eSpark-Consulting-Group/robertmeares-vcu-bcu/README.md

# robertMeares-VCU-BCU
PCB Rework on VCU/BCU
