eSpark-Consulting-Group/robertmeares-vcu-bcu/Client-Files/BCU-PCBA-main/BCU-PCBA-main/BCU-PCBA/CARRIER BOARD 2.0/GERBER/EMBL51745_PCB_CB_V2.0_DFM_202100719/SIENNA-8LAY-9JAN2021-20645.pdf

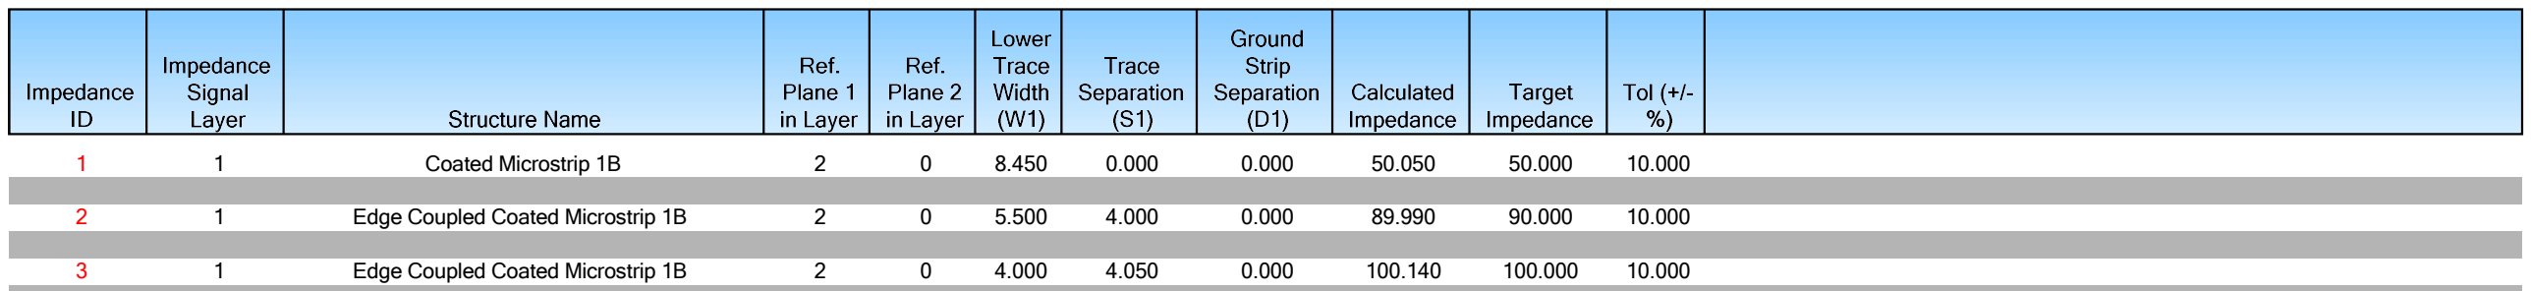
[picture p1: figure]
Coated Microstrip 1B; Edge Coupled Coated Microstrip 1B

StackName: Master
Version:
Date: 09-01-2021
Author:
Department: Engg. CAM
Site: www.hiqelectronics.com
Associated Documents: | Revision: | Modification: | Date of Revision: | Editor

Page
1/0
Copyright © | Print style & presentation copyright © Polar Instruments Ltd
Taiyo PSR 4000 HFX DI-GREEN | SolderMask | 1.000 | 3.500
1 | Copper Foil 12 microns | Copper | 1.850 | 100.000 | 1, 2, 3, 4, 5, 6, 7
Isola FR408 HR Prepreg 106-rc75 | Dielectric | 2.162 | 4.324 | 3.220
Isola FR408 HR Prepreg 106-rc75 | Dielectric | 2.162 | - | 3.220
2 | | | 0.689 | 60.000
Isola FR408 HR 8 mil core (2x3313)H/H | FR4 | 8.000 | 8.000 | 3.650
3 | | | 0.689 | 30.000 | 8, 9, 10, 11
Isola FR408 HR Prepreg 1080-rc65 | Dielectric | 2.921 | 7.942 | 3.420
Isola FR408 HR Prepreg 106-rc75 | Dielectric | 2.100 | - | 3.220
Isola FR408 HR Prepreg 1080-rc65 | Dielectric | 2.921 | - | 3.420
4 | | | 0.689 | 60.000
Isola FR408 HR 14 mil core H/H | FR4 | 14.000 | 14.000 | 3.780
5 | | | 0.689 | 60.000
Isola FR408 HR Prepreg 1080-rc65 | Dielectric | 2.921 | 7.942 | 3.420
Isola FR408 HR Prepreg 106-rc75 | Dielectric | 2.100 | - | 3.220
Isola FR408 HR Prepreg 1080-rc65 | Dielectric | 2.921 | - | 3.420
6 | | | 0.689 | 30.000 | 12, 13, 14, 15
Isola FR408 HR 8 mil core (2x3313)H/H | FR4 | 8.000 | 8.000 | 3.650
7 | | | 0.689 | 60.000
Isola FR408 HR Prepreg 106-rc75 | Dielectric | 2.162 | 4.324 | 3.220
Isola FR408 HR Prepreg 106-rc75 | Dielectric | 2.162 | - | 3.220
8 | Copper Foil 12 microns | Copper | 1.850 | 100.000 | 16, 17, 18, 19, 20, 21, 22
Taiyo PSR 4000 HFX DI-GREEN | SolderMask | 1.000 | 3.500 ⁶⁴.37 | 62.37
4 | 1 | Edge Coupled Coated Microstrip 2B | 3 | 0 | 4.100 | 4.800 | 0.000 | 120.060 | 120.000 | 10.000
5 | 1 | Coated Coplanar Strips With Lower Ground 1B | 2 | 0 | 7.500 | 0.000 | 8.000 | 50.210 | 50.000 | 10.000
6 | 1 | Coated Coplanar Strips With Lower Ground 2B | 3 | 0 | 20.000 | 0.000 | 8.000 | 49.940 | 50.000 | 10.000

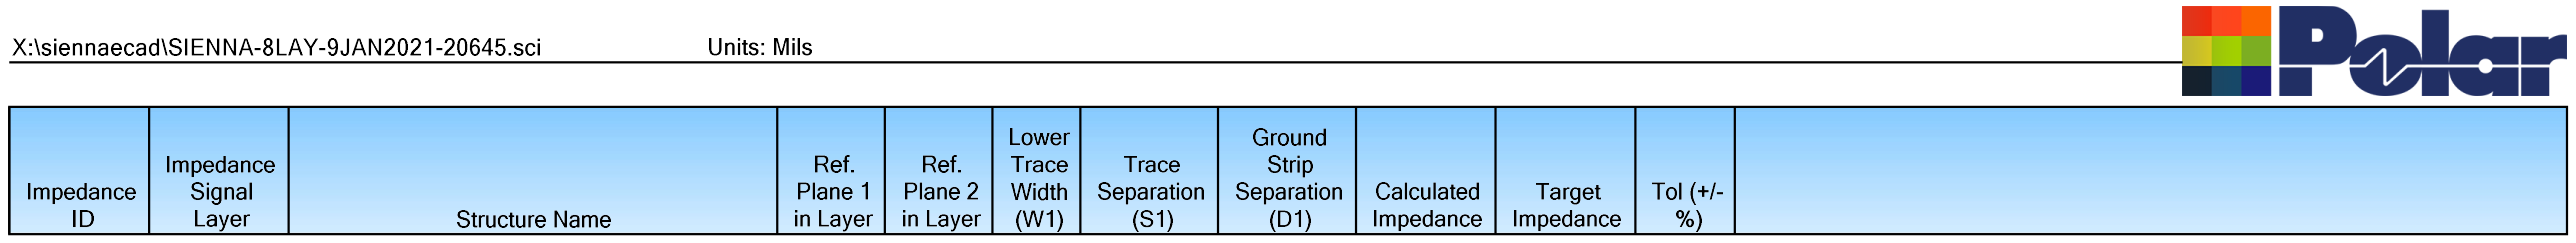
[picture p2: figure]

StackName:
Version:
Date: 09-01-2021
Author:
Department: Engg. CAM
Site: www.hiqelectronics.com
Associated Documents: | Revision: | Modification: | Date of Revision: | Editor

Page
2/0
Copyright © | Print style & presentation copyright © Polar Instruments Ltd
7 | 1 | Coated Coplanar Strips With Lower Ground 2B | 3 | 0 | 17.000 | 0.000 | 6.000 | 50.060 | 50.000 | 10.000
8 | 3 | Offset Stripline 1B1A | 2 | 4 | 8.150 | 0.000 | 0.000 | 49.990 | 50.000 | 10.000
9 | 3 | Edge Coupled Offset Stripline 1B1A | 2 | 4 | 6.100 | 4.000 | 0.000 | 90.140 | 90.000 | 10.000
10 | 3 | Edge Coupled Offset Stripline 1B1A | 2 | 4 | 4.550 | 4.000 | 0.000 | 100.020 | 100.000 | 10.000
11 | 3 | Offset Coplanar Strips 1B1A | 2 | 4 | 7.850 | 0.000 | 8.000 | 49.980 | 50.000 | 10.000
12 | 6 | Edge Coupled Offset Stripline 1B1A | 5 | 7 | 4.550 | 4.000 | 0.000 | 100.020 | 100.000 | 10.000
13 | 6 | Offset Stripline 1B1A | 5 | 7 | 8.150 | 0.000 | 0.000 | 49.990 | 50.000 | 10.000
14 | 6 | Edge Coupled Offset Stripline 1B1A | 5 | 7 | 6.100 | 4.000 | 0.000 | 90.140 | 90.000 | 10.000
15 | 6 | Offset Coplanar Strips 1B1A | 5 | 7 | 7.850 | 0.000 | 8.000 | 49.980 | 50.000 | 10.000
16 | 8 | Coated Microstrip 1B | 7 | 0 | 8.450 | 0.000 | 0.000 | 50.050 | 50.000 | 10.000
17 | 8 | Edge Coupled Coated Microstrip 1B | 7 | 0 | 4.000 | 4.050 | 0.000 | 100.140 | 100.000 | 10.000
18 | 8 | Edge Coupled Coated Microstrip 2B | 6 | 0 | 4.100 | 4.800 | 0.000 | 120.060 | 120.000 | 10.000
19 | 8 | Edge Coupled Coated Microstrip 1B | 7 | 0 | 5.500 | 4.000 | 0.000 | 89.990 | 90.000 | 10.000
20 | 8 | Coated Coplanar Strips With Lower Ground 2B | 6 | 0 | 20.000 | 0.000 | 8.000 | 49.940 | 50.000 | 10.000
21 | 8 | Coated Coplanar Strips With Lower Ground 2B | 6 | 0 | 17.000 | 0.000 | 6.000 | 50.060 | 50.000 | 10.000
22 | 8 | Coated Coplanar Strips With Lower Ground 1B | 7 | 0 | 7.500 | 0.000 | 8.000 | 50.210 | 50.000 | 10.000
