eSpark-Consulting-Group/robertmeares-vcu-bcu/Client-Files/BCU-PCBA-main/BCU-PCBA-main/BCU-PCBA/SECONDARY BOARD V2.1/GERBER/EMBL51745_PCB_SB_V2.1_DFM_20210914/Sienna- 4LYR-14Apr2K20-19615 -FR408HR---used.pdf

StackName: Master
Version:
Date: 14-04-2020
HANUMESH G: -
Department: Engg. CAM
Site: www.hiqelectronics.com
Associated Documents: | Revision: | Modification: | Date of Revision: | Editor

Page
1/1
Copyright © | Print style & presentation copyright © Polar Instruments Ltd
Taiyo PSR 4000 | SolderMask | 2.000 | | 4.400 | 0.0000
1 | 2.067 | 100.000 | 1, 2, 3, 4
Isola FR408 HR 5 mil core(1x2116) H/1 | FR4 | 5.000 | 5.000 | 3.670 | 0.0095
2 | 1.260 | 60.000
Isola FR408 HR Prepreg 3313 RC59 | Dielectric | 3.948 | 43.792 | 3.550 | 0.0000
Isola FR408 HR Prepreg 3313 RC59 | Dielectric | 3.948 | - | 3.550 | 0.0000
Isola FR408 HR 28 mil core H/H | FR4 | 28.000 | - | 3.730 | 0.0095
Isola FR408 HR Prepreg 3313 RC59 | Dielectric | 3.948 | - | 3.550 | 0.0000
Isola FR408 HR Prepreg 3313 RC59 | Dielectric | 3.948 | - | 3.550 | 0.0000
3 | 1.260 | 60.000
Isola FR408 HR 5 mil core(1x2116) 1/H | FR4 | 5.000 | 5.000 | 3.670 | 0.0095
4 | 2.067 | 100.000 | 5, 6, 7, 8
Taiyo PSR 4000 | SolderMask | 2.000 | | 4.400 | 0.0000

64.45

60.45

1 | 1 | Coated Microstrip 1B | 2 | 0 | 8.260 | 0.000 | 0.000 | 50.020 | 50.000 | 10.000
2 | 1 | Edge Coupled Coated Microstrip 1B | 2 | 0 | 5.400 | 5.000 | 0.000 | 90.300 | 90.000 | 10.000
3 | 1 | Edge Coupled Coated Microstrip 1B | 2 | 0 | 5.000 | 6.700 | 0.000 | 100.310 | 100.000 | 10.000
4 | 1 | Edge Coupled Coated Microstrip 1B | 2 | 0 | 4.000 | 11.200 | 0.000 | 120.110 | 120.000 | 10.000
5 | 4 | Coated Microstrip 1B | 3 | 0 | 8.260 | 0.000 | 0.000 | 50.020 | 50.000 | 10.000
6 | 4 | Edge Coupled Coated Microstrip 1B | 3 | 0 | 5.400 | 5.000 | 0.000 | 90.300 | 90.000 | 10.000
7 | 4 | Edge Coupled Coated Microstrip 1B | 3 | 0 | 5.000 | 6.700 | 0.000 | 100.310 | 100.000 | 10.000
8 | 4 | Edge Coupled Coated Microstrip 1B | 3 | 0 | 4.000 | 11.200 | 0.000 | 120.110 | 120.000 | 10.000
