eSpark-Consulting-Group/robertmeares-vcu-bcu/Client-Files/BCU-PCBA-main/BCU-PCBA-main/BCU-PCBA/SECONDARY BOARD V2.1/BOM/BOM_SB_BIU_S2 v2.2.xlsx

Index Revised: | 2022-11-18
Revision: | 2.2
Created by : | Suhas B
V2.2 | DNP Q3,Q4,R38,R39
V2.0 | Column I , J and K added for procrument of high lead time components
Note : Column J " In stock " status can be vary base on components availability on websites like digikey and mouser
Item | Quantity | Reference | Value | Description | Manufacturere's p/n | Manufacturer | Package | Component Type | In Stock | Lead time (weeks) | DNP | price per unit | Total Price | price per 1k units | Total price | Price per 100k units | Total price
1 | 17 | C1,C2,C4,C7,C8,C9,C11,C13,C18,C19,C20,C21,C22,C23,C24,C25,C33 | 0.1uF | CAP CER 0.1uF 16V 10% X7R 0402 | GRM155R71C104KA88J | MURATA | 402 | Capacitor | Yes | 19 | C22,C23,C24,C25 | $0.100 | $1.700 | $0.009 | $0.153 | $0.004 | $0.061
2 | 1 | C3 | 22uF | MLCC - SMD/SMT 22uF+/-20% 16V X5R | CL10A226MO7JZNC | SAMSUNG ELECTRO | 603 | Capacitor | Yes | 28 |  | $0.700 | $0.700 | $0.200 | $0.200 | $0.080 | $0.080
3 | 5 | C5,C10,C12,C14,C34 | 1uF | CAP CER 1uF 25V 10% X7R 0603 | CGA3E1X7R1E105K080AC | TDK | 603 | Capacitor | Yes | 14 |  | $0.170 | $0.850 | $0.037 | $0.185 | $0.015 | $0.074
4 | 6 | C6,C15,C16,C17,C26,C27 | 0.1uF | CAP CER 0.1UF 50V X7R 0603 | GRM188R72A104KA35D | MURATA | 603 | Capacitor | Yes | 31 |  | $0.280 | $1.680 | $0.060 | $0.360 | $0.024 | $0.144
5 | 3 | C30,C31,C32 | 1nF | CAP CER 1000PF 2KV X7R 1206 | CL31B102KJHNNNE | Samsung Electro-Mechanics | 1206 | Capacitor | Yes | 28 | C31,C32
6 | 4 | D18,D19,D20,D21 | RRE07VTM6SFHTR | RECTIFIER DIODES | RRE07VTM6SFHTR | Rohm Semiconductor | 2-SMD, Flat Lead | Diode | Yes | 15 | D20,D21 | $0.370 | $1.480 | $0.090 | $0.360 | $0.036 | $0.144
7 | 1 | J1 | FX23-20S-0.5SV | CONN RCPT 20POS SMD GOLD | FX23-20S-0.5SV | Hirose Electric Co Ltd | PTH/SMD | Connector | No | 12 |  | $2.700 | $2.700 | $1.450 | $1.450 | $0.580 | $0.580
8 | 1 | J2 | MX23A18NF1 | Automotive Connectors 18P Std Pin Header | MX23A18NF1 | JAE Electronics |  | Connector | Yes | 17 |  | $8.230 | $8.230 | $4.900 | $4.900 | $1.960 | $1.960
9 | 2 | L16,L22 | 220R@100MHz | FERRITEBEAD SMD Z100MHZ=600OHM 2 | BLM21SP601SH1D | Murata Electronics | 805 | Inductor | Yes | 19 |  | $0.290 | $0.580 | $0.090 | $0.180 | $0.036 | $0.072
10 | 4 | L18,L19,L20,L21 | MPZ2012S102AT000 | FERRITE BEAD 1 KOHM 0805 1LN | MPZ2012S102AT000 | TDK Corporation | 805 | Inductor | No | 10 | L20,L21 | $0.110 | $0.440 | $0.029 | $0.116 | $0.012 | $0.046
11 | 5 | L23,L24,L25,L26,L27 | BLM21AG121SZ1D | Ferrite Beads 0805 120ohms 1000mA Auto Infotainment | BLM21AG121SZ1D | Murata Electronics | 805 | Inductor | Yes | 8 |  | $0.140 | $0.700 | $0.040 | $0.200 | $0.016 | $0.080
12 | 2 | Q1,Q2 | TLX9000(TPL,F | Transistor Output Optocouplers Transistor Coupler Automotive; | TLX9000(TPL,F | Toshiba | SO-4 | Transistor | Yes | 7 |  | $2.900 | $5.800 | $1.100 | $2.200 | $0.440 | $0.880
13 | 13 | R1,R2,R3,R8,R9,R10,R15,R28,R29,R31,R33,R35,R37 | 10K | RES SMD 10K OHM 1% 1/10W 0603 | RCA060310K0FKEA | Vishay Dale | 603 | Resistor | Yes | 14 | R1,R35,R37 | $0.100 | $1.300 | $0.010 | $0.130 | $0.004 | $0.052
14 | 2 | R17,R19 | 1K | RES SMD 1K OHM 0.1% 1/10W 0603 | RT0603BRD071KL | Yageo | 603 | Resistor | Yes | 24 |  | $0.100 | $0.200 | $0.040 | $0.080 | $0.016 | $0.032
15 | 4 | R11,R12,R13,R14 | 0E | RES 0.0 OHM 1/16W 0402 SMD | CRCW04020000Z0ED | VISHAY | 402 | Resistor | Yes | 35 |  | $0.100 | $0.400 | $0.005 | $0.020 | $0.002 | $0.008
16 | 4 | R30,R32,R34,R36 | 47K | RES SMD 47K OHM 5% 1/10W 0603 | AC0603JR-0747KL | Yageo | 603 | Resistor | Yes | 29 | R34,R36 | $0.100 | $0.400 | $0.005 | $0.020 | $0.002 | $0.008
17 | 2 | R16,R18 | DNP | Thick Film Resistors - SMD 1/10Watt 0ohms | CRCW06030000Z0EAC | Vishay / Dale | 603 | Resistor | Yes | 24 | R16,R18 | $0.100 | $0.200 | $0.005 | $0.010 | $0.002 | $0.004
18 | 1 | U1 | TPS2024IDRQ1 | Power Switch ICs - Power Distribution Auto Cat Pwr-Dist Sw | TPS2024IDRQ1 | TI | SOIC-8 | IC | Yes | 16 |  | $2.460 | $2.460 | $1.130 | $1.130 | $0.452 | $0.452
19 | 1 | U2 | TCA6408AQPWRQ1 | Interface - I/O Expanders Automotive Low-Voltage 8-Bit I2C | TCA6408AQPWRQ1 | TI | TSSOP-16 | IC | Yes | 6 |  | $1.600 | $1.600 | $0.600 | $0.600 | $0.240 | $0.240
20 | 1 | U5 | TPL7407LADR | Gate Drivers 30-V, 7-Channel NMOS Array Low-Side Driver | TPL7407LADR | TI | SOP-16 | IC | Yes | 6 |  | $0.630 | $0.630 | $0.200 | $0.200 | $0.080 | $0.080
21 | 1 | U11 | ADS1015IDGSR | Analog to Digital Converters - ADC 12B ADC with Int MUX | ADS1015IDGSR | TI | MSOP-10 | IC | Yes | 35 |  | $2.660 | $2.660 | $1.330 | $1.330 | $0.532 | $0.532
22 | 1 | U12 | HDC2021DEBT | Board Mount Humidity Sensors Low-power humidity and temperature digital sensor | HDC2021DEBT | TI | 6-WSON | IC | Yes | 6 |  | $4.560 | $4.560 | $2.300 | $2.300 | $0.920 | $0.920
23 | 2 | U3,U4 | G6K-2F-Y-DC12 | Low Signal Relays - PCB Gullwing NoLatch 3.2 DPDT 12VDC 100mW | G6K-2F-Y-DC12 | Omron Electronics | 8-PIN RELAY | IC | Yes | 14 |  | $4.000 | $8.000 | $2.300 | $4.600 | $0.920 | $1.840
24 | 3 | U6,U13,U14 | G6L-1F-DC12 | Low Signal Relays - PCB LO PROF SPST 12VDC | G6L-1F-DC12 | Omron Electronics | 8-PIN RELAY | IC | Yes | 26 |  | $2.900 | $8.700 | $1.700 | $5.100 | $0.680 | $2.040
25 | 5 | D22,D23,D24,D25,D26 | LL4148-GS08 | DIODE GEN PURP 75V 300MA SOD80 | Vishay Semiconductor | LL4148-GS08 | Mini melf | Diode | Yes | 43 |  | $0.140 | $0.700 | $0.020 | $0.100 | $0.008 | $0.040
26 | 2 | Q3,Q4 | DNP | DNP | DNP | DNP | SOT-23 | DNP | Yes | 26
27 | 2 | R38,R39 | DNP | DNP | DNP | DNP | 603 | DNP | Yes | 20
Discussion of V2.2 |  |  |  |  |  |  |  |  |  |  |  | TOTAL | $56.670 |  | $25.924 |  | $10.370
Q3 and Q4 footprint in layout, schematic, and BOM all disagree.
V2.1 FOOTPRINT FOR Q3, Q4 |  |  |  | V2.1 SCHEMATIC | PINOUT FROM MMBT3904-TP DATASHEET
Solution:
DNP effected parts, could not find a sub.
26 | 2 | Q3,Q4 | MMBT3904-TP | TRANS NPN 40V 0.2A SOT23 | MMBT3904-TP | Micro Commercial Co | SOT-23 | Transistor | Yes | 26 |  | $0.140 | $0.280 | $0.029 | $0.057 | $0.011 | $0.023
27 | 2 | R38,R39 | 1K2 | RES SMD 1.2K OHM 1% 1/10W 0603 | RC0603FR-071K2L | Yageo | 603 | Resistor | Yes | 20 |  | $0.100 | $0.200 | $0.004 | $0.008 | $0.002 | $0.003
