eSpark-Consulting-Group/robertmeares-vcu-bcu/BOM_CB_BIU_S2v2.0_Changes.xlsx

Sheet: CARRIER_BOARD_S2_V2.0
1 | 2 | C1,C142 | 22uF | CAP CER 22UF 10V X5R 0805 | TDK Corporation | C2012X5R1A226M125AB | 805 | Capacitor | Yes | 13 |  | 0.310 | 0.620 | 0.135 | 0.270 | 0.054 | 0.108 | #VALUE!
2 | 5 | C2,C3,C4,C5,C6 | 4.7uF | CAP CER 4.7UF 10V X5R 0603 | TDK Corporation | C1608X5R1A475K080AE | 603 | Capacitor | Yes | NA |  | 0.290 | 1.450 | 0.074 | 0.370 | 0.030 | 0.148
3 | 43 | C7,C10,C11,C12,C13,C16,C19,C20,C23,C24,C25,C26,C30,C33,C35,C36,C38,C39,C40,C41,C43,C44,C46,C49,C53,C54,C55,C56,C57,C58,C59,C60,C71,C75,C77,C80,C100,C111,C125,C130,C131,C132,C148 | 100nF | CAP CER 0402 0.1UF 16V X7R 10% | KEMET | C0402C104K4REC7867 | 402 | Capacitor | Yes | 19 |  | 0.120 | 5.160 | 0.220 | 9.460 | 0.088 | 3.784
4 | 2 | C8,C9 | 10uF | CAP CER 10UF 10V X5R 0603 | Samsung Electro-Mechanics | CL10A106KP8NNNC | 603 | Capacitor | No | 28 |  | 0.210 | 0.420 | 0.040 | 0.080 | 0.016 | 0.032
5 | 2 | C14,C15 | 15pF | CAP CER 15PF 100V NP0 0805 | AVX Corporation | 08051A150FAT2A | 805 | Capacitor | Yes | 17 |  | 0.590 | 1.180 | 0.170 | 0.340 | 0.068 | 0.136
6 | 4 | C17,C18,C27,C28 | 10uF | CAP CER 10UF 16V X5R 0603 | Taiyo Yuden | EMK107BBJ106MA-T | 603 | Capacitor | Yes | 16 |  | 0.340 | 1.360 | 0.089 | 0.356 | 0.036 | 0.142
7 | 4 | C21,C22,C86,C87 | 10nF | CAP CER 10000PF 50V X7R 0402 | KEMET | C0402C103K5RAC7411 | 402 | Capacitor | Yes | 24 |  | 0.100 | 0.400 | 0.008 | 0.032 | 0.003 | 0.013
8 | 1 | C29 | 22uF | CAP CER 22UF 10V X5R 0805 | Samsung Electro-Mechanics | CL21A226KPCLRNC | 805 | Capacitor | Yes | 28 |  | 0.100 | 0.100 | 0.015 | 0.015 | 0.006 | 0.006
9 | 3 | C34,C42,C45 | 1nF,2KV | CAP CER 1000PF 2KV X7R 1206 | Samsung Electro-Mechanics | CL31B102KJHNNNE | 1206 | Capacitor | Yes | 28 |  | 0.300 | 0.900 | 0.080 | 0.240 | 0.032 | 0.096
10 | 7 | C37,C98,C99,C109,C110,C145,C146 | 47uF | CAP CER 47UF 16V X5R 1210 | Taiyo Yuden | EMK325BJ476MM-P | 1210 | Capacitor | Yes | 9 | C146 | 0.680 | 4.760 | 0.216 | 1.512 | 0.086 | 0.605
11 | 2 | C47,C50 | 100uF | CAP CER 100UF 16V X5R 1210 | Taiyo Yuden | EMK325ABJ107MM-P | 1210 | Capacitor | Yes | 22 |  | 1.600 | 3.200 | 0.613 | 1.226 | 0.245 | 0.490
12 | 1 | C72 | 100uF | CAP CER 100UF 10V X5R 1206 | TDK Corporation | C3216X5R1A107M160AC | 1206 | Capacitor | Yes | 18 |  | 1.030 | 1.030 | 0.370 | 0.370 | 0.148 | 0.148
13 | 2 | C48,C51 | 1nF | CAP CER 1000PF 50V X7R 0402 | KEMET | C0402S102K5RAC7867 | 402 | Capacitor | Yes | 21 |  | 0.470 | 0.940 | 0.123 | 0.246 | 0.049 | 0.098
14 | 4 | C52,C63,C67,C69 | 10uF | CAP CER 10UF 10V X5R 0603 | Murata Electronics | GRM188R61A106KE69D | 603 | Capacitor | Yes | 22 |  | 0.200 | 0.800 | 0.042 | 0.168 | 0.017 | 0.067
15 | 2 | C64,C68 | 0.33uF | CAP CER 0.33UF 16V X7R 0603 | TDK Corporation | C1608X7R1C334K080AC | 603 | Capacitor | Yes | 35 |  | 0.120 | 0.240 | 0.023 | 0.046 | 0.009 | 0.018
16 | 1 | C76 | 22uF | CAP CER 22UF 10V X7R 1206 | Samsung Electro-Mechanics | CL31B226MPHNNNE | 1206 | Capacitor | Yes | 28 |  | 0.350 | 0.350 | 0.100 | 0.100 | 0.040 | 0.040
17 | 8 | C78,C79,C81,C82,C83,C84,C85,C147 | 100PF | CAP CER 100PF 50V NP0 0603 | TDK Corporation | C1608NP01H101J080AA | 603 | Capacitor | No | 19 | C78,C79,C81,C82,C83,C84,C85,C147 | 0.180 | 1.440 | 0.039 | 0.312 | 0.016 | 0.125
18 | 4 | C88,C89,C90,C92 | 4.7uF | CAP CER 4.7UF 50V X5R 1210 | Taiyo Yuden | UMK325BJ475MM-T | 1210 | Capacitor | Yes | 8 |  | 0.710 | 2.840 | 0.190 | 0.760 | 0.076 | 0.304
19 | 7 | C91,C96,C97,C107,C108,C143,C144 | 100nF | CAP CER 0.1UF 100V X7R 0603 | Murata Electronics | GRJ188R72A104KE11D | 603 | Capacitor | Yes | 19 |  | 0.280 | 1.960 | 0.570 | 3.990 | 0.228 | 1.596
20 | 1 | C93 | 2.2uF | CAP CER 2.2UF 50V X5R 1206 | Taiyo Yuden | UMK316BJ225KD-T | 1206 | Capacitor | Yes | 11 |  | 0.290 | 0.290 | 0.060 | 0.060 | 0.024 | 0.024
21 | 1 | C94 | 100uF | CAP ALUM 100UF 20% 35V SMD | Nichicon | UCL1V101MCL6GS | SMD | Capacitor | Yes | 29 | C94 | 0.620 | 0.620 | 0.410 | 0.410 | 0.164 | 0.164
22 | 2 | C95,C106 | 10uF | CAP CER 10UF 35V X7R 1206 | TDK Corporation | C3216X7R1V106K160AC | 1206 | Capacitor | Yes | 24 |  | 0.700 | 1.400 | 0.250 | 0.500 | 0.100 | 0.200
23 | 2 | C101,C112 | 2.2uF | CAP CER 2.2UF 10V X7R 0603 | TDK Corporation | C1608X7R1A225K080AC | 603 | Capacitor | Yes | 21 |  | 0.200 | 0.400 | 0.040 | 0.080 | 0.016 | 0.032
24 | 3 | C102,C113,C139 | 0.1UF | CAP CER 0402 0.1UF 16V X7R 10% | KEMET | C0402C104K4REC7867 | 402 | Capacitor | Yes | 19 | C102,C113,C139 | 0.120 | 0.360 | 0.022 | 0.066 | 0.009 | 0.026
25 | 2 | C103,C114 | 3.9uF | CAP CER 3.9PF 100V NP0 0603 | AVX Corporation | 06031A3R9CAT2A | 603 | Capacitor | Yes | 16 |  | 0.240 | 0.480 | 0.050 | 0.100 | 0.020 | 0.040
26 | 2 | C104,C115 | 1000pF | CAP CER 1000PF 100V C0G 0603 | TDK Corporation | C1608C0G2A102J080AA | 603 | Capacitor | Yes | 27 |  | 0.190 | 0.380 | 0.400 | 0.800 | 0.160 | 0.320
27 | 3 | C116,C117,C118 | 1nF | CAP CER 1000PF 2KV X7R 1206 | Samsung Electro-Mechanics | CL31B102KJHNNNE | 1206 | Capacitor | Yes | 28 |  | 0.340 | 1.020 | 0.080 | 0.240 | 0.032 | 0.096
28 | 1 | C126 | 3pF | CAP CER 3PF 50V C0G/NP0 0402 | Murata Electronics | GJM1555C1H3R0WB01D | 402 | Capacitor | Yes | 15 |  | 0.240 | 0.240 | 0.056 | 0.056 | 0.022 | 0.022
29 | 1 | C127 | 0.8pF | CAP CER 0.8PF 50V C0G/NP0 0402 | Johanson Technology Inc. | 500R07S0R8AV4T | 402 | Capacitor | Yes | 14 |  | 0.260 | 0.260 | 0.055 | 0.055 | 0.022 | 0.022
30 | 2 | C128,C129 | 3PF | CAP CER 3PF 50V C0G/NP0 0402 | Murata Electronics | GJM1555C1H3R0WB01D | 402 | Capacitor | Yes | 15 | C128,C129 | 0.240 | 0.480 | 0.560 | 1.120 | 0.224 | 0.448
31 | 2 | C140,C141 | 2.2PF | CAP CER 2.2PF 50V C0G/NP0 0402 | Samsung Electro-Mechanics | CL05C2R2BB5NNNC | 402 | Capacitor | Yes | 15 | C140,C141 | 0.100 | 0.200 | 0.010 | 0.020 | 0.004 | 0.008
32 | 1 | C134 | 1uF | 1µF ±10% 25V Ceramic Capacitor X5R 0603 (1608 Metric) | Samsung Electro-Mechanics | CL10A105KA8NNNC | 603 | Capacitor | Yes | 28 |  | 0.100 | 0.100 | 0.008 | 0.008 | 0.003 | 0.003
33 | 7 | C62,C70,C74,C135,C136,C137,C138 | 33pF | 33pF ±5% 50V Ceramic Capacitor C0G, NP0 0603 (1608 Metric) | KEMET | C0603C330J5GACTU | 603 | Capacitor | Yes | 23 |  | 0.150 | 1.050 | 0.028 | 0.196 | 0.011 | 0.078
34 | 4 | D1,D2,D3,D34 | PESD2CAN | TVS DIODE 24V 41V SOT23 | Nexperia USA Inc. | PESD2CAN,215 | SOT23 | Diode | Yes | 26 |  | 0.420 | 1.680 | 0.100 | 0.400 | 0.040 | 0.160
35 | 1 | D4 | PZU3.9B2A,115 | DIODE ZENER 3.9V 320MW SOD323 | Nexperia USA Inc. | PZU3.9B2A,115 | SOD-323 | Diode | Yes | 26 |  | 0.210 | 0.210 | 0.016 | 0.016 | 0.006 | 0.006
36 | 16 | D5,D6,D8,D10,D11,D12,D13,D15,D17,D19,D20,D21,D23,D25,D31,D33 | BAS316,115 | DIODE GEN PURP 100V 250MA SOD323 | Nexperia USA Inc. | BAS316,115 | SOD-323 | Diode | No | 26 |  | 0.120 | 1.920 | 0.020 | 0.320 | 0.008 | 0.128
37 | 9 | D7,D9,D14,D16,D18,D22,D24,D27,D32 | DIODE TS BI-DIR | TVS DIODE 14V 23.2V DO214AC | Vishay Semiconductor Diodes Division | SMAJ14CA-E3/61 | DO-214AC, SMA | Diode | Yes | 40 |  | 0.410 | 3.690 | 0.100 | 0.900 | 0.040 | 0.360
38 | 1 | D30 | LL4148-GS08 | DIODE GEN PURP 75V 300MA SOD80 | Vishay Semiconductor | LL4148-GS08 | Mini melf | Diode | Yes | 43 |  | 0.140 | 0.140 | 0.020 | 0.020 | 0.008 | 0.008
39 | 2 | D28,D29 | SMBJ28A-13-F | TVS DIODE 28V 45.4V SMB | Diodes Incorporated | SMBJ28A-13-F | DO-214AA, SMB | Diode | Yes | 27 |  | 0.410 | 0.820 | 0.100 | 0.200 | 0.040 | 0.080
40 | 1 | E1 | ACAG0301-24505500-T | RF ANT 2.4GHZ/5.5GHZ CHIP SLD | Abracon LLC | ACAG0301-24505500-T | SMD | Antenna | Yes | 15 |  | 1.840 | 1.840 | 0.900 | 0.900 | 0.360 | 0.360
41 | 1 | E2 | ACAR3705-S698 | LTE anteena | Abracon LLC | ACAR3705-S698 | SMD | Antenna | Yes | NA |  | 4.620 | 4.620 | 3.300 | 3.300 | 1.320 | 1.320
42 | 1 | F1 | 5A | FUSE BRD MNT 5A 32VAC 75VDC 1206 | Littelfuse Inc. | 0458005.DR | 1206 | Fuse | Yes | 13 |  | 1.380 | 1.380 | 0.600 | 0.600 | 0.240 | 0.240
43 | 1 | F2 | 1A | FUSE BRD MNT 1A 48VAC 75VDC 1206 | Littelfuse Inc. | 0458001.DR | 1206 | Fuse | Yes | 13 |  | 1.380 | 1.380 | 0.600 | 0.600 | 0.240 | 0.240
44 | 1 | J1 | A829-1J1T-KM | MAGJACK 1PORT 1GBT LED, Auto-Ethernet | Bel Fuse Inc. | A829-1J1T-KM | Through Hole | Connector | Yes | 16 |  | 6.300 | 6.300 | 3.850 | 3.850 | 1.540 | 1.540
45 | 1 | J2 | MX50B19NQ1 | Automotive HDMI Type E Connector, 19 pos., Receptacle, Without Flange | JAE Electronics | MX50B19NQ1 | PTH | Connector | Yes | 18 |  | 5.400 | 5.400 | 3.160 | 3.160 | 1.264 | 1.264 |  | https://findcomponents.net/MX50B19NQ1
46 | 1 | J3 | 484060003 | USB Connectors USB 3.0 Type A Stacked R/A DIP | Molex | 484060003 | PTH | Connector | Yes | 20 |  | 2.100 | 2.100 | 1.180 | 1.180 | 0.472 | 0.472
47 | 1 | J4 | PJS008-2003-0 | Memory Card Connectors REVERSE MNT MICRO SD PUSH-PUSH TYPE | Yamaichi Electronics | PJS008-2003-0 | SMD | Connector | Yes | 9 |  | 3.080 | 3.080 | 1.590 | 1.590 | 0.636 | 0.636
48 | 1 | J5 | HTSW-105-07-G-D | CONN HEADER VERT 10POS 2.54MM | Samtec Inc. | HTSW-105-07-G-D | 10 PIN PTH | Connector | Yes | 10 |  | 1.280 | 1.280 | 0.700 | 0.700 | 0.280 | 0.280
49 | 1 | J6 | FMS006 - 2610 - 0 | PUSH-PUSH SIM CARD CONNECTOR, SM | Yamaichi Electronics | FMS006 - 2610 - 0 | SMD | Connector | Yes | 15 |  | 1.860 | 1.860 | 1.130 | 1.130 | 0.452 | 0.452
50 | 1 | J7 | MX23A26NF1 | Automotive Connectors 26P Std Pin Header | JAE Electronics | MX23A26NF1 | PTH | Connector | No | 14 |  | 8.230 | 8.230 | 4.900 | 4.900 | 1.960 | 1.960
51 | 1 | J10 | FX23-20P-0.5SV15 | CONN HDR 20POS SMD GOLD | Hirose Electric Co Ltd | FX23-20P-0.5SV15 | PTH/SMD | Connector | Yes | 12 |  | 3.560 | 3.560 | 1.920 | 1.920 | 0.768 | 0.768
52 | 1 | J12 | RECE-20279-001E-01 | CONN UMC RCPT STR 50 OHM SMD | Taoglas Limited | RECE.20279.001E.01 | SMD | Connector | Yes | 14 |  | 0.900 | 0.900 | 0.750 | 0.750 | 0.300 | 0.300
53 | 1 | J13 | U.FL-R-SMT-1 | RF Connectors / Coaxial Connectors SMT ML REC AU 50 OHM W/ANTI SLDR WCKNG RL | Hirose Connector | U.FL-R-SMT-1(10) | SMD | Connector | Yes | 12 | J13 | 1.220 | 1.220 | 0.670 | 0.670 | 0.268 | 0.268
54 | 1 | J14 | DNP | DNP | DNP | DNP | DNP | DNP | Yes
55 | 1 | J16 | SJ107054 | CONN HEADER BRD EDGE 2POS 3.5MM | JAE Electronics | MX44002NF1 | PTH | HEADER Connector | Yes | 14 |  | 4.850 | 4.850 | 2.812 | 2.812 | 1.125 | 1.125
56 | 3 | L1,L18,L19 | 33R@100MHz | FERRITE BEAD 33 OHM 0603 1LN | Murata Electronics | BLM18PG330SH1D | 603 | Inductor | Yes | 22 |  | 0.800 | 2.400 | 0.360 | 1.080 | 0.144 | 0.432
57 | 3 | L4,L5,L6 | PE-1812ACC510STS | CMC 230MA 2LN 3.5 KOHM AEC-Q200 | Pulse Electronics Network | PE-1812ACC510STS | Horizontal, 4 PC Pad | Inductor | Yes | 18 |  | 0.920 | 2.760 | 0.540 | 1.620 | 0.216 | 0.648
58 | 6 | L7,L9,L11,L12,L13,L14 | 220R@100MHz | FERRITE BEAD 220 OHM 0603 1LN | Murata Electronics | BLM18EG221TN1D | 603 | Inductor | Yes | 11 |  | 0.200 | 1.200 | 0.060 | 0.360 | 0.024 | 0.144
59 | 2 | L8,L10 | MCZ1210DH900L2TA0G | CMC 100MA 2LN 90 OHM SMD | MCZ1210DH900L2TA0G | MCZ1210DH900L2TA0G | Surface Mount | Inductor | Yes | 15 |  | 0.580 | 1.160 | 0.230 | 0.460 | 0.092 | 0.184
60 | 1 | L15 | DLM0NSN900HY2D | CMC 100MA 2LN 90 OHM SMD | Murata Electronics | DLM0NSN900HY2D | SMD | Inductor | Yes | 8 |  | 0.150 | 0.150 | 0.060 | 0.060 | 0.024 | 0.024
61 | 2 | L16,L17 | 1uH | Fixed Inductors 1uH Shld 20% 18A 6.18mOhms AECQ2 | coilcraft | XAL6030-102MEB | SMD | Inductor | Yes | 7 |  | 1.850 | 3.700 | 0.877 | 1.754 | 0.351 | 0.702
62 | 3 | L22 ,L23,L24 | 6.8nH | FIXED IND 6.8NH 1.45A 68 MOHM | Murata Electronics | LQW15AN6N8G80D | 402 | Inductor | Yes | 11 | L23,L24 | 0.240 | 0.720 | 0.990 | 2.970 | 0.396 | 1.188
63 | 2 | L25,L26 | 100 Ohms @ 100MHz | FERRITE BEAD 100 OHM 0603 1LN | Murata Electronics | BLM18EG101TN1D | 603 | Inductor | Yes | 11 |  | 0.240 | 0.480 | 0.990 | 1.980 | 0.396 | 0.792
64 | 1 | L27 | 60 Ohms@100MHz | FERRITE BEAD 60 OHM 1806 1LN | Murata Electronics | BLM41PG600SH1L | 1806 | Inductor | Yes | 12 |  | 0.350 | 0.350 | 0.120 | 0.120 | 0.048 | 0.048
65 | 2 | Q1,Q2 | DTC043ZEBTL | TRANS PREBIAS NPN 50V EMT3F | Rohm Semiconductor | DTC043ZEBTL | EMT3F | Transistor | Yes | 45 |  | 0.160 | 0.320 | 0.330 | 0.660 | 0.132 | 0.264
66 | 1 | Q3 | BSS64,215 | TRANS NPN 80V 100MA TO236AB | Nexperia USA Inc. | BSS64,215 | SOT-23-3 | Transistor | Yes | 26 |  | 0.340 | 0.340 | 0.066 | 0.066 | 0.026 | 0.026
67 | 18 | R1,R18,R19,R20,R21,R64,R65,R147,R149,R150,R151,R152,R153,R158,R159,R161,R164,R165 | 0R | RES SMD 0 OHM JUMPER 1/10W 0402 | Panasonic Electronic Components | ERJ-2GE0R00X | 402 | Resistor | No | 18 | R153,R158,R159 | 0.100 | 1.800 | 0.003 | 0.054 | 0.001 | 0.022
68 | 8 | R2,R3,R4,R5,R10,R11,R169,R170 | 60R | RES SMD 60.4 OHM 1% 1/10W 0603 | Yageo | RC0603FR-0760R4L | 603 | Resistor | Yes | 29 |  | 0.100 | 0.800 | 0.003 | 0.024 | 0.001 | 0.010
69 | 13 | R6,R8,R9,R12,R23,R24,R41,R42,R43,R44,R135,R162,R163 | 4.7K | RES SMD 4.7K OHM 0.1% 1/10W 0603 | Panasonic Electronic Components | ERA-3AEB472V | 603 | Resistor | Yes | 24 | R8,R12 | 0.310 | 4.030 | 0.042 | 0.546 | 0.017 | 0.218
70 | 22 | R84,R85,R88,R89,R90,R91,R93,R94,R95,R96,R97,R98,R99,R100,R101,R102,R103,R104,R105,R124,R125,R171 | 22R | RES ARRAY 4 RES 22 OHM 1206 | Yageo | YC164-JR-0722RL | 1206 | Resistor | Yes | 23 |  | 0.100 | 2.200 | 0.014 | 0.308 | 0.006 | 0.123
71 | 3 | R14,R16,R15 | 150R | CRGCQ 0402 150R 1% | TE Connectivity Passive Product | CRGCQ0402F150R | 402 | Resistor | Yes | 16 | R15 | 0.100 | 0.300 | 0.003 | 0.009 | 0.001 | 0.004
72 | 3 | R17,R22,R25 | 1M | CRGCQ 0402 1M0 5% | TE Connectivity Passive Product | CRGCQ0402J1M0 | 402 | Resistor | Yes | 16 |  | 0.100 | 0.300 | 0.002 | 0.006 | 0.001 | 0.002
73 | 1 | R26 | 33K | CRGCQ 0402 33K 5% | TE Connectivity Passive Product | CRGCQ0402J33K | 402 | Resistor | Yes | 16 |  | 0.100 | 0.100 | 0.002 | 0.002 | 0.001 | 0.001
74 | 4 | R27,R28,R29,R30 | 68K | RES SMD 68K OHM 5% 1/16W 0402 | Yageo | RC0402JR-0768KL | 402 | Resistor | Yes | 29 |  | 0.100 | 0.400 | 0.002 | 0.008 | 0.001 | 0.003
75 | 6 | R31,R33,R60,R61,R62,R63 | 100K | RES SMD 100K OHM 5% 1/16W 0402 | Yageo | RC0402JR-07100KL | 402 | Resistor | Yes | 20 |  | 0.100 | 0.600 | 0.002 | 0.012 | 0.001 | 0.005
76 | 1 | R34 | 2.7K | RES SMD 2.7K OHM 1% 1/10W 0603 | Panasonic Electronic Components | ERA-3AEB272V | 603 | Resistor | Yes | 24 |  | 0.100 | 0.100 | 0.005 | 0.005 | 0.002 | 0.002
77 | 1 | R35 | 1.3K | RES SMD 1.3K OHM 0.1% 1/10W 0603 | Yageo | RT0603BRD071K3L | 603 | Resistor | Yes | 23 |  | 0.650 | 0.650 | 0.129 | 0.129 | 0.052 | 0.052
78 | 2 | R166,R126 | 10K | RES SMD 10K OHM 1% 1/10W 0603 | Vishay Dale | RCA060310K0FKEA | 603 | Resistor | Yes | 14 | R127 | 0.100 | 0.200 | 0.011 | 0.022 | 0.004 | 0.009
79 | 7 | R45,R46,R49,R50,R51,R55,R167 | 11K | RES SMD 11K OHM 0.5% 1/10W 0603 | Yageo | RT0603DRD0711KL | 603 | Resistor | Yes | 23 |  | 0.170 | 1.190 | 0.020 | 0.140 | 0.008 | 0.056
80 | 7 | R47,R48,R52,R53,R54,R57,R168 | 3.3K | RES 3.3K OHM 0.5% 1/10W 0603 SMD | Panasonic Electronic Components | ERJ-U3RD3301V | 603 | Resistor | Yes | 28 |  | 0.230 | 1.610 | 0.030 | 0.210 | 0.012 | 0.084
81 | 2 | R56,R58 | 22K | RES SMD 22K OHM 0.5% 1/10W 0603 | Yageo | RT0603DRD0722KL | 603 | Resistor | Yes | 23 |  | 0.170 | 0.340 | 0.020 | 0.040 | 0.008 | 0.016
82 | 1 | R59 | 2.2K | RES 3.3K OHM 0.5% 1/10W 0603 SMD | Panasonic Electronic Components | ERA-3AED222V | 603 | Resistor | Yes | 24 |  | 0.100 | 0.100 | 0.015 | 0.015 | 0.006 | 0.006
83 | 6 | R68,R70,R76,R78,R155,R156 | 0R | RES SMD 0 OHM JUMPER 1/10W 0603 | Panasonic Electronic Components | ERJ-3GEY0R00V | 603 | Resistor | Yes | 31 | R156 | 0.100 | 0.600 | 0.005 | 0.030 | 0.002 | 0.012
84 | 6 | R72,R80,R69,R71,R77,R79 | 100K | RES SMD 100K OHM 1% 1/10W 0603 | Yageo | RC0603FR-07100KL | 603 | Resistor | Yes | 29 | R69,R71,R77,R79 | 0.100 | 0.600 | 0.005 | 0.030 | 0.002 | 0.012
85 | 6 | R37,R38,R39,R40,R73,R81 | 0R | RES SMD 0 OHM JUMPER 1/10W 0603 | Panasonic Electronic Components | ERJ-3GEY0R00V | 603 | Resistor | Yes | 31 | R38,R40,R73,R81 | 0.100 | 0.600 | 0.050 | 0.300 | 0.020 | 0.120
86 | 2 | R74,R83 | 39K | RES SMD 39K OHM 1% 1/10W 0603 | Panasonic Electronic Components | ERJ-3EKF3902V | 603 | Resistor | Yes | 31 |  | 0.100 | 0.200 | 0.050 | 0.100 | 0.020 | 0.040
87 | 2 | R75,R82 | 12K | RES SMD 12K OHM 1% 1/10W 0603 | Panasonic Electronic Components | ERJ-3EKF1202V | 603 | Resistor | Yes | 31 |  | 0.100 | 0.200 | 0.050 | 0.100 | 0.020 | 0.040
88 | 14 | R106,R107,R116,R117,R118,R119,R120,R121,R122,R123,R131,R132,R133,R134 | 22R | CRGCQ 0402 22R 5% | TE Connectivity Passive Product | CRGCQ0402J22R | 402 | Resistor | Yes | 16 |  | 0.100 | 1.400 | 0.050 | 0.700 | 0.020 | 0.280
89 | 8 | R110,R111,R112,R113,R114,R115,R128,R129 | 0R | RES SMD 0 OHM JUMPER 1/16W 0402 | Yageo | RC0402FR-070RL | 402 | Resistor | Yes | 29 | R111,R112,R114,R115,R128,R129 | 0.100 | 0.800 | 0.050 | 0.400 | 0.020 | 0.160
90 | 2 | R130,R160 | 8.2K | RES SMD 8.2K OHM 5% 1/10W 0603 | Yageo | RC0603JR-078K2L | 603 | Resistor | Yes | 29 |  | 0.100 | 0.200 | 0.050 | 0.100 | 0.020 | 0.040
91 | 11 | R137,R138,R139,R140,R141,R142,R144,R145,R146,R148,R157 | 0R | RES SMD 0 OHM JUMPER 1/4W 1206 | Yageo | RC1206JR-070RL | 1206 | Resistor | Yes | 29 |  | 0.100 | 1.100 | 0.050 | 0.550 | 0.020 | 0.220
92 | 1 | U1 | Conn_Aplis_iMX6 | CONN MXM FMALE 314POS 0.020 GOLD | JAE Electronics | MM70-314-310B1-1-R300 | SMD SURFACE MOUNT | Connector | No | 17 |  | 6.530 | 6.530 | 3.720 | 3.720 | 1.488 | 1.488
93 | 1 | U2 | NCP511SN33T1G | IC REG LINEAR 3.3V 150MA 5TSOP | ON Semiconductor | NCP511SN33T1G | TSOT-23-5 | IC | Yes | 22 |  | 0.560 | 0.560 | 0.190 | 0.190 | 0.076 | 0.076
94 | 1 | U3 | MCP25625T-E/SS | IC TRANSCEIVER 1/1 28SSOP | Microchip Technology | MCP25625T-E/SS | 28-SSOP | IC | No | 52 |  | 2.520 | 2.520 | 1.910 | 1.910 | 0.764 | 0.764
95 | 1 | U4 | ADM3053BRWZ | DGT ISOL 2500VRMS 2CH CAN 20SOIC | Analog Devices Inc. | ADM3053BRWZ-REEL7 | 20-SOIC | IC | No | 38 |  | 11.820 | 11.820 | 7.600 | 7.600 | 3.040 | 3.040
96 | 1 | U5 | SN65HVD234QDRQ1 | 3.3-V Automotive CAN Bus Transceivers | Texas Instruments | SN65HVD234QDRQ1 | 8-SOIC | IC | No | 26 |  | 2.930 | 2.930 | 1.460 | 1.460 | 0.584 | 0.584
97 | 1 | U6 | DNP | DNP | DNP | DNP | DNP | DNP |  |  |  |  |  |  |  | 5.450 | 5.450
98 | 4 | U7,U8,U9,U10 | TPD4E02B04QDQARQ1 | TVS DIODE 3.6V 8.8V 10USON | Texas Instruments | TPD4E02B04QDQARQ1 | 10-UFDFN | IC | No | 27 |  | 0.620 | 2.480 | 0.260 | 1.040 | 0.104 | 0.416
99 | 1 | U11 | TPS2066TDGNRQ1 | IC PWR SWITCH N-CHAN 1:2 8MSOP | Texas Instruments | TPS2066TDGNRQ1 | 8-MSOP-PowerPad | IC | Yes | 8 |  | 1.820 | 1.820 | 0.832 | 0.832 | 0.333 | 0.333
100 | 1 | U12 | TPD8F003DQDR | FILTER RC(PI) 100 OHM/8.5PF SMD | Texas Instruments | TPD8F003DQDR | 16-WFDFN Exposed Pad | IC | No | 43 |  | 0.420 | 0.420 | 0.210 | 0.210 | 0.084 | 0.084
101 | 1 | U13 | LD29300P2MTR | IC REG LINEAR POS ADJ 3A P2PAK-4 | STMicroelectronics | LD29300P2MTR | P2PAK-4 | IC | Yes | 10 |  | 1.120 | 1.120 | 0.470 | 0.470 | 0.188 | 0.188
102 | 1 | U14 | Telit_LE910Cx_LTE | LTE module telit | Telit | LE910C1-NF | SMD | IC | No | Vendor response pending |  | 26.750 | 26.750 | 26.750 | 26.750 | 26.750 | 26.750
103 | 1 | U16 | TPS2041BQDBVRQ1 | IC PWR SWITCH N-CHAN 1:1 SOT23-5 | Texas Instruments | TPS2041BQDBVRQ1 | SOT23-5 | IC | Yes | 10 |  | 1.030 | 1.030 | 0.438 | 0.438 | 0.175 | 0.175
104 | 1 | U17 | SN74LVC2G32QDCURQ1 | IC GATE OR 2CH 2-INP US8 | Texas Instruments | SN74LVC2G32QDCURQ1 | 8-VFSOP | IC | Yes | 11 |  | 0.600 | 0.600 | 0.256 | 0.256 | 0.102 | 0.102
105 | 2 | U18,U19 | DMP2022LSS-13 | MOSFET P-CH 20V 10A 8SOIC | Diodes Incorporated | DMP2022LSS-13 | 8-SOIC | IC | Yes | 47 |  | 0.680 | 1.360 | 0.280 | 0.560 | 0.112 | 0.224
106 | 1 | U20 | SI-1024-X | MOSFET 2N-CH 20V 0.485A SC89-6 | Vishay Siliconix | SI1024X-T1-GE3 | SC-89-6 | IC | Yes | 24 |  | 0.440 | 0.440 | 0.165 | 0.165 | 0.066 | 0.066
107 | 1 | U21 | SQJ422EP-T1_GE3 | MOSFET N-CH 40V 75A PPAK SO-8 | Vishay Siliconix | SQJ422EP-T1_GE3 | PowerPAK® SO-8 | IC | No | 28 |  | 1.490 | 1.490 | 0.650 | 0.650 | 0.260 | 0.260
108 | 1 | U22 | LM74610QDGKRQ1 | IC SMART DIODE CTLR 8VSSOP | Texas Instruments | LM74610QDGKRQ1 | 8-TSSOP, | IC | Yes | 47 |  | 2.340 | 2.340 | 1.069 | 1.069 | 0.428 | 0.428
109 | 1 | U23 | TPD12S016PWR | Texas Instruments,TPD12S016PWR,IC,HDMI TPD12S016PWR, HDMI Interface 12-channel HDMI 4.5 | Texas Instruments | TPD12S016PWR | 24-TSSOP | IC | Yes | 6 |  | 1.160 | 1.160 | 0.490 | 0.490 | 0.196 | 0.196
110 | 1 | U24 | MAX20006AFOB/VY+ | Switching Voltage Regulators 36V, 220kHz to 2.2MHz, 4A/6A/8A Fully integrated step down converter | Maxim Integrated | MAX20006AFOB/VY+ | 17-PowerWFQFN | IC | No | 28 |  | 3.870 | 3.870 | 1.820 | 1.820 | 0.728 | 0.728
111 | 1 | U25 | MAX20008AFOA/VY+ | Switching Voltage Regulators 36V, 220kHz to 2.2MHz, 4A/6A/8A Fully integrated step down converter | Maxim Integrated | MAX20008AFOA/VY+ | 17-PowerWFQFN | IC | No | 28 |  | 3.870 | 3.870 | 1.820 | 1.820 | 0.728 | 0.728
112 | 1 | U26 | SN65C3243DBR | Texas Instruments SN65C3243DBR, Line Transceiver, RS-232 3-TX 5-RX, 3 3.6 V, 4.5 5.5 V, 28-Pin SSOP | Texas Instruments | SN65C3243DBR | 28-SSOP | IC | Yes | 16 |  | 2.700 | 2.700 | 1.350 | 1.350 | 0.540 | 0.540
113 | 1 | U27 | RCLAMP3304P.TCT | TVS DIODE 3.3V 16V SLP1616P6 | Semtech Corporation | RCLAMP3304P.TCT | 6-UFDFN Exposed Pad | IC | Yes | 3 |  | 0.940 | 0.940 | 0.410 | 0.410 | 0.164 | 0.164
114 | 1 | Y1 | 20Mhz | CRYSTAL 20.000MHZ 15 PF SMD | Suntsu Electronics, Inc. | SXT32415AA48-20.000M | 4-SMD | IC | Yes | NA |  | 0.570 | 0.570 | 0.380 | 0.380 | 0.152 | 0.152
115 | 3 | M1,M2,M3 | KFE-M3-3ET | Standoffs & Spacers STANDOFF, BROACHING, STEEL | PEM | KFE-M3-3ET | Mech | Mechanical | No | 8 |  | 0.230 | 0.690 | 0.158 | 0.474 | 0.063 | 0.190
116 | 2 | M4,M5 | KFE-M3-8ET | Standoffs & Spacers STANDOFF, BROACHING, STEEL | PEM | KFE-M3-8ET | Mech | Mechanical | Yes | 8 |  | 0.290 | 0.580 | 0.199 | 0.398 | 0.080 | 0.159
117 | 1 | L28 | 600OHM | Ferrite Bead, 600 ohm @ 100 MHz, 0.5 A, 0402 | MURATA | BLM15AX601SN1D | 402 | Inductor | Yes | 15 |  | 0.100 | 0.100 | 0.017 | 0.017 | 0.007 | 0.007
 |  |  |  |  |  |  |  |  |  |  |  | Total Unit Price | $205.5 | Total 1K Qty Price | $123.0 | Total 100K Qty Price | $70.68
CHANGES:
2022-11-09 | DNP U6 and DNP J14

Sheet: Modified BOM
Designator | Value | Description | Manufacturer | Manufacturer Part Number | Suggested Part Number | Package | Item Type
U2 | NCP511SN33T1G | IC REG LINEAR 3.3V 150MA 5TSOP | ON Semiconductor | NCP511SN33T1G | TPS79933QDDCRQ1 | TSOT-23-5 | IC
U3 | MCP25625T-E/SS | IC TRANSCEIVER 1/1 28SSOP | Microchip Technology | MCP25625T-E/SS | MCP251863T-H/SSVAO | 28-SSOP | IC
Y1 | 20Mhz | CRYSTAL 20.000MHZ 15 PF SMD | Suntsu Electronics, Inc. | SXT32415AA48-20.000M | ECS-400-8-36Q-CWY-TR | 4-SMD | Crystal
U4 | ADM3053BRWZ | DGT ISOL 2500VRMS 2CH CAN 20SOIC | Analog Devices Inc. | ADM3053BRWZ-REEL7 | ISO1042QDWRQ1 | 20-SOIC | IC
