eSpark-Consulting-Group/robertmeares-vcu-bcu/Client-Files/BCU-PCBA-main/BCU-PCBA-main/BCU-PCBA/SECONDARY BOARD V2.1/GERBER/EMBL51745_PCB_SB_V2.1_PLC_20210914/EMBL51537_SC_BOARD_XY-REPORT.xls

REFDES | COMP_DEVICE_TYPE | COMP_VALUE | COMP_TOL | COMP_PACKAGE | SYM_X | SYM_Y | SYM_ROTATE | SYM_MIRROR
C1 | CAP_NP_78_CAPC1005X55N_A_DISCRE | 0.1uF | 10% | CAPC1005X55N_A | 3106.096 | 3681.746 | 90.000 | YES
C2 | CAP_NP_78_CAPC1005X55N_A_DISCRE | 0.1uF | 10% | CAPC1005X55N_A | 3463.100 | 3789.750 | 270.000 | YES
C3 | CAP_NP_78_CAPC1608X80N_A_DISCRE | 22uF |  | CAPC1608X80N_A | 3522.098 | 3790.748 | 270.000 | YES
C4 | CAP_NP_78_CAPC1005X55N_A_DISCRE | 0.1uF | 10% | CAPC1005X55N_A | 1198.100 | 4848.750 | 270.000 | YES
C5 | CAP NP_CAPC1608X90N_A_1UF | 1uF |  | CAPC1608X90N_A | 1257.098 | 4850.748 | 270.000 | YES
C6 | CAP_NP_78_CAPC1608X90N_DISCRETE | 0.1uF |  | CAPC1608X90N | 1264.252 | 4057.098 | 90.000 | YES
C7 | CAP_NP_78_CAPC1005X55N_A_DISCRE | 0.1uF | 10% | CAPC1005X55N_A | 2819.998 | 4285.002 | 0.000 | YES
C8 | CAP_NP_78_CAPC1005X55N_A_DISCRE | 0.1uF | 10% | CAPC1005X55N_A | 3071.902 | 4701.252 | 270.000 | YES
C9 | CAP_NP_78_CAPC1005X55N_A_DISCRE | 0.1uF | 10% | CAPC1005X55N_A | 1864.746 | 256.876 | 0.000 | YES
C10 | CAP NP_CAPC1608X90N_A_1UF | 1uF |  | CAPC1608X90N_A | 1866.748 | 200.884 | 0.000 | YES
C11 | CAP_NP_78_CAPC1005X55N_A_DISCRE | 0.1uF | 10% | CAPC1005X55N_A | 2495.096 | 483.746 | 90.000 | YES
C12 | CAP NP_CAPC1608X90N_A_1UF | 1uF |  | CAPC1608X90N_A | 2443.098 | 484.748 | 90.000 | YES
C13 | CAP_NP_78_CAPC1005X55N_A_DISCRE | 0.1uF | 10% | CAPC1005X55N_A | 3349.254 | 545.096 | 180.000 | YES
C14 | CAP NP_CAPC1608X90N_A_1UF | 1uF |  | CAPC1608X90N_A | 3347.252 | 601.088 | 180.000 | YES
C15 | CAP_NP_78_CAPC1608X90N_DISCRETE | 0.1uF |  | CAPC1608X90N | 1682.141 | 2796.996 | 90.000 | YES
C16 | CAP_NP_78_CAPC1608X90N_DISCRETE | 0.1uF |  | CAPC1608X90N | 1406.551 | 2796.996 | 90.000 | YES
C17 | CAP_NP_78_CAPC1608X90N_DISCRETE | 0.1uF |  | CAPC1608X90N | 2413.378 | 3009.350 | 180.000 | YES
C18 | CAP_NP_78_CAPC1005X55N_A_DISCRE | 0.1uF | 10% | CAPC1005X55N_A | 3355.070 | 3171.850 | 90.000 | YES
C19 | CAP_NP_78_CAPC1005X55N_A_DISCRE | 0.1uF | 10% | CAPC1005X55N_A | 3086.129 | 3171.850 | 90.000 | YES
C20 | CAP_NP_78_CAPC1005X55N_A_DISCRE | 0.1uF | 10% | CAPC1005X55N_A | 3360.070 | 2771.457 | 90.000 | YES
C21 | CAP_NP_78_CAPC1005X55N_A_DISCRE | 0.1uF | 10% | CAPC1005X55N_A | 3086.129 | 2771.457 | 90.000 | YES
C22 | CAP_NP_78_CAPC1005X55N_A_DISC_1 | DNP | 10% | CAPC1005X55N_A | 3345.070 | 2346.063 | 90.000 | YES
C23 | CAP_NP_78_CAPC1005X55N_A_DISC_1 | DNP | 10% | CAPC1005X55N_A | 3086.129 | 2346.063 | 90.000 | YES
C24 | CAP_NP_78_CAPC1005X55N_A_DISC_1 | DNP | 10% | CAPC1005X55N_A | 3335.070 | 1955.670 | 90.000 | YES
C25 | CAP_NP_78_CAPC1005X55N_A_DISC_1 | DNP | 10% | CAPC1005X55N_A | 3086.129 | 1955.670 | 90.000 | YES
C26 | CAP_NP_78_CAPC1608X90N_DISCRETE | 0.1uF |  | CAPC1608X90N | 1037.811 | 2796.996 | 90.000 | YES
C27 | CAP_NP_78_CAPC1608X90N_DISCRETE | 0.1uF |  | CAPC1608X90N | 763.009 | 2796.996 | 90.000 | YES
C30 | CAPACITOR NON-POL_CAPC3216X180N | 1nF |  | CAPC3216X180N_D | 222.000 | 4948.000 | 180.000 | YES
C31 | CAPACITOR NON-POL_CAPC3216X18_1 | DNP |  | CAPC3216X180N_D | 223.000 | 508.000 | 180.000 | YES
C32 | CAPACITOR NON-POL_CAPC3216X18_1 | DNP |  | CAPC3216X180N_D | 4198.000 | 638.000 | 0.000 | YES
C33 | CAP_NP_78_CAPC1005X55N_A_DISCRE | 0.1uF | 10% | CAPC1005X55N_A | 1310.002 | 4849.002 | 270.000 | YES
C34 | CAP NP_CAPC1608X90N_A_1UF | 1uF |  | CAPC1608X90N_A | 1367.000 | 4851.000 | 270.000 | YES
D18 | DIODE SCHOTTKY_SODFL2514X80N_2K | RRE07VTM6SFHTR |  | SODFL2514X80N_2K | 2990.147 | 3145.865 | 90.000 | YES
D19 | DIODE SCHOTTKY_SODFL2514X80N_2K | RRE07VTM6SFHTR |  | SODFL2514X80N_2K | 2990.146 | 2745.472 | 90.000 | YES
D20 | DIODE SCHOTTKY_SODFL2514X80N__1 | DNP |  | SODFL2514X80N_2K | 2990.145 | 2320.078 | 90.000 | YES
D21 | DIODE SCHOTTKY_SODFL2514X80N__1 | DNP |  | SODFL2514X80N_2K | 2990.147 | 1929.685 | 90.000 | YES
D22 | DIODE PIN_1_DIOMELF3515N_LL4148 | LL4148-GS08 |  | DIOMELF3515N | 2354.000 | 3701.000 | 270.000 | YES
D23 | DIODE PIN_1_DIOMELF3515N_LL4148 | LL4148-GS08 |  | DIOMELF3515N | 2613.000 | 4238.000 | 270.000 | YES
D24 | DIODE PIN_1_DIOMELF3515N_LL4148 | LL4148-GS08 |  | DIOMELF3515N | 965.000 | 3351.000 | 0.000 | YES
D25 | DIODE PIN_1_DIOMELF3515N_LL4148 | LL4148-GS08 |  | DIOMELF3515N | 1471.000 | 3348.000 | 0.000 | YES
D26 | DIODE PIN_1_DIOMELF3515N_LL4148 | LL4148-GS08 |  | DIOMELF3515N | 1891.000 | 3199.000 | 270.000 | YES
J1 | CONN PCB 12X2-P_1_HIROSE_FX23-2 | FX23-20S-0.5SV |  | HIROSE_FX23-20S-0P5SV | 3133.910 | 417.310 | 0.000 | YES
J2 | MX23A18NF1_0_JAE_MX23A18NF1_MX2 | MX23A18NF1 |  | JAE_MX23A18NF1 | 4165.394 | 4183.109 | 90.000 | YES
L16 | L-33R100MHZ-3A-25%-0603_INDC201 | BLM21SP601SH1D |  | INDC2012X105N | 3926.182 | 4576.810 | 180.000 | YES
L18 | L-33R100MHZ-3A-25%-0603_FB_MPZ2 | MPZ2012S102AT000 |  | FB_MPZ2012S300ATD25 | 3441.208 | 3191.142 | 0.000 | YES
L19 | L-33R100MHZ-3A-25%-0603_FB_MPZ2 | MPZ2012S102AT000 |  | FB_MPZ2012S300ATD25 | 3441.208 | 2790.748 | 0.000 | YES
L20 | L-33R100MHZ-3A-25%-0603_FB_MPZ2 | MPZ2012S102AT000 |  | FB_MPZ2012S300ATD25 | 3441.208 | 2365.354 | 0.000 | YES
L21 | L-33R100MHZ-3A-25%-0603_FB_MPZ2 | MPZ2012S102AT000 |  | FB_MPZ2012S300ATD25 | 3441.208 | 1974.961 | 0.000 | YES
L22 | L-33R100MHZ-3A-25%-0603_INDC201 | BLM21SP601SH1D |  | INDC2012X105N | 3589.098 | 3794.748 | 270.000 | YES
L23 | L-33R100MHZ-3A-25%-0603_INDC2_1 | BLM21AG121SZ1D |  | INDC2012X105N | 1613.047 | 2796.996 | 90.000 | YES
L24 | L-33R100MHZ-3A-25%-0603_INDC2_1 | BLM21AG121SZ1D |  | INDC2012X105N | 1337.457 | 2796.996 | 90.000 | YES
L25 | L-33R100MHZ-3A-25%-0603_INDC2_1 | BLM21AG121SZ1D |  | INDC2012X105N | 832.103 | 2796.996 | 90.000 | YES
L26 | L-33R100MHZ-3A-25%-0603_INDC2_1 | BLM21AG121SZ1D |  | INDC2012X105N | 1106.905 | 2796.996 | 90.000 | YES
L27 | L-33R100MHZ-3A-25%-0603_INDC2_1 | BLM21AG121SZ1D |  | INDC2012X105N | 2417.000 | 2936.000 | 180.000 | YES
MH1 | MOUNTING HOLE_MTG320_620_MOUNTI | Mounting hole |  | MTG320_620 | 118.098 | 5511.858 | 270.000 | NO
MH2 | MOUNTING HOLE_MTG320_620_MOUNTI | Mounting hole |  | MTG320_620 | 4409.498 | 5511.858 | 270.000 | NO
MH3 | MOUNTING HOLE_MTG320_620_MOUNTI | Mounting hole |  | MTG320_620 | 118.098 | 118.098 | 270.000 | NO
MH4 | MOUNTING HOLE_MTG320_620_MOUNTI | Mounting hole |  | MTG320_620 | 4409.498 | 118.098 | 270.000 | NO
MH5 | MOUNTING HOLE_MTG320_620_MOUNTI | Mounting hole |  | MTG320_620 | 393.688 | 5836.660 | 270.000 | NO
MH6 | MOUNTING HOLE_MTG320_620_MOUNTI | Mounting hole |  | MTG320_620 | 4133.908 | 5836.660 | 270.000 | NO
MH7 | MOUNTING HOLE_MTG320_620_MOUNTI | Mounting hole |  | MTG320_620 | 393.688 | -206.704 | 270.000 | NO
MH8 | MOUNTING HOLE_MTG320_620_MOUNTI | Mounting hole |  | MTG320_620 | 4133.908 | -206.704 | 270.000 | NO
Q1 | TLX9000TPLF_1_OPTO_TLP293_BL-TP | TLX9000(TPL,F |  | OPTO_TLP293_BL-TPL_E | 1965.098 | 3912.748 | 90.000 | YES
Q2 | TLX9000TPLF_1_OPTO_TLP293_BL-TP | TLX9000(TPL,F |  | OPTO_TLP293_BL-TPL_E | 1975.098 | 4397.748 | 90.000 | YES
Q3 | NPN BCE_SOT95P237X122-3N_OSI_MM | MMBT3904-TP |  | SOT95P237X122-3N_OSI | 1619.000 | 3900.346 | 90.000 | YES
Q4 | NPN BCE_SOT95P237X122-3N_OSI_MM | MMBT3904-TP |  | SOT95P237X122-3N_OSI | 1634.000 | 4385.346 | 90.000 | YES
R1 | R_0_RESC1608X55N_B_DNP | DNP |  | RESC1608X55N_B | 3042.098 | 3680.748 | 90.000 | YES
R2 | R_0_RESC1608X55N_B_10K | 10K |  | RESC1608X55N_B | 756.252 | 4718.042 | 180.000 | YES
R3 | R_0_RESC1608X55N_B_10K | 10K |  | RESC1608X55N_B | 782.986 | 4827.748 | 90.000 | YES
R8 | R_0_RESC1608X55N_B_10K | 10K |  | RESC1608X55N_B | 2826.902 | 4640.252 | 180.000 | YES
R9 | R_0_RESC1608X55N_B_10K | 10K |  | RESC1608X55N_B | 2990.902 | 4552.252 | 180.000 | YES
R10 | R_0_RESC1608X55N_B_10K | 10K |  | RESC1608X55N_B | 3241.748 | 4364.902 | 0.000 | YES
R11 | RES_57_RESC1005X40N_A_DISCRETE_ | 0E |  | RESC1005X40N_A | 3231.748 | 4309.902 | 180.000 | YES
R12 | RES_57_RESC1005X40N_A_DISCRETE_ | 0E |  | RESC1005X40N_A | 3231.748 | 4264.902 | 180.000 | YES
R13 | RES_57_RESC1005X40N_A_DISCRETE_ | 0E |  | RESC1005X40N_A | 2843.748 | 4193.902 | 0.000 | YES
R14 | RES_57_RESC1005X40N_A_DISCRETE_ | 0E |  | RESC1005X40N_A | 2843.748 | 4238.902 | 0.000 | YES
R15 | R_0_RESC1608X55N_B_10K | 10K |  | RESC1608X55N_B | 2990.902 | 4787.252 | 0.000 | YES
R16 | RES_57_RESC1608X55N_A_DISCRETE_ | DNP |  | RESC1608X55N_A | 2067.098 | 4670.748 | 0.000 | YES
R17 | RES_57_RESC1608X55N_A_DISCRET_1 | 1k |  | RESC1608X55N_A | 1840.098 | 4037.748 | 270.000 | YES
R18 | RES_57_RESC1608X55N_A_DISCRETE_ | DNP |  | RESC1608X55N_A | 2074.098 | 4189.748 | 180.000 | YES
R19 | RES_57_RESC1608X55N_A_DISCRET_1 | 1k |  | RESC1608X55N_A | 1850.098 | 4527.748 | 270.000 | YES
R28 | R_0_RESC1608X55N_B_10K | 10K |  | RESC1608X55N_B | 757.252 | 4645.098 | 180.000 | YES
R29 | R_0_RESC1608X55N_B_10K | 10K |  | RESC1608X55N_B | 1528.712 | 4790.662 | 90.000 | YES
R30 | R_0_RESC1608X55N_A_47K | 47K |  | RESC1608X55N_A | 3253.098 | 3191.142 | 0.000 | YES
R31 | R_0_RESC1608X55N_B_10K | 10K |  | RESC1608X55N_B | 3151.208 | 3161.614 | 90.000 | YES
R32 | R_0_RESC1608X55N_A_47K | 47K |  | RESC1608X55N_A | 3253.098 | 2790.748 | 0.000 | YES
R33 | R_0_RESC1608X55N_B_10K | 10K |  | RESC1608X55N_B | 3151.208 | 2761.220 | 90.000 | YES
R34 | R_0_RESC1608X55N_A_DNP | DNP |  | RESC1608X55N_A | 3253.098 | 2365.354 | 0.000 | YES
R35 | R_0_RESC1608X55N_B_DNP | DNP |  | RESC1608X55N_B | 3151.208 | 2335.826 | 90.000 | YES
R36 | R_0_RESC1608X55N_A_DNP | DNP |  | RESC1608X55N_A | 3253.098 | 1974.961 | 0.000 | YES
R37 | R_0_RESC1608X55N_B_DNP | DNP |  | RESC1608X55N_B | 3151.208 | 1945.433 | 90.000 | YES
R38 | RES_57_RESC1608X55N_A_DISCRET_2 | 1k2 |  | RESC1608X55N_A | 1743.000 | 3887.748 | 180.000 | YES
R39 | RES_57_RESC1608X55N_A_DISCRET_2 | 1k2 |  | RESC1608X55N_A | 1759.000 | 4372.748 | 180.000 | YES
TP1 | T POINT R_TPC160H100_T POINT R | T POINT R |  | TPC160H100 | 3709.098 | 3850.748 | 0.000 | YES
TP2 | T POINT R_TPC160H100_T POINT R | T POINT R |  | TPC160H100 | 2280.098 | 593.748 | 0.000 | YES
TP3 | T POINT R_TPC160H100_T POINT R | T POINT R |  | TPC160H100 | 1950.748 | 403.902 | 270.000 | YES
TP4 | T POINT R_TPC160H100_T POINT R | T POINT R |  | TPC160H100 | 1222.098 | 4525.748 | 0.000 | YES
TP5 | T POINT R_TPC160H100_T POINT R | T POINT R |  | TPC160H100 | 1106.905 | 2607.500 | 0.000 | YES
TP6 | T POINT R_TPC160H100_T POINT R | T POINT R |  | TPC160H100 | 1613.047 | 2606.961 | 0.000 | YES
TP7 | T POINT R_TPC160H100_T POINT R | T POINT R |  | TPC160H100 | 2503.874 | 2747.098 | 90.000 | YES
TP8 | T POINT R_TPC160H100_T POINT R | T POINT R |  | TPC160H100 | 830.103 | 2607.500 | 180.000 | YES
TP9 | T POINT R_TPC160H100_T POINT R | T POINT R |  | TPC160H100 | 1337.457 | 2607.500 | 180.000 | YES
TP10 | T POINT R_TPC160H100_T POINT R | T POINT R |  | TPC160H100 | 3676.641 | 3191.142 | 0.000 | YES
TP11 | T POINT R_TPC160H100_T POINT R | T POINT R |  | TPC160H100 | 3676.641 | 2790.748 | 0.000 | YES
TP12 | T POINT R_TPC160H100_T POINT R | T POINT R |  | TPC160H100 | 3676.641 | 2365.354 | 0.000 | YES
TP13 | T POINT R_TPC160H100_T POINT R | T POINT R |  | TPC160H100 | 3676.641 | 1974.961 | 0.000 | YES
TP14 | T POINT R_TPC160H100_T POINT R | T POINT R |  | TPC160H100 | 2990.147 | 3341.141 | 0.000 | YES
TP15 | T POINT R_TPC160H100_T POINT R | T POINT R |  | TPC160H100 | 2990.146 | 2940.748 | 0.000 | YES
TP16 | T POINT R_TPC160H100_T POINT R | T POINT R |  | TPC160H100 | 2990.145 | 2515.354 | 0.000 | YES
TP17 | T POINT R_TPC160H100_T POINT R | T POINT R |  | TPC160H100 | 2990.147 | 2124.961 | 0.000 | YES
TP18 | T POINT R_TPC160H100_T POINT R | T POINT R |  | TPC160H100 | 1914.098 | 4188.748 | 0.000 | YES
TP19 | T POINT R_TPC160H100_T POINT R | T POINT R |  | TPC160H100 | 1650.098 | 4067.748 | 0.000 | YES
TP20 | T POINT R_TPC160H100_T POINT R | T POINT R |  | TPC160H100 | 1645.098 | 4557.748 | 0.000 | YES
U1 | TPS2024IDRQ1_0_SOIC127P600X175- | TPS2024IDRQ1 |  | SOIC127P600X175-8N_TI | 3287.098 | 3740.748 | 270.000 | YES
U2 | TCA6408AQPWRQ1_1_TSSOP65P640X12 | TCA6408AQPWRQ1 |  | TSSOP65P640X120-16N_B | 1010.098 | 4722.748 | 0.000 | YES
U3 | RELAY_DPDT_NB_0_RELAY_G6K-2F-Y- | G6K-2F-Y-DC12 |  | RELAY_G6K-2F-Y-DC12 | 969.110 | 3083.098 | 90.000 | YES
U4 | RELAY_DPDT_NB_0_RELAY_G6K-2F-Y- | G6K-2F-Y-DC12 |  | RELAY_G6K-2F-Y-DC12 | 1475.252 | 3083.098 | 90.000 | YES
U5 | TPL7407LADR_0_SOIC127P600X175-1 | TPL7407LADR |  | SOIC127P600X175-16N_TI | 1000.252 | 4143.098 | 180.000 | YES
U6 | RELAY_SPDT_B_0_RELAY_G6L-1F-DC1 | G6L-1F-DC12 |  | RELAY_G6L-1F-DC12 | 2141.205 | 3085.098 | 90.000 | YES
U11 | ADS1015IDGSR_1_VSSOP50P490X110- | ADS1015IDGSR |  | VSSOP50P490X110-10N | 3036.748 | 4309.902 | 0.000 | YES
U12 | HDC2021DEBT_2_WSON100P300X300X9 | HDC2021DEBT |  | WSON100P300X300X92-7N | 2964.902 | 4680.252 | 180.000 | YES
U13 | RELAY_SPDT_B_0_RELAY_G6L-1F-DC1 | G6L-1F-DC12 |  | RELAY_G6L-1F-DC12 | 2335.098 | 4037.748 | 270.000 | YES
U14 | RELAY_SPDT_B_0_RELAY_G6L-1F-DC1 | G6L-1F-DC12 |  | RELAY_G6L-1F-DC12 | 2340.098 | 4522.748 | 270.000 | YES
