eSpark-Consulting-Group/robertmeares-vcu-bcu/Client-Files/BCU-PCBA-main/BCU-PCBA-main/BCU-PCBA/SECONDARY BOARD V2.1/GERBER/EMBL51745_PCB_SB_V2.1_PLC_20210914/assembly.dxf

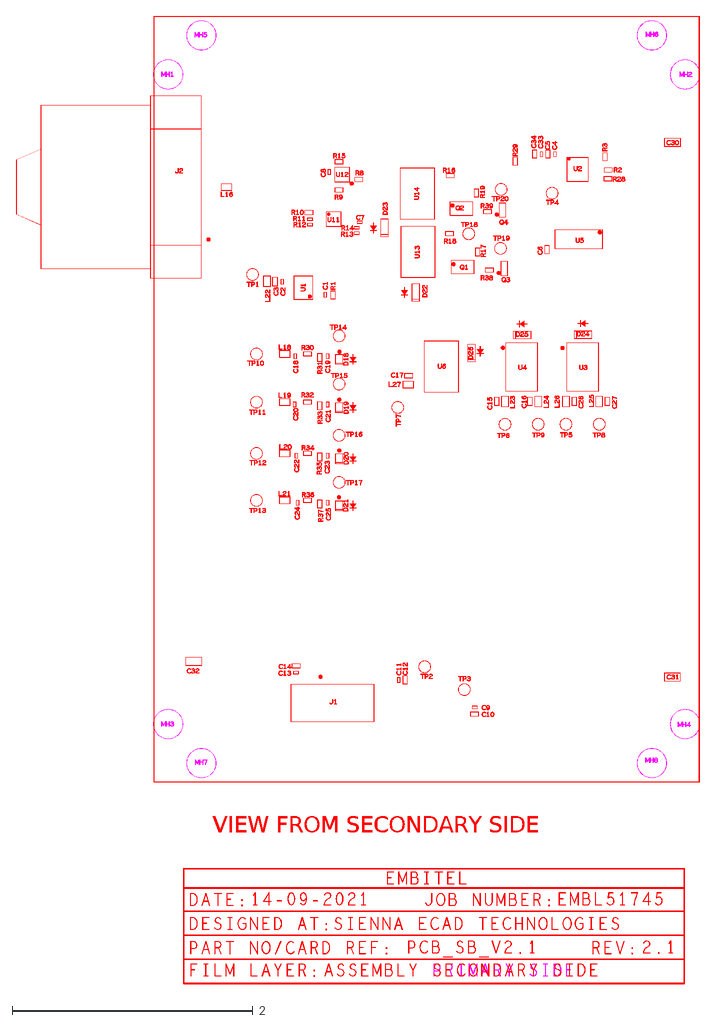
[picture p3: CAD file, 2023-08-29]
Client-Files/BCU-PCBA-main/BCU-PCBA-main/BCU-PCBA/SECONDARY BOARD V2.1/GERBER/EMBL51745_PCB_SB_V2.1_PLC_20210914/assembly.dxf
VIEW FROM SECONDARY SIDE
