eSpark-Consulting-Group/robertmeares-vcu-bcu/Client-Files/BCU-PCBA-main/BCU-PCBA-main/BCU-PCBA/CARRIER BOARD 2.0/DXF from Tarform/EmbitelAssC_BIUAssA_20210519/EmbitelAssC_BIUAssA_20210519_dxf.DXF

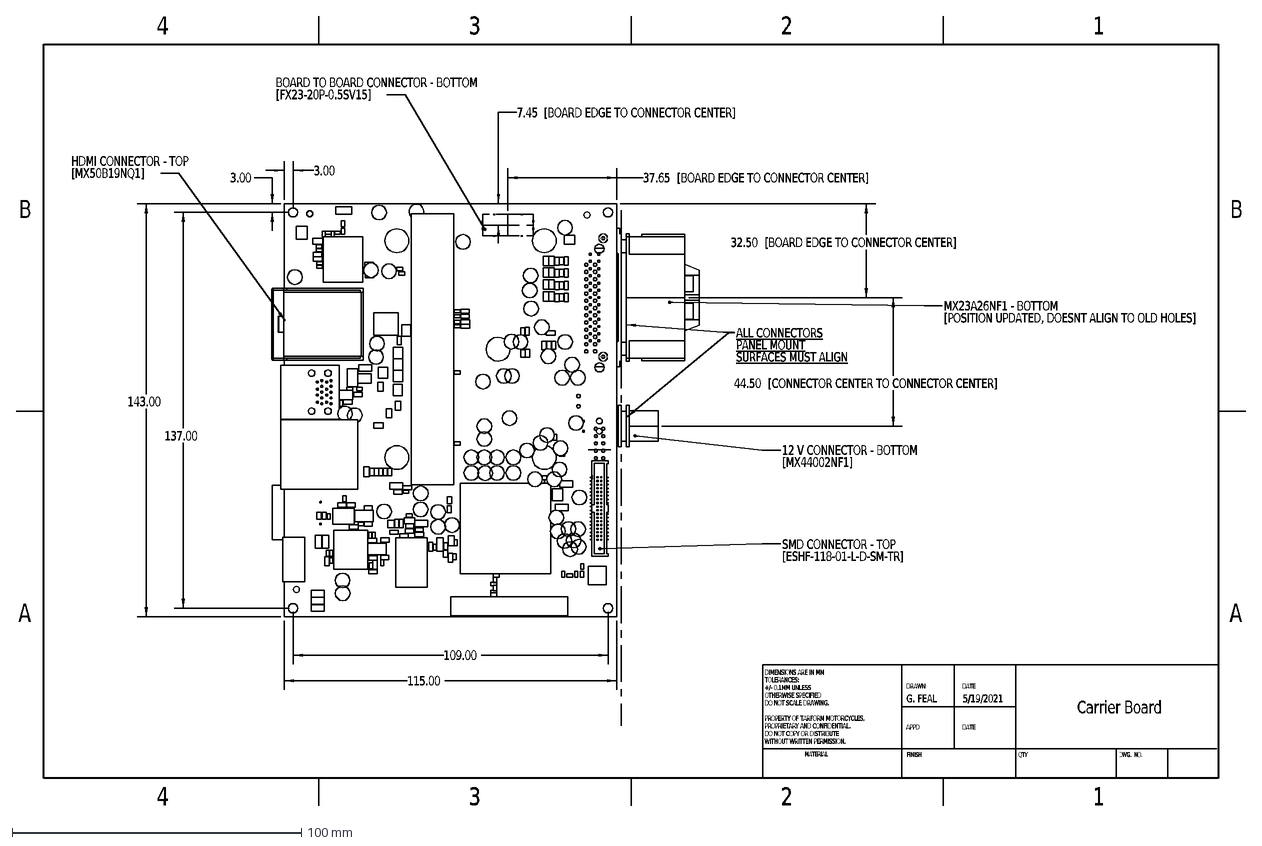
[picture p4: CAD file, 2023-08-29]
Client-Files/BCU-PCBA-main/BCU-PCBA-main/BCU-PCBA/CARRIER BOARD 2.0/DXF from Tarform/EmbitelAssC_BIUAssA_20210519/EmbitelAssC_BIUAssA_20210519_dxf.DXF
DWG. NO.
DATE
DRAWN
FINISH
MATERIAL
Carrier Board
G. FEAL
5/19/2021
QTY
A
B
4
3
2
1
DIMENSIONS ARE IN MM
TOLERANCES:
+/- 0.1MM UNLESS
OTHERWISE SPECIFIED
DO NOT SCALE DRAWING.
PROPERTY OF TARFORM MOTORCYCLES,
PROPRIETARY AND CONFIDENTIAL.
DO NOT COPY OR DISTRIBUTE
WITHOUT WRITTEN PERMISSION.
APPD
7.45
[BOARD EDGE TO CONNECTOR CENTER]
32.50
44.50
[CONNECTOR CENTER TO CONNECTOR CENTER]
37.65
143.00
115.00
109.00
137.00
3.00
MX23A26NF1 - BOTTOM
[POSITION UPDATED, DOESNT ALIGN TO OLD HOLES]
12 V CONNECTOR - BOTTOM
[MX44002NF1]
SMD CONNECTOR - TOP
[ESHF-118-01-L-D-SM-TR]
BOARD TO BOARD CONNECTOR - BOTTOM
[FX23-20P-0.5SV15]
HDMI CONNECTOR - TOP
[MX50B19NQ1]
ALL CONNECTORS
PANEL MOUNT
SURFACES MUST ALIGN
