eSpark-Consulting-Group/robertmeares-vcu-bcu/Client-Files/BCU-PCBA-main/BCU-PCBA-main/BCU-PCBA/CARRIER BOARD 2.0/GERBER/EMBL51745_PCB_CB_V2.0_DFM_202100719/rout.dxf

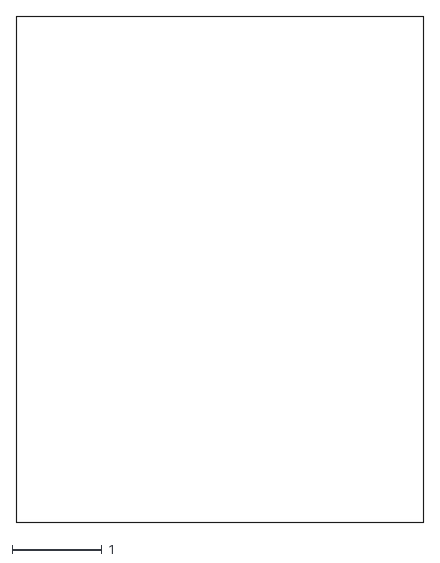
[picture p5: CAD file, 2023-08-29]
Client-Files/BCU-PCBA-main/BCU-PCBA-main/BCU-PCBA/CARRIER BOARD 2.0/GERBER/EMBL51745_PCB_CB_V2.0_DFM_202100719/rout.dxf
4.53 x 5.64
