eSpark-Consulting-Group/robertmeares-vcu-bcu/Client-Files/BCU-PCBA-main/BCU-PCBA-main/BCU-PCBA/CARRIER BOARD 2.0/STEP/embl51745_carrier card_sp2_v2-16072021.stp

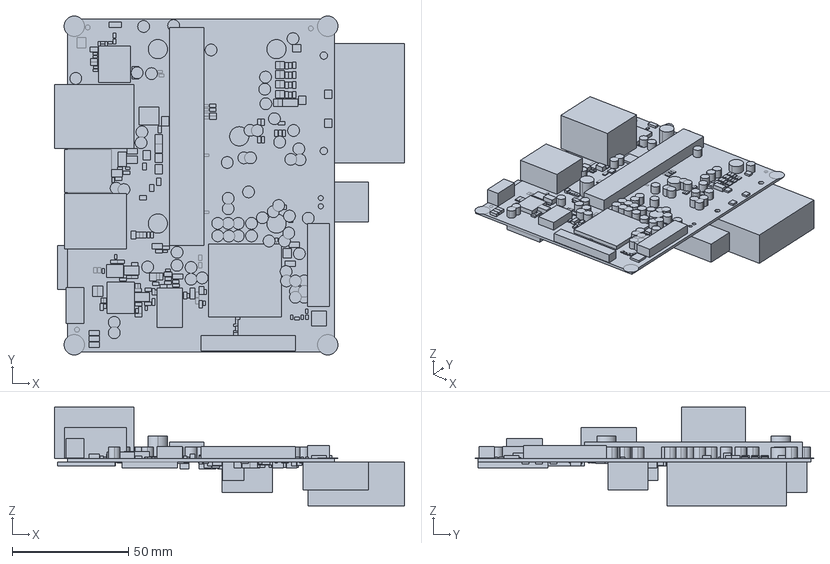
[picture p6: CAD file, 2023-08-29]
Client-Files/BCU-PCBA-main/BCU-PCBA-main/BCU-PCBA/CARRIER BOARD 2.0/STEP/embl51745_carrier card_sp2_v2-16072021.stp
150.7 x 145.8 x 42.5 mm
BOARD_OUTLINE
DFN50P160X160_6_PWP
JAE_SJ107054
HIROSE_FX23-20P-0P5SV15
SAMTEC-ESHF-118-01-L-D-SM-TR
INDC1005X55N
CAPAE660X800N_NICHICON
MSOP65P490X110-9N_TI_A
TPC160H100 x 61
MTG320_620 x 4
PEM_KFE-M3-3ET x 3
PEM_KFE-M3-8ET x 2
JAE_MX50019NQ1
JAE_MX23A26NF1
BEL_A829-1J1T-KM
MOLEX_484060003
MODULE_LE910C1
MODULE_WE866C6-P
RESCAX80P160X320X70-8N x 22
CAPC3216X95N_B
SOTFL50P160X60-6N_VISHAY
CAPC3216X180N
WSON40P135X330X80-17N
INDC4516X180N_A
RESC3116X65N x 11
SOIC127P600X175-8N_TI
OSCCC250X320X80-4N_SUNTSU
CAPC3225X280N x 2
MOSFET_SQJ457EP-T1_GE3
VSSOP65P490X110-8N
TSOP95P275X110-5N
CAPC1608X95N_TDK x 5
DIOM5336X250N x 2
CAPC2012X94N_B x 2
IND_XAL6030-122MEB x 2
RESC1608X55N_B x 3
INDC1608X65N x 2
CAPC2012X145N_TDK x 2
CAPC3216X180N_TDK x 2
SOIC127P600X170-8N x 2
DIOMELF3515N
SSOP65P780X200-28N x 2
SOT95P280X145-5N_A
SOTFL50P160X85-3N_A x 2
FUSE_0458010DR x 2
CAPC1608X95N x 4
CAPC1608X90N_B x 10
SOD2513X110N_1K
HIROSE_UFL-R-SMT
CAPC1608X90N_A x 14
SON50P100X250X55-10N x 4
FIL_MCZ1210AH900L2T x 2
CAPC1608X87N x 7
CAPC3216X180N_D x 7
RESC1608X55N x 12
VSSOP50P310X90-8N
CAPC3225X270N_A x 11
SOD2512X110N_NXP x 16
INDC1608X65N_A x 6
RESC1608X55N_PEC x 17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
