eSpark-Consulting-Group/robertmeares-vcu-bcu/Client-Files/BCU-PCBA-main/BCU-PCBA-main/BCU-PCBA/SECONDARY BOARD V2.1/Mechanical/EMBL51537_SC_BOARD.stp

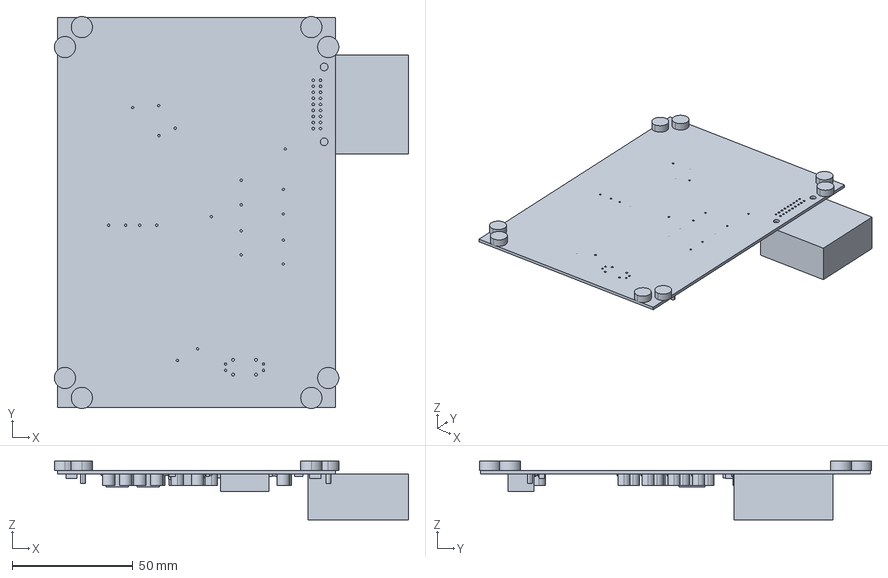
[picture p8: CAD file, 2023-08-29]
Client-Files/BCU-PCBA-main/BCU-PCBA-main/BCU-PCBA/SECONDARY BOARD V2.1/Mechanical/EMBL51537_SC_BOARD.stp
146.7 x 162.3 x 24.2 mm
BOARD_OUTLINE
HIROSE_FX23-20S-0P5SV
SOT95P237X122-3N_OSI x 2
DIOMELF3515N x 5
JAE_MX23A18NF1
WSON100P300X300X92-7N
SODFL2514X80N_2K x 4
INDC2012X105N x 7
RELAY_G6K-2F-Y-DC12 x 2
RELAY_G6L-1F-DC12 x 3
TPC160H100 x 20
RESC1608X55N_A x 10
RESC1005X40N_A x 4
RESC1608X55N_B x 13
FB_MPZ2012S300ATD25 x 4
CAPC3216X180N_D x 3
CAPC1608X80N_A
CAPC1608X90N x 6
CAPC1608X90N_A x 5
CAPC1005X55N_A x 17
OPTO_TLP293_BL-TPL_E x 2
SOIC127P600X175-8N_TI
VSSOP50P490X110-10N
SOIC127P600X175-16N_TI
TSSOP65P640X120-16N_B
MTG320_620 x 8
40T_GLOBAL_FID x 3
