eSpark-Consulting-Group/robertmeares-vcu-bcu/Client-Files/BCU-PCBA-main/BCU-PCBA-main/BCU-PCBA/SECONDARY BOARD V2.1/SCHEMATIC/Schematic in PDF/embl51537_sc_sp2_v2.1_20210906.pdf

# Project: TARFORM ; SECONDARY BOARD

# PAGE 02

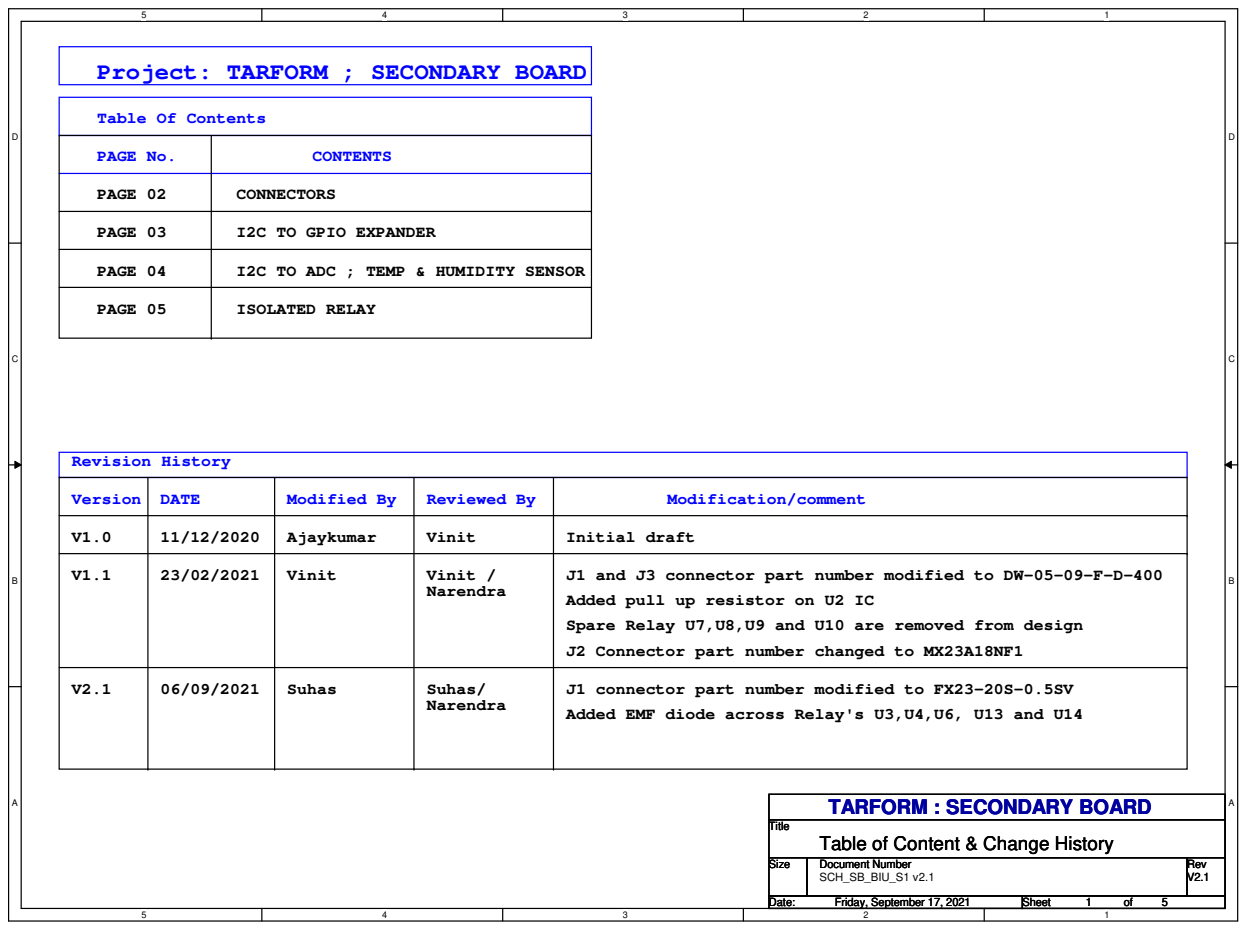
[picture p10: page 1]
PAGE 05; PAGE 03; CONTENTS; PAGE 04; ISOLATED RELAY; PAGE No.; CONNECTORS; Ajaykumar; Version; Modified By; Vinit; DATE; Reviewed By; Revision History; Modification/comment; Initial draft; Vinit /; Narendra; SCH_SB_BIU_S1 v2.1; Suhas/; Suhas; J1 connector part number modified to FX23-20S-0.5SV; Size; Document Number; Rev; Date:; Sheet; 5Friday, September 17, 2021

Table Of Contents

I2C TO GPIO EXPANDER

I2C TO ADC ; TEMP & HUMIDITY SENSOR

J1 and J3 connector part number modified to DW-05-09-F-D-400
Added pull up resistor on U2 IC
Spare Relay U7,U8,U9 and U10 are removed from design
J2 Connector part number changed to MX23A18NF1

Added EMF diode across Relay's U3,U4,U6, U13 and U14

TARFORM : SECONDARY BOARD

Title
Table of Content & Change History

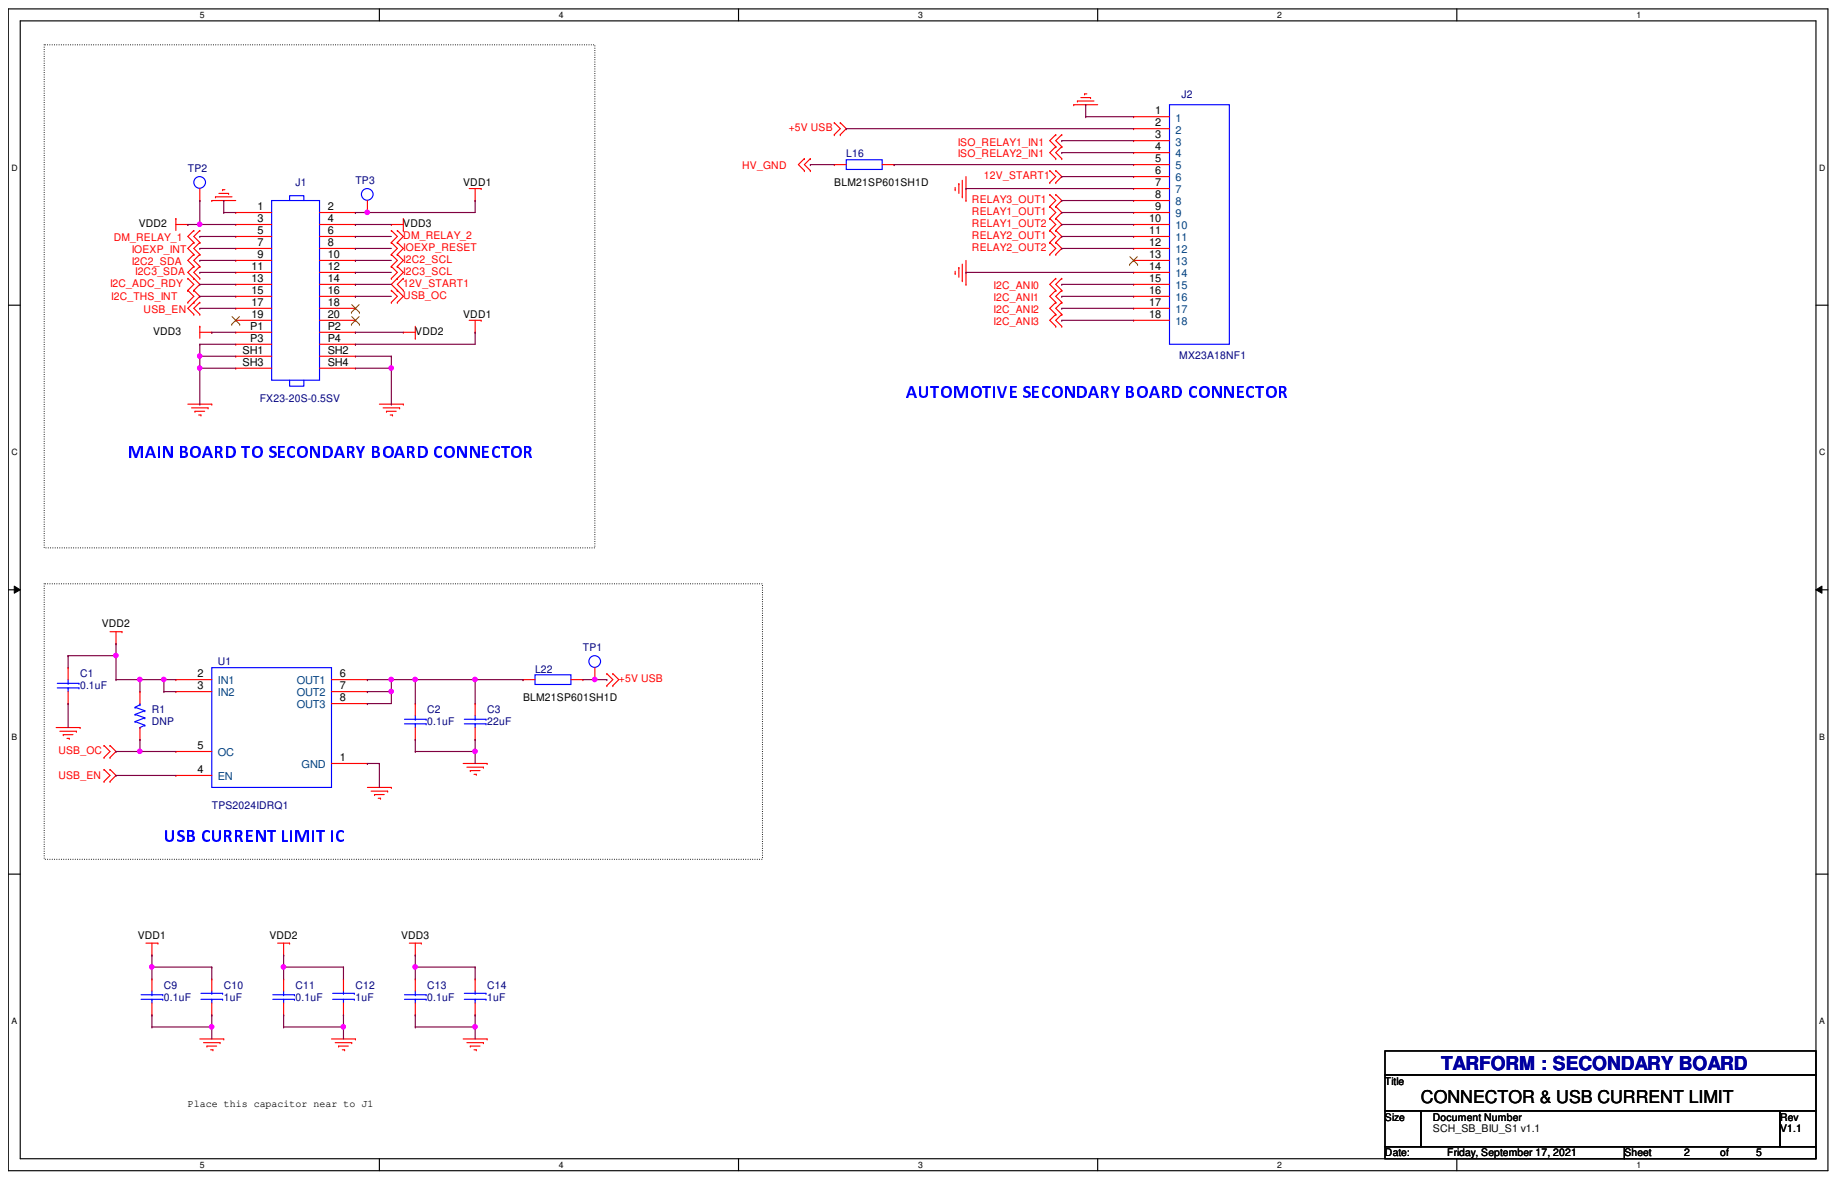
[picture p11: page 2]

Title
CONNECTOR & USB CURRENT LIMIT

Place this capacitor near to J1

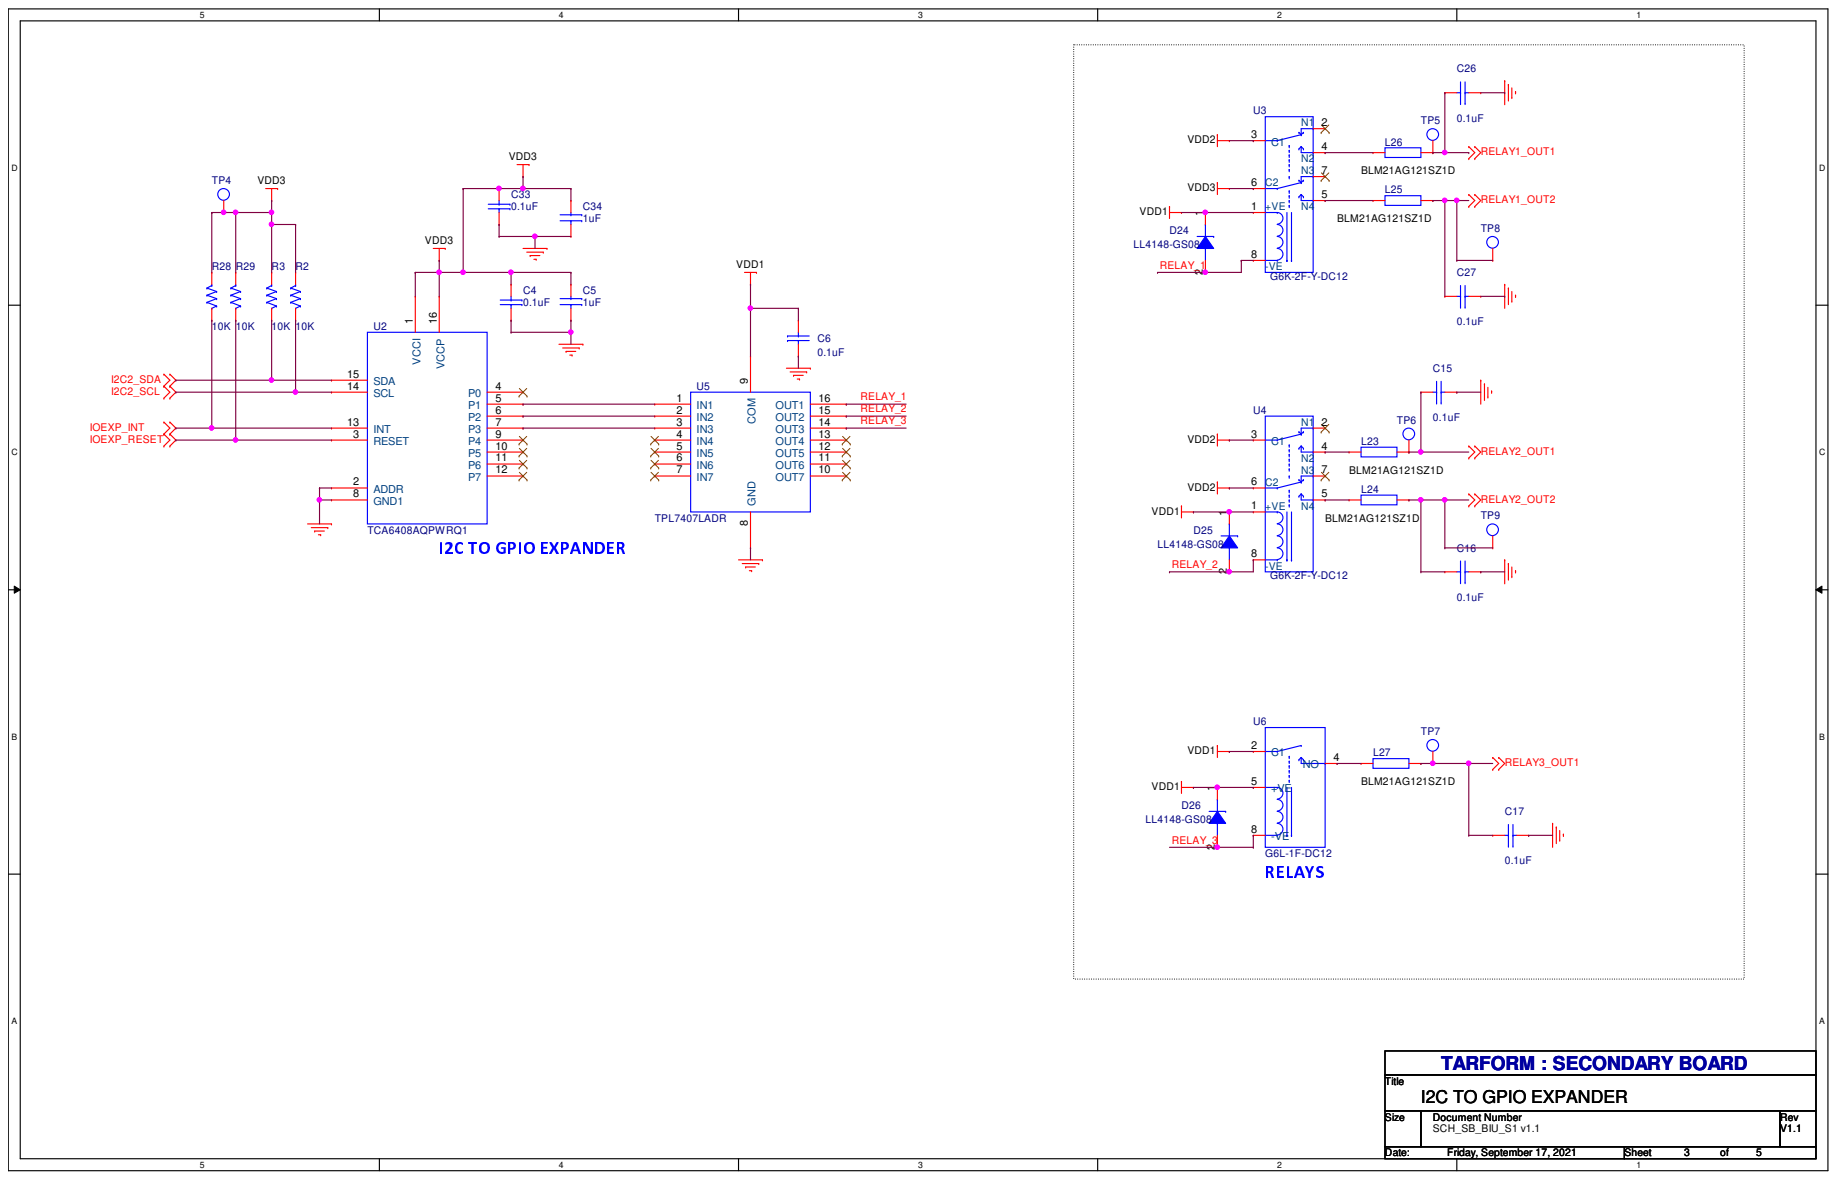
[picture p12: page 3]

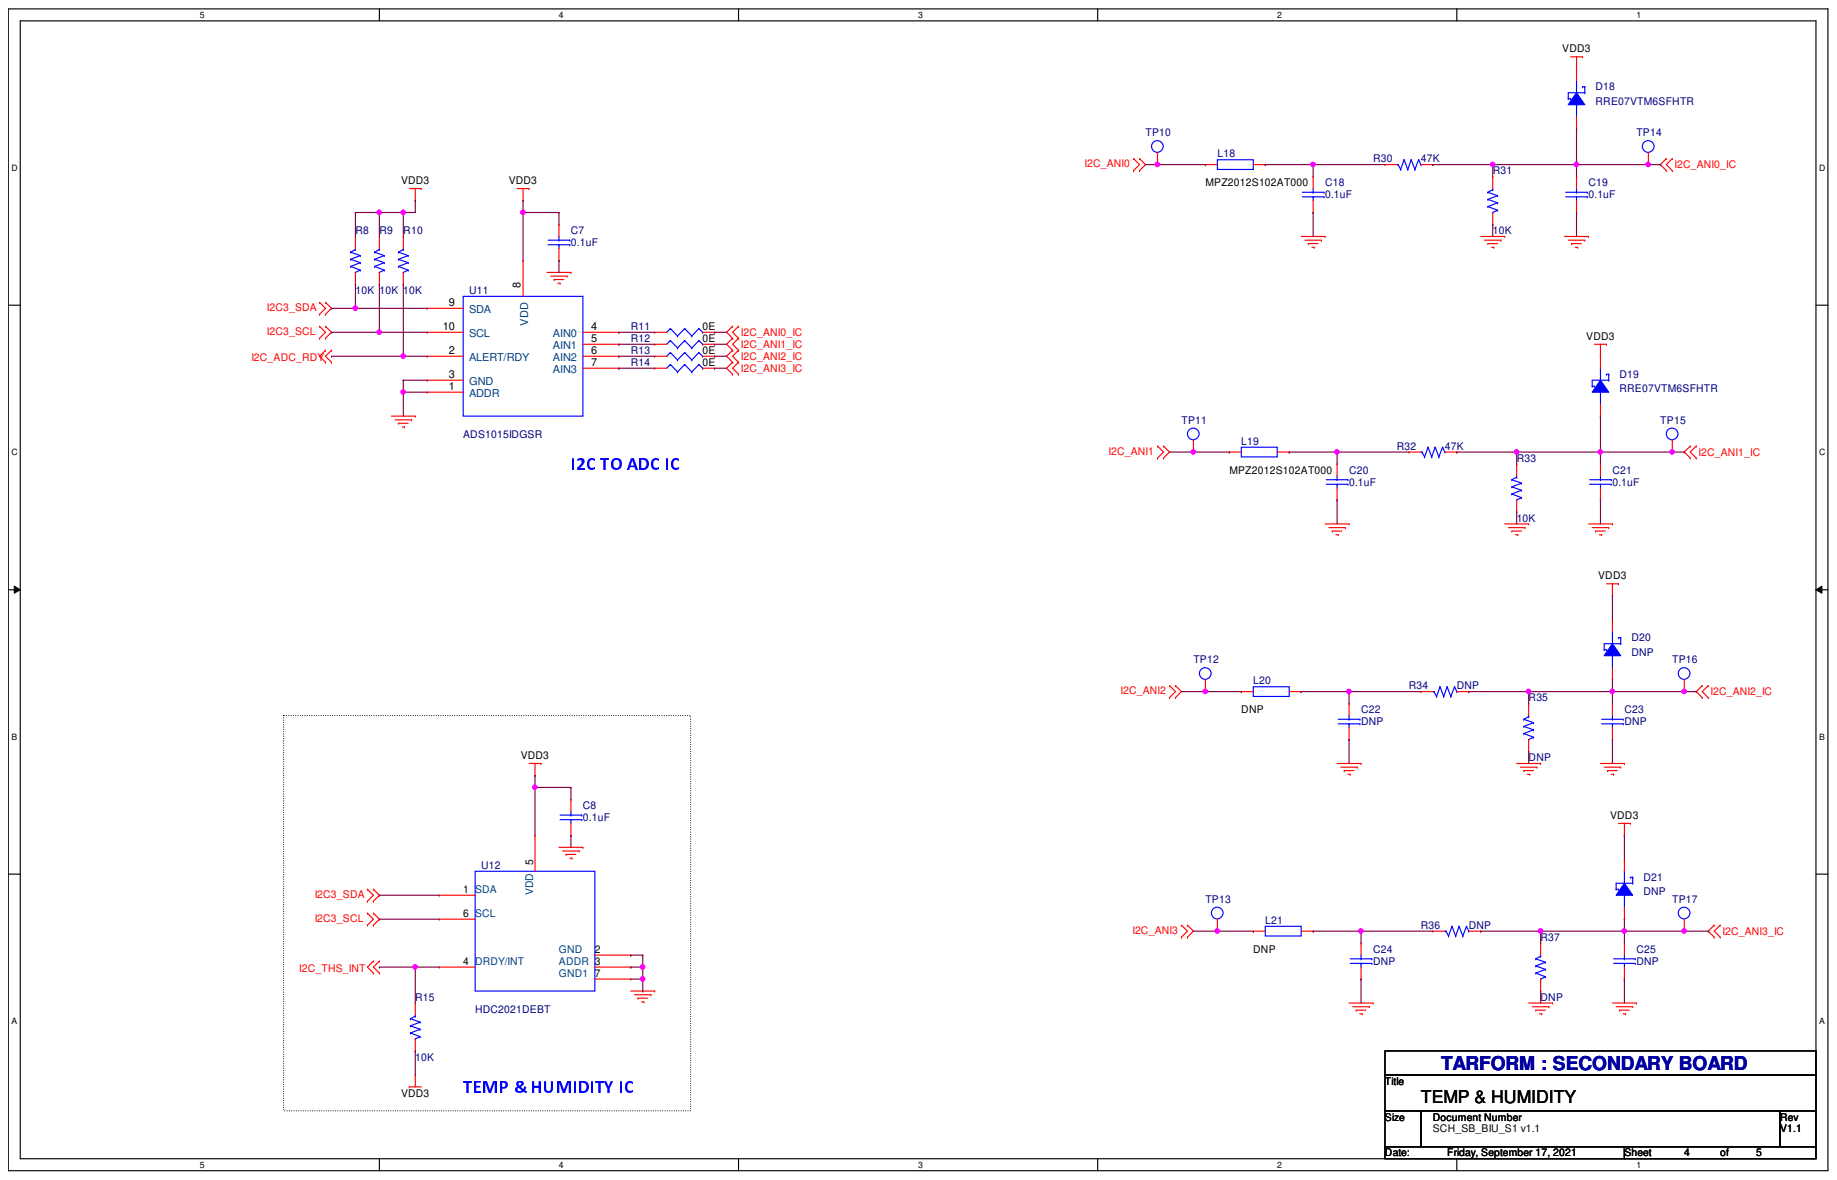
[picture p13: page 4]

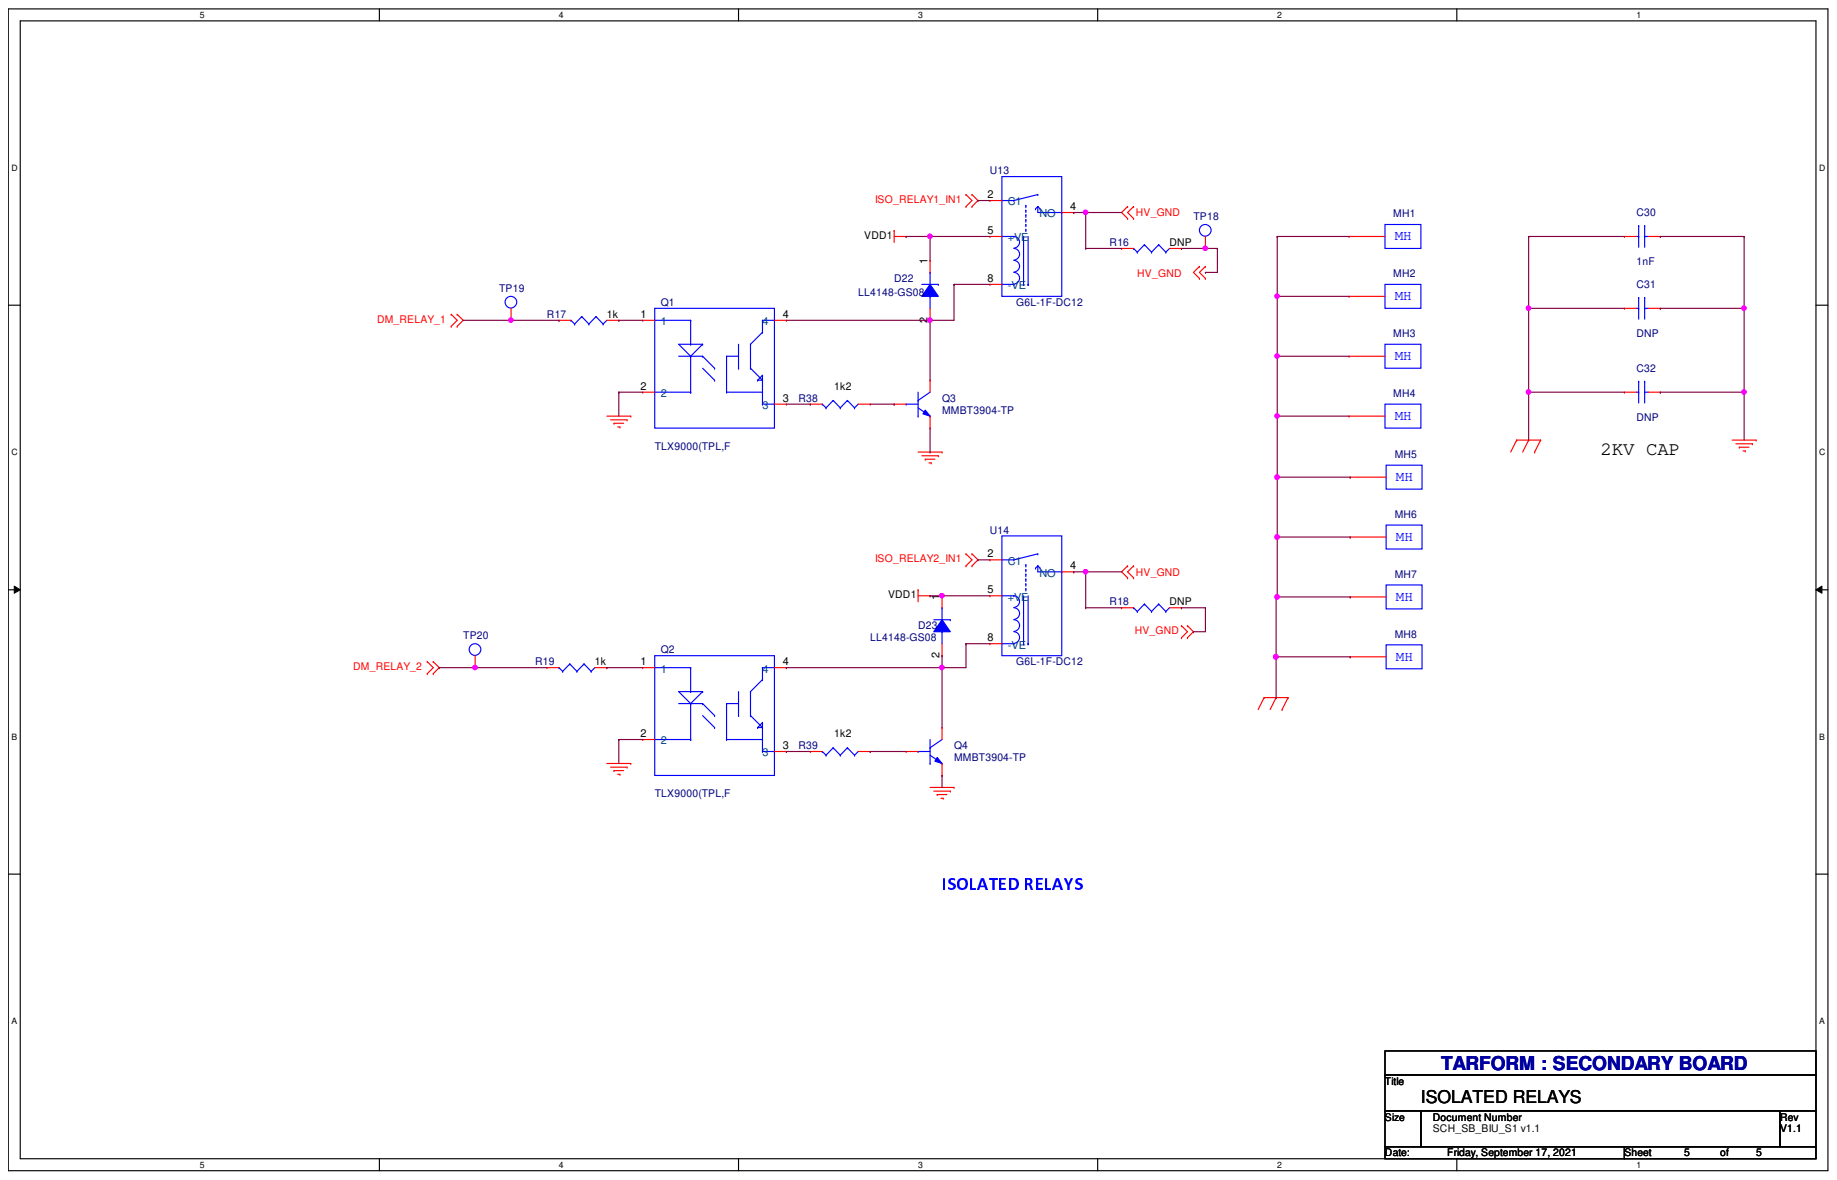
[picture p14: page 5]
