eSpark-Consulting-Group/robertmeares-vcu-bcu/Client-Files/BCU-PCBA-main/BCU-PCBA-main/BCU-PCBA/CARRIER BOARD 2.0/SCHEMATIC/Schematic in PDF/Schematic in PDF/embl51745_carrier card_sp2_v2-16072021.pdf

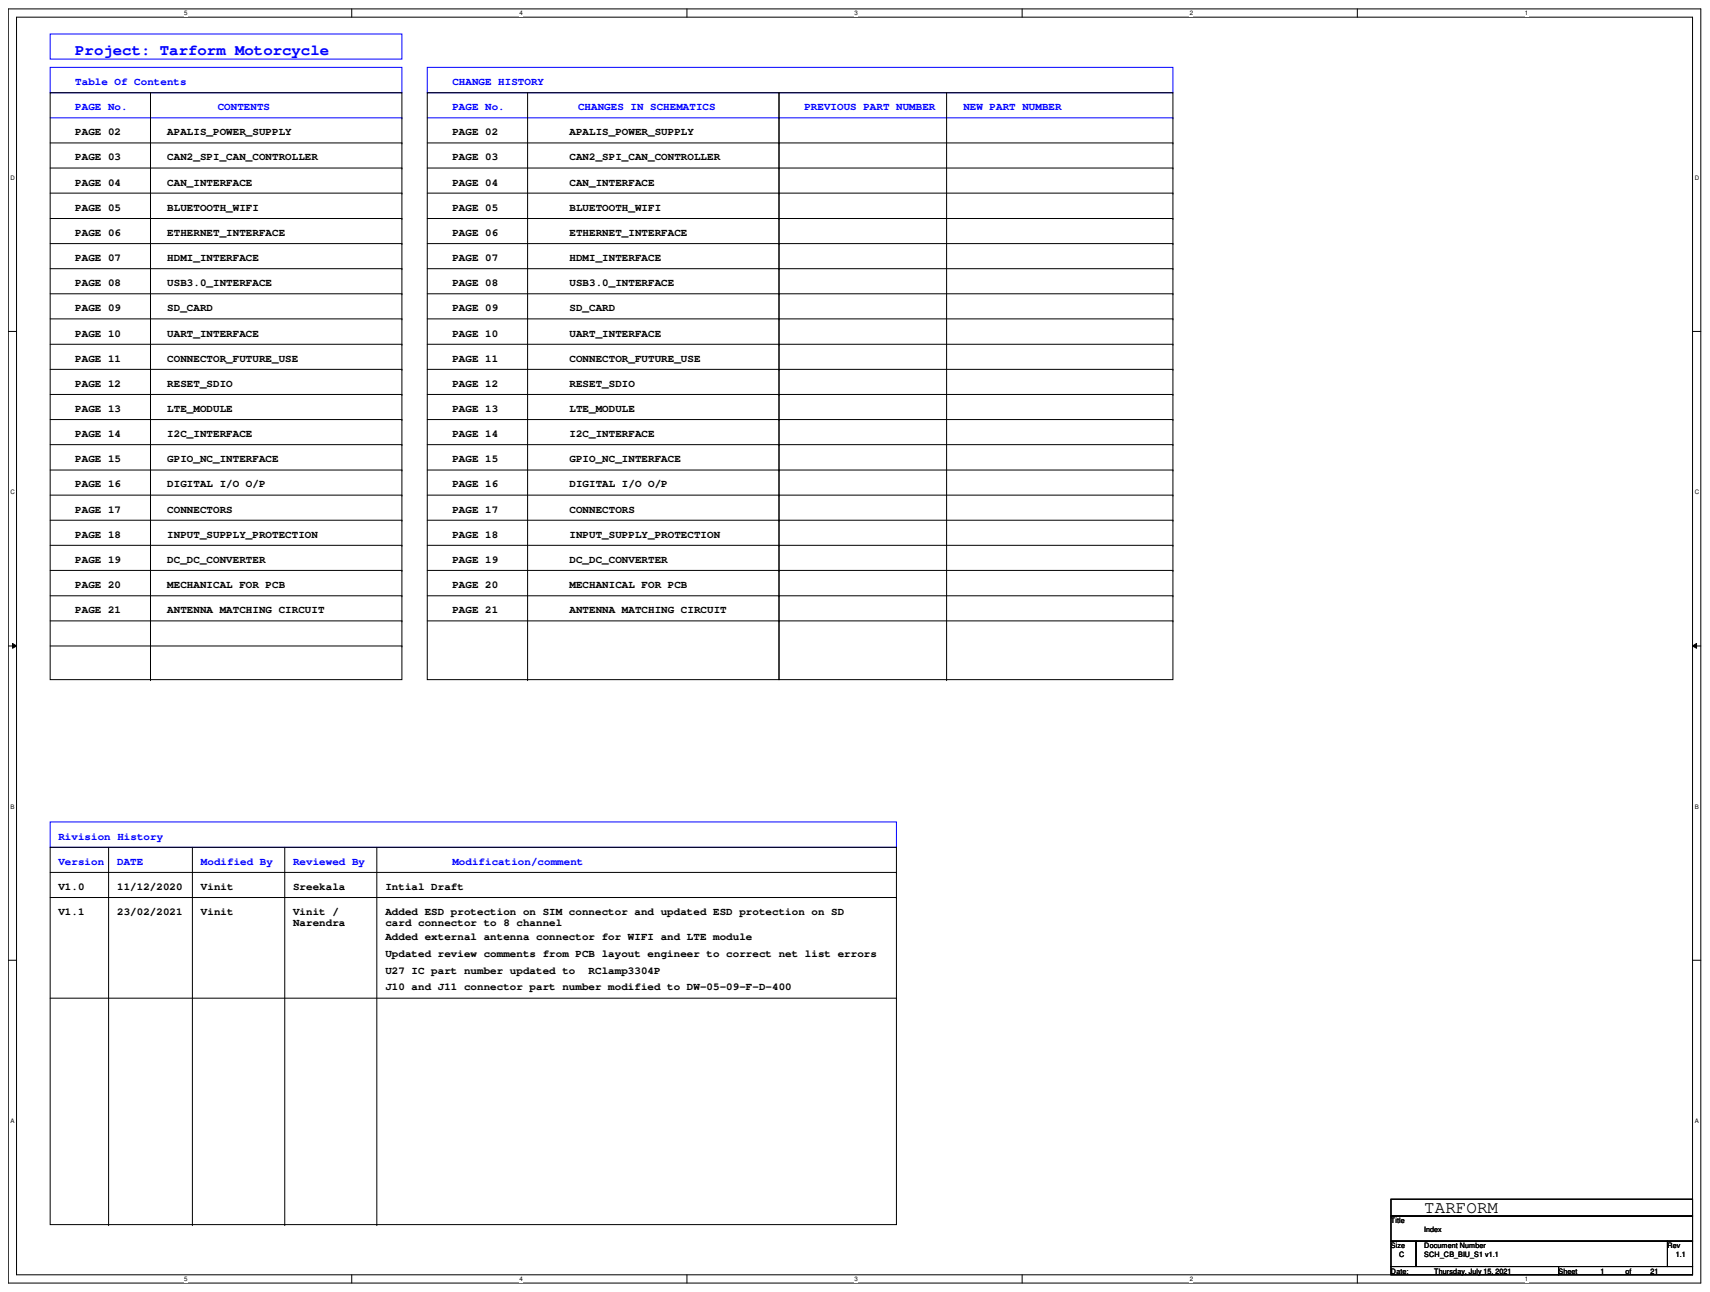
[picture p15: page 1]
PAGE 11; PAGE 09; PAGE 07; BLUETOOTH_WIFI; PAGE 08; CAN2_SPI_CAN_CONTROLLER; UART_INTERFACE; PAGE 06; PAGE 05; CONNECTOR_FUTURE_USE; PAGE 04; PAGE 03; USB3.0_INTERFACE; HDMI_INTERFACE; PAGE 02; CAN_INTERFACE; CONTENTS; PAGE 10; CHANGE HISTORY; SD_CARD; ETHERNET_INTERFACE; PAGE No.; APALIS_POWER_SUPPLY; CHANGES IN SCHEMATICS; NEW PART NUMBER; Vinit; Version; Modified By; Sreekala; DATE; Reviewed By; Rivision History; Modification/comment; PAGE 15; PAGE 13; PAGE 14; PAGE 12; PAGE 16; PAGE 20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

Project: Tarform Motorcycle

Table Of Contents

PREVIOUS PART NUMBER

MECHANICAL FOR PCB

ANTENNA MATCHING CIRCUIT

Added ESD protection on SIM connector and updated ESD protection on SD
card connector to 8 channel
Added external antenna connector for WIFI and LTE module
Updated review comments from PCB layout engineer to correct net list errors
J10 and J11 connector part number modified to DW-05-09-F-D-400

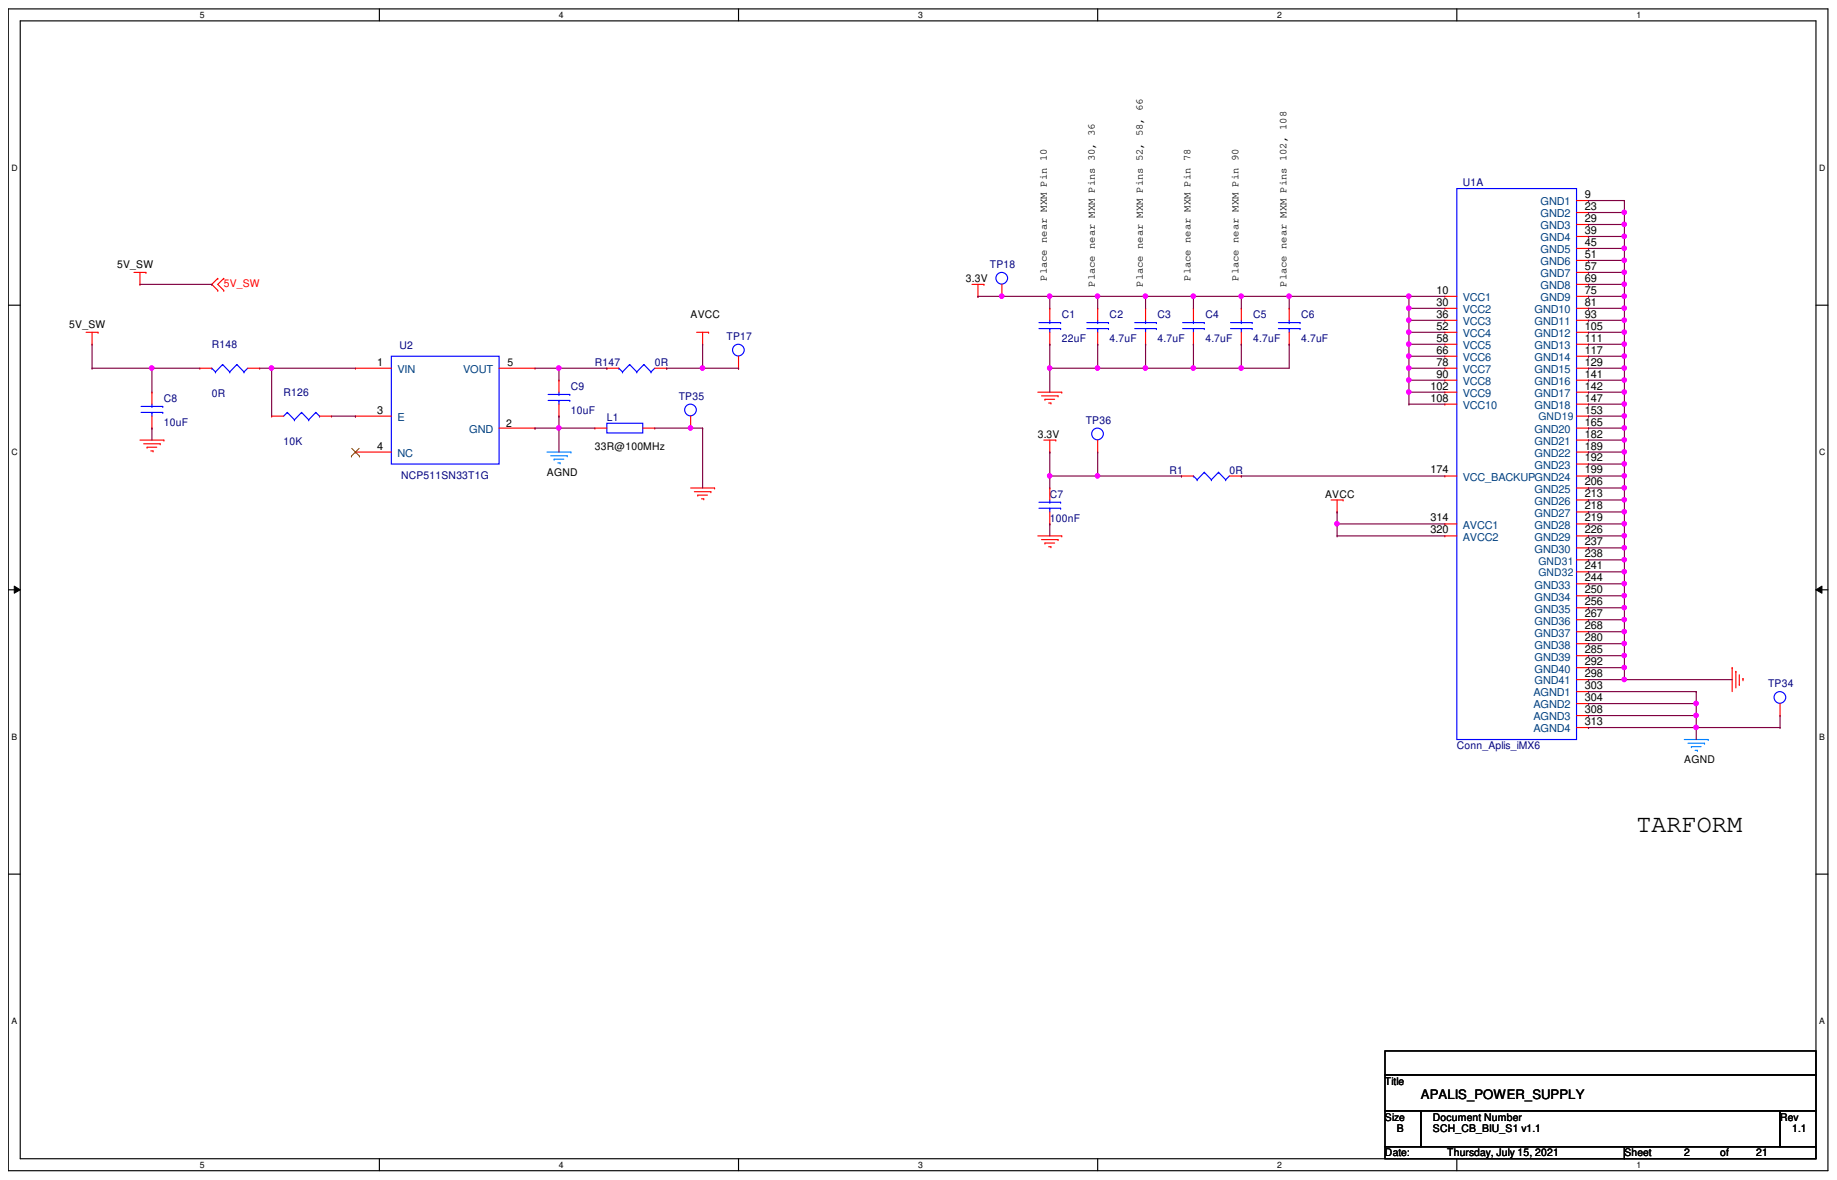
[picture p16: page 2]

Place near MXM Pins 52, 58, 66

Place near MXM Pins 102, 108

Place near MXM Pins 30, 36

Place near MXM Pin 10

Place near MXM Pin 78

Place near MXM Pin 90

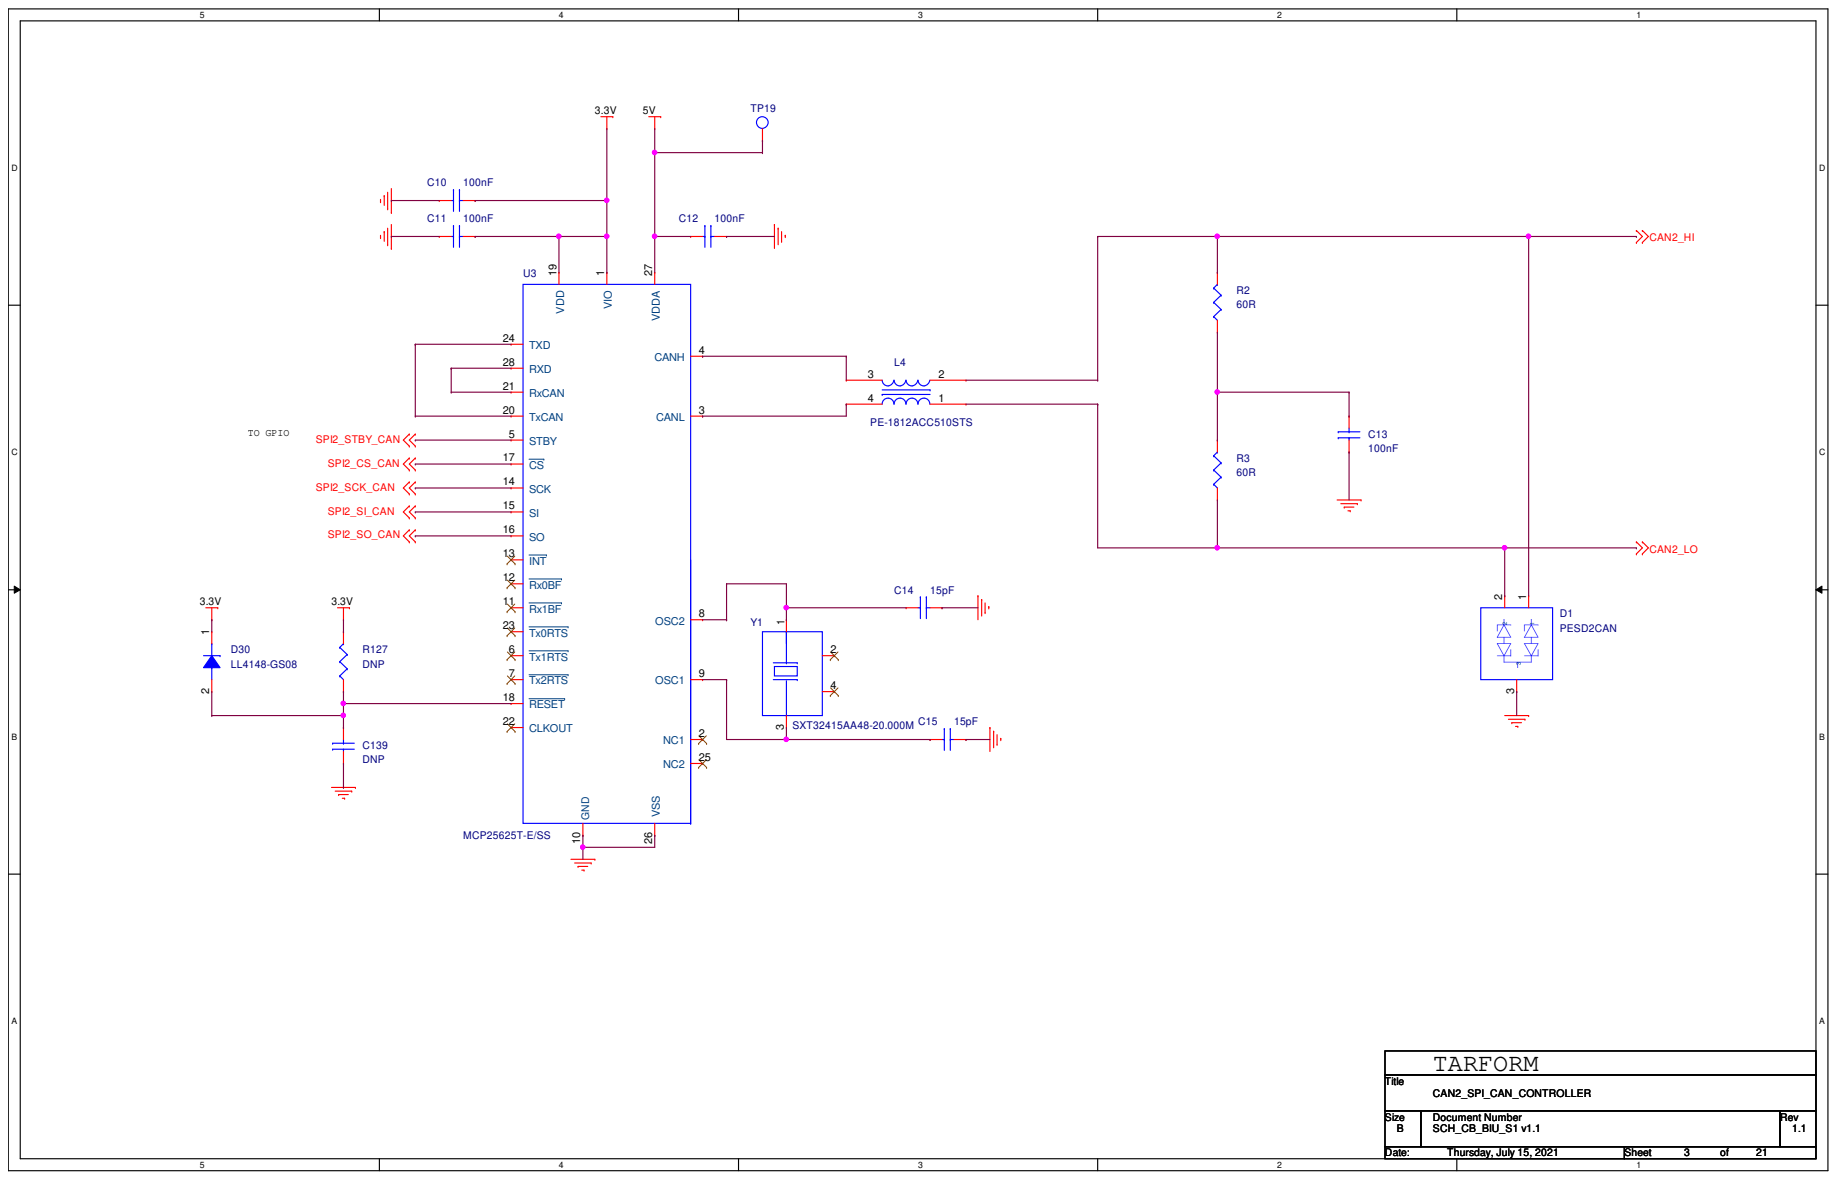
[picture p17: page 3]

# MAX14882AWE+T

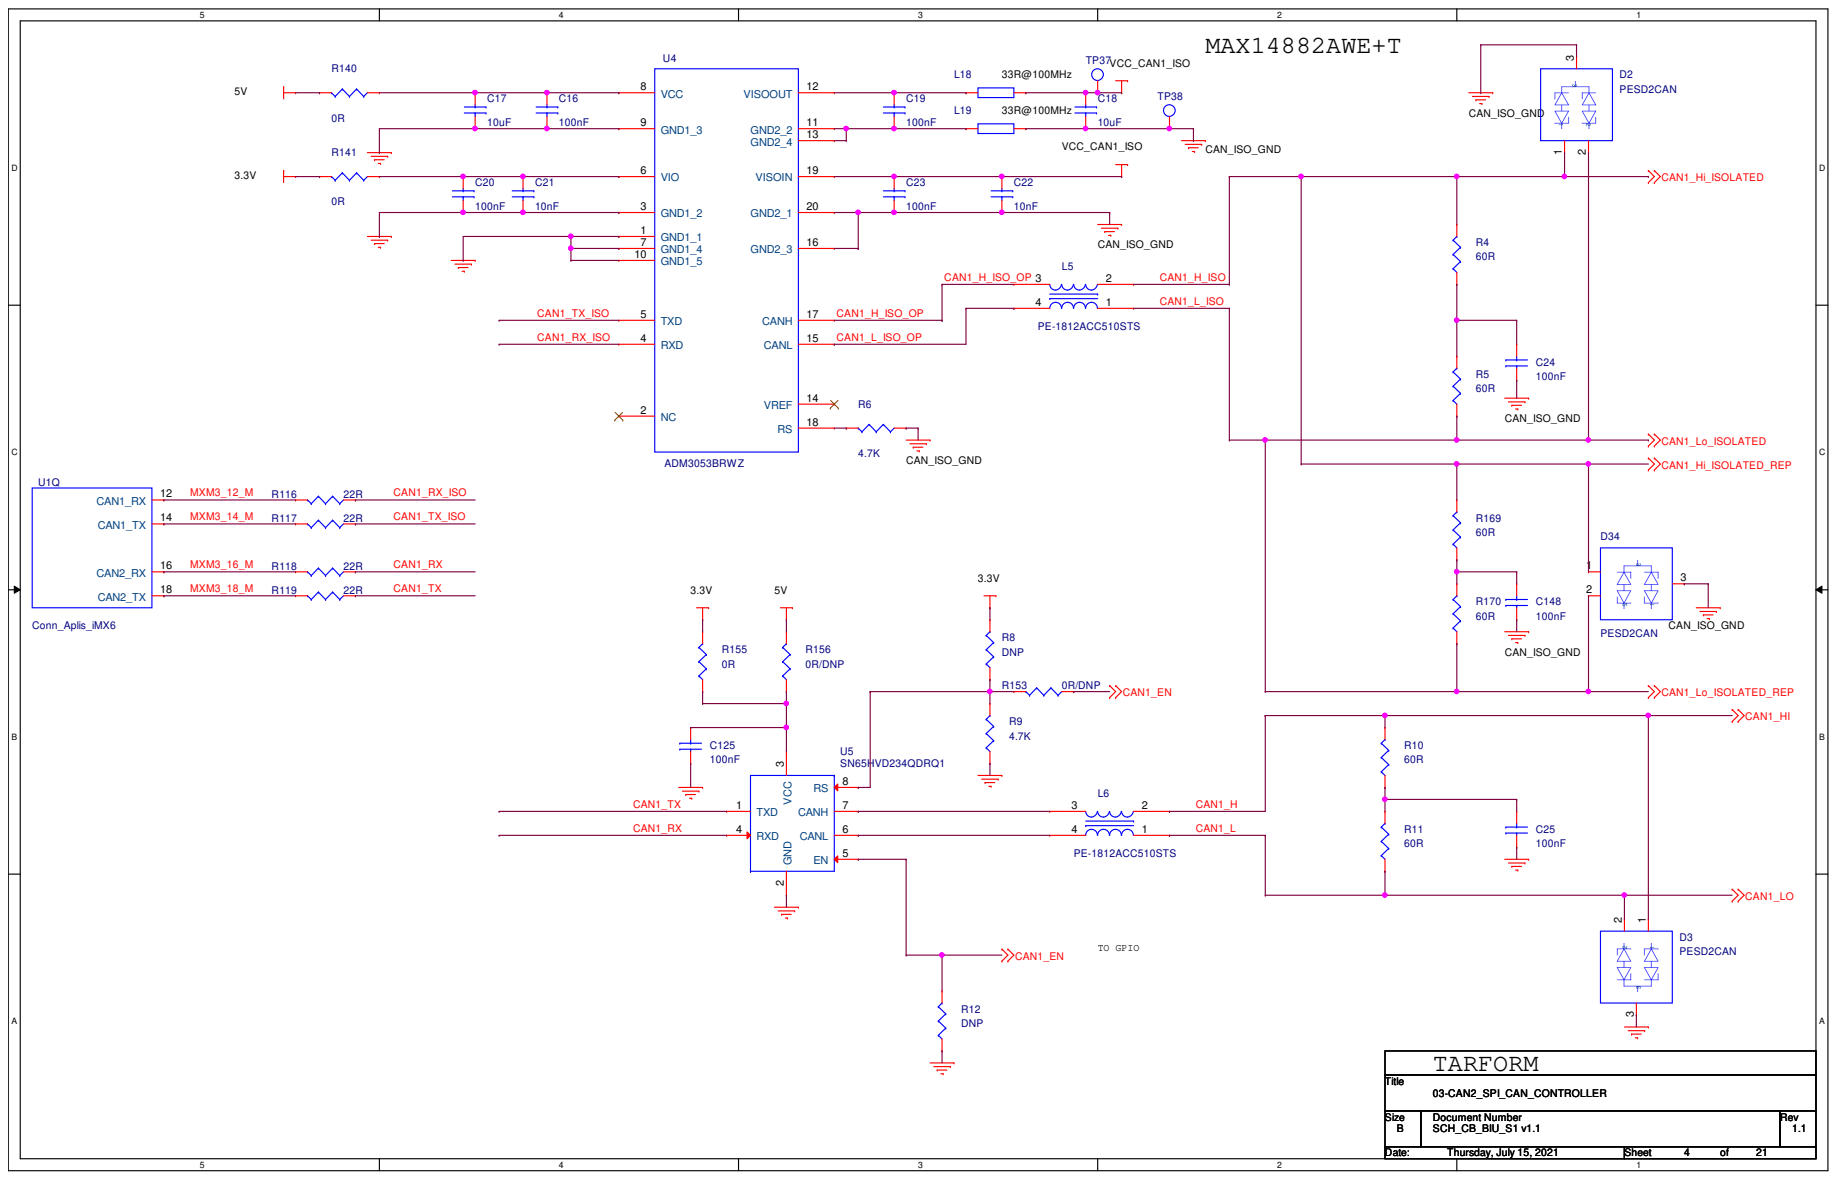
[picture p18: page 4]

# Bluetooth And Wi-Fi module

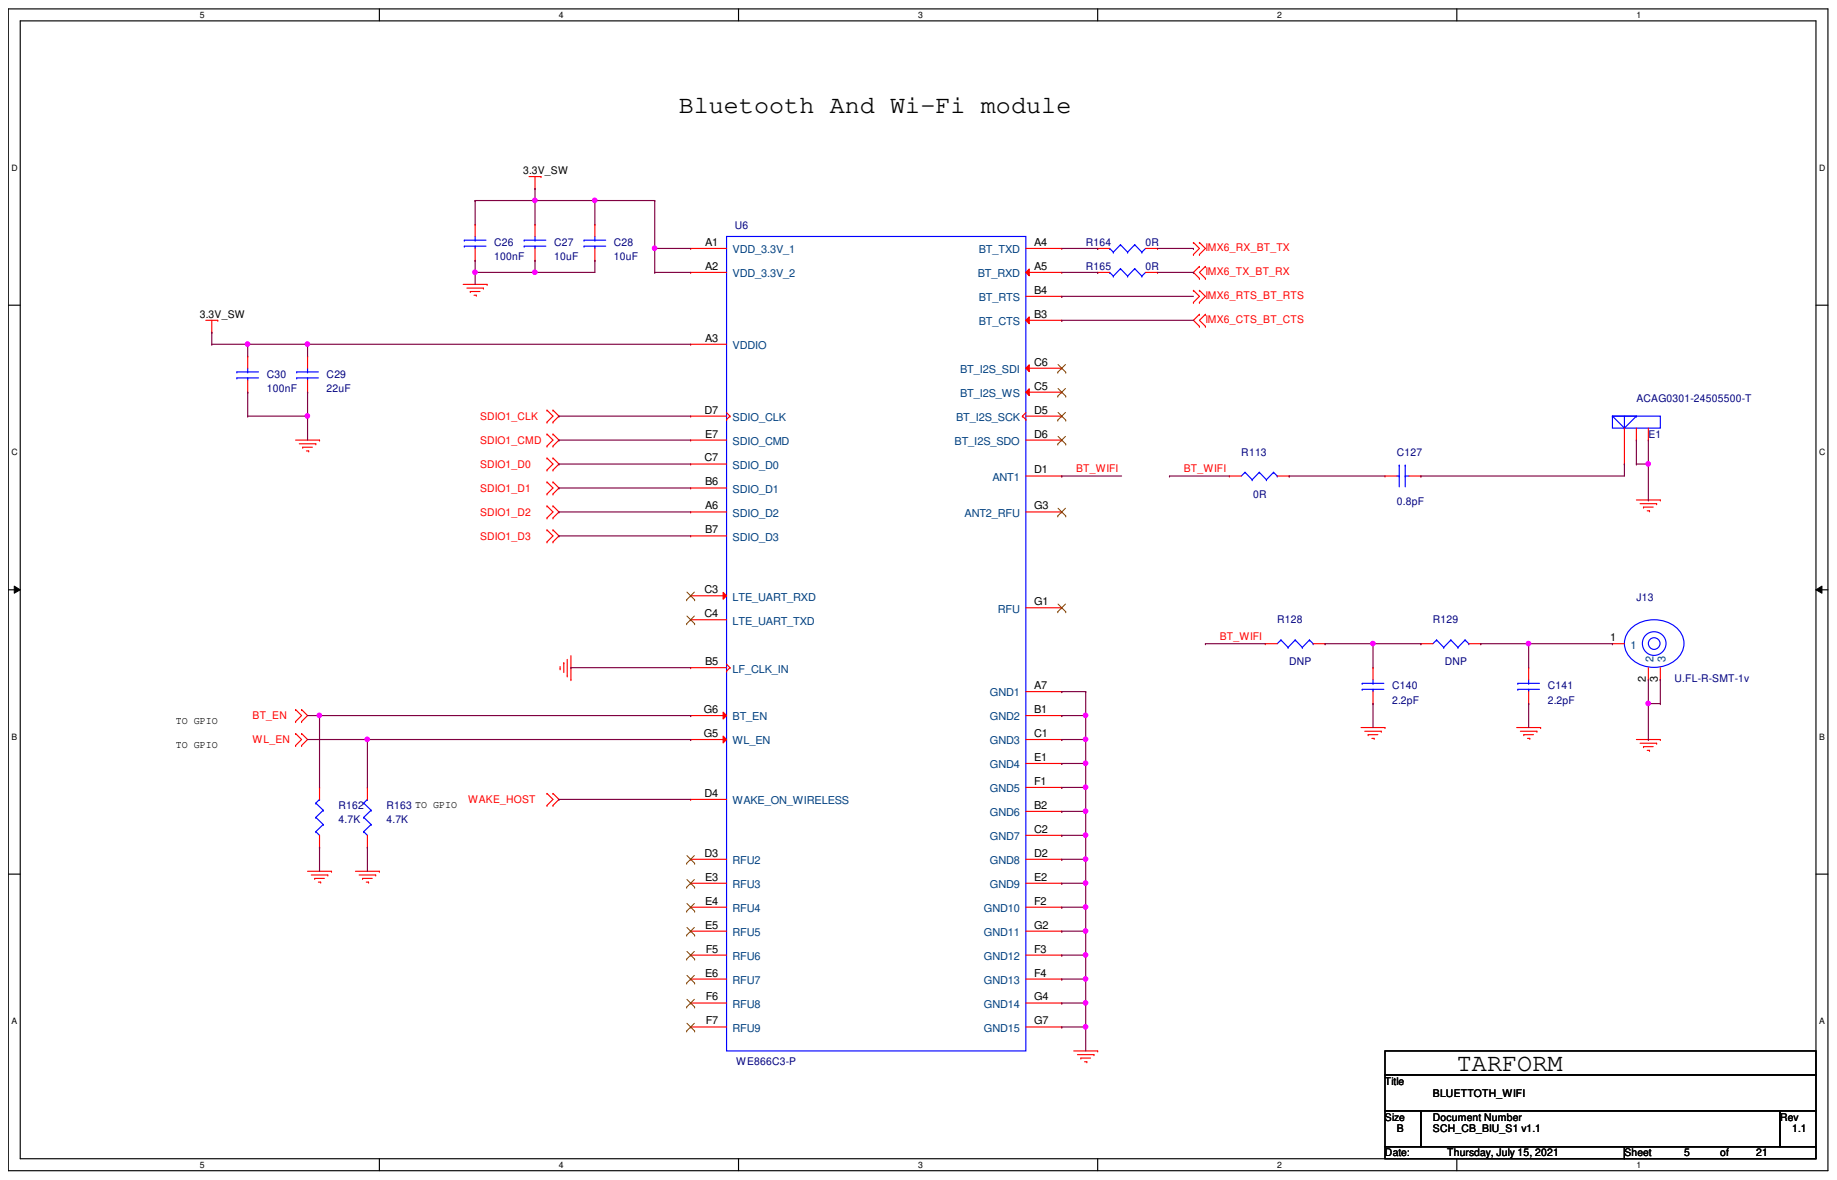
[picture p19: page 5]

# ETHERNET INTERFACE

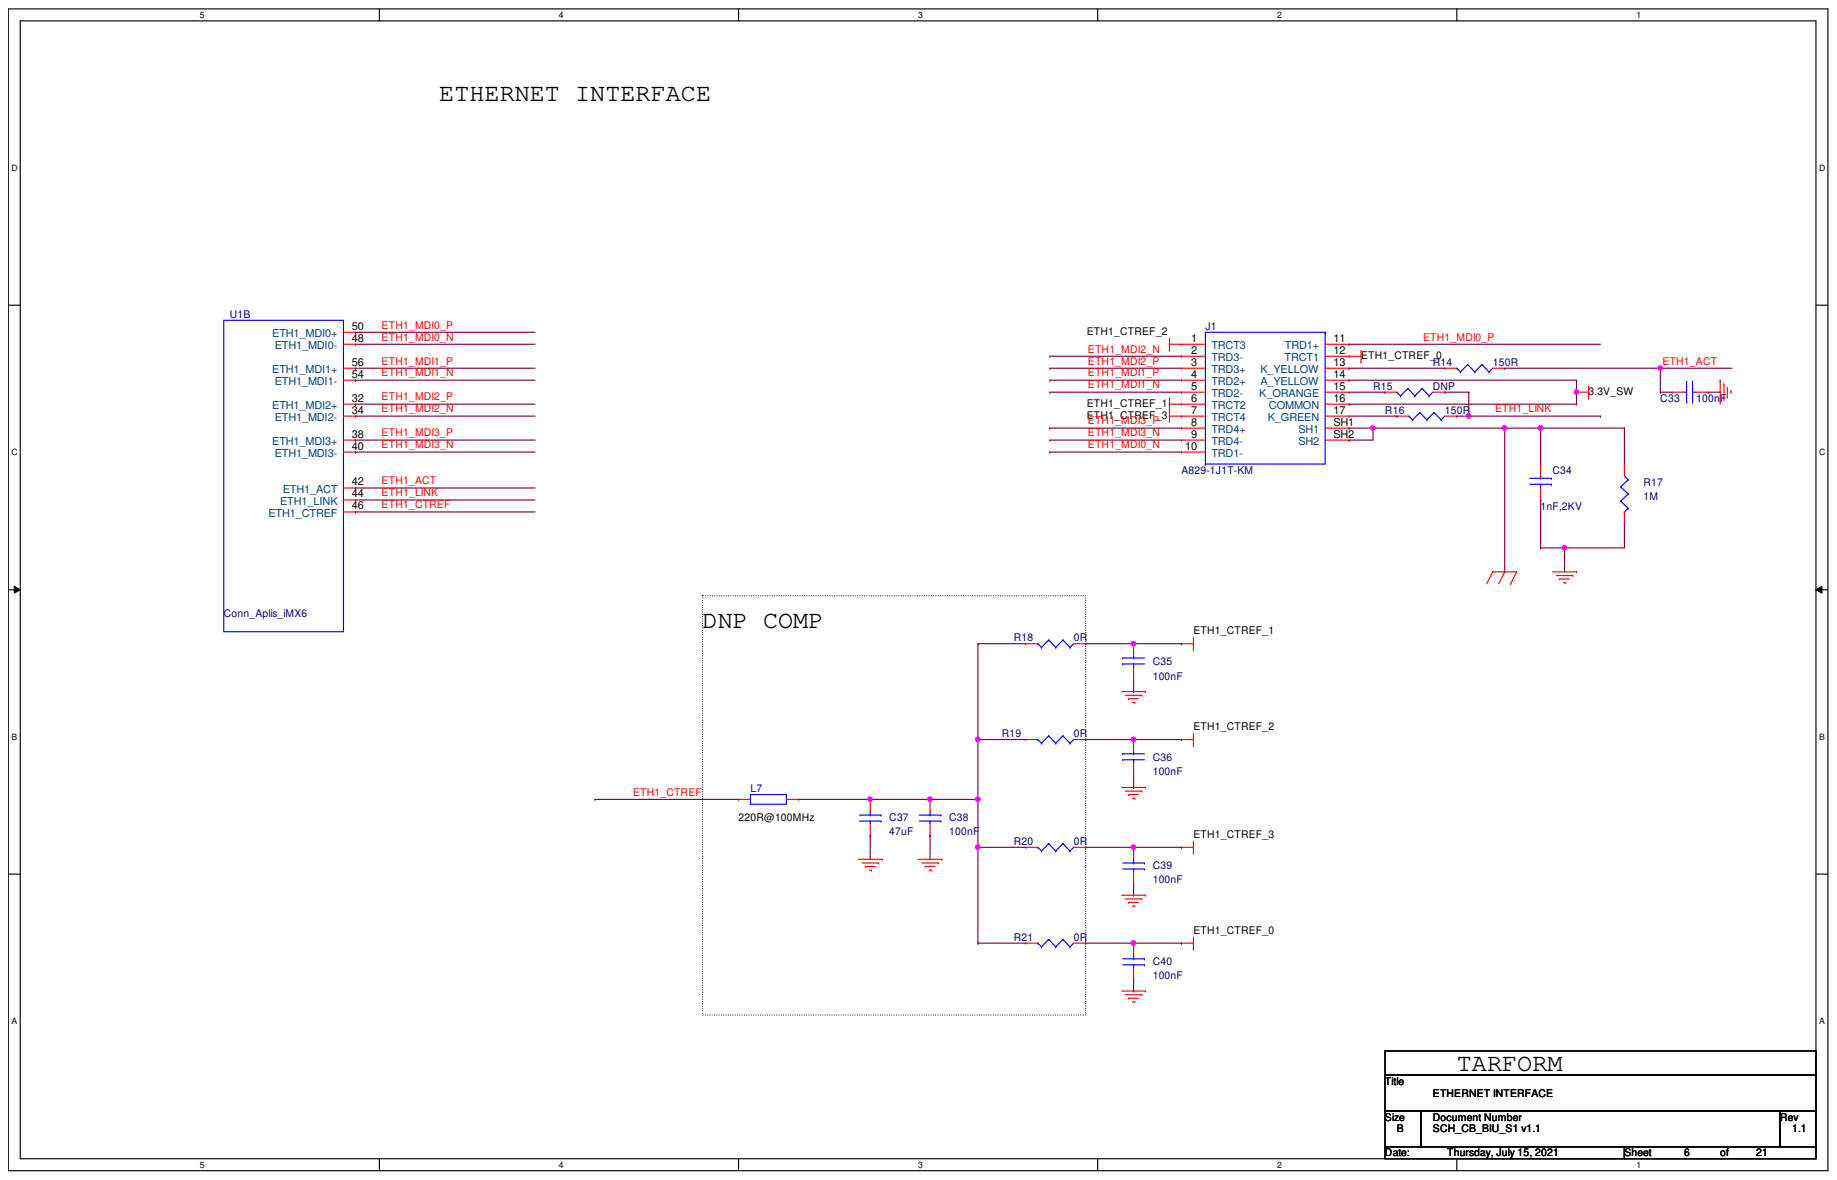
[picture p20: page 6]

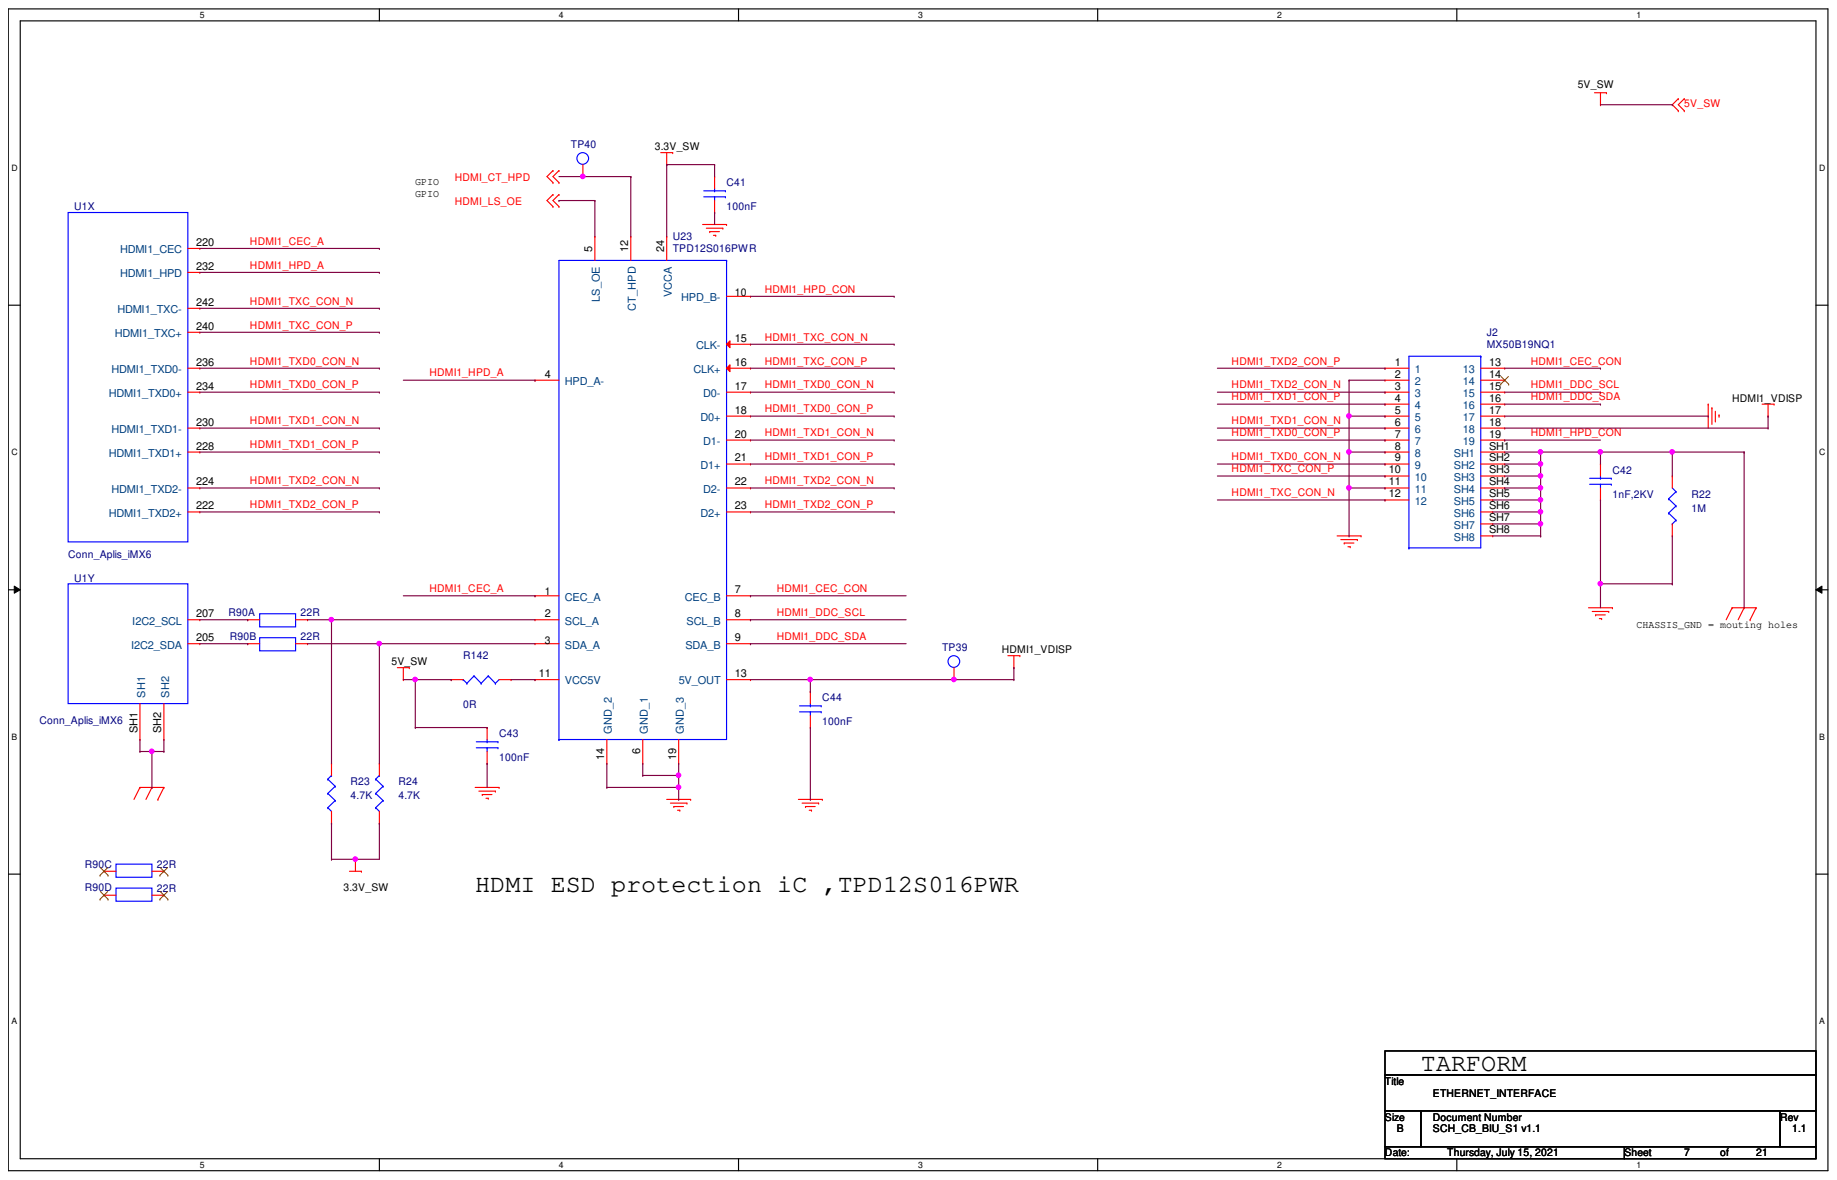
[picture p21: page 7]

HDMI ESD protection iC ,TPD12S016PWR

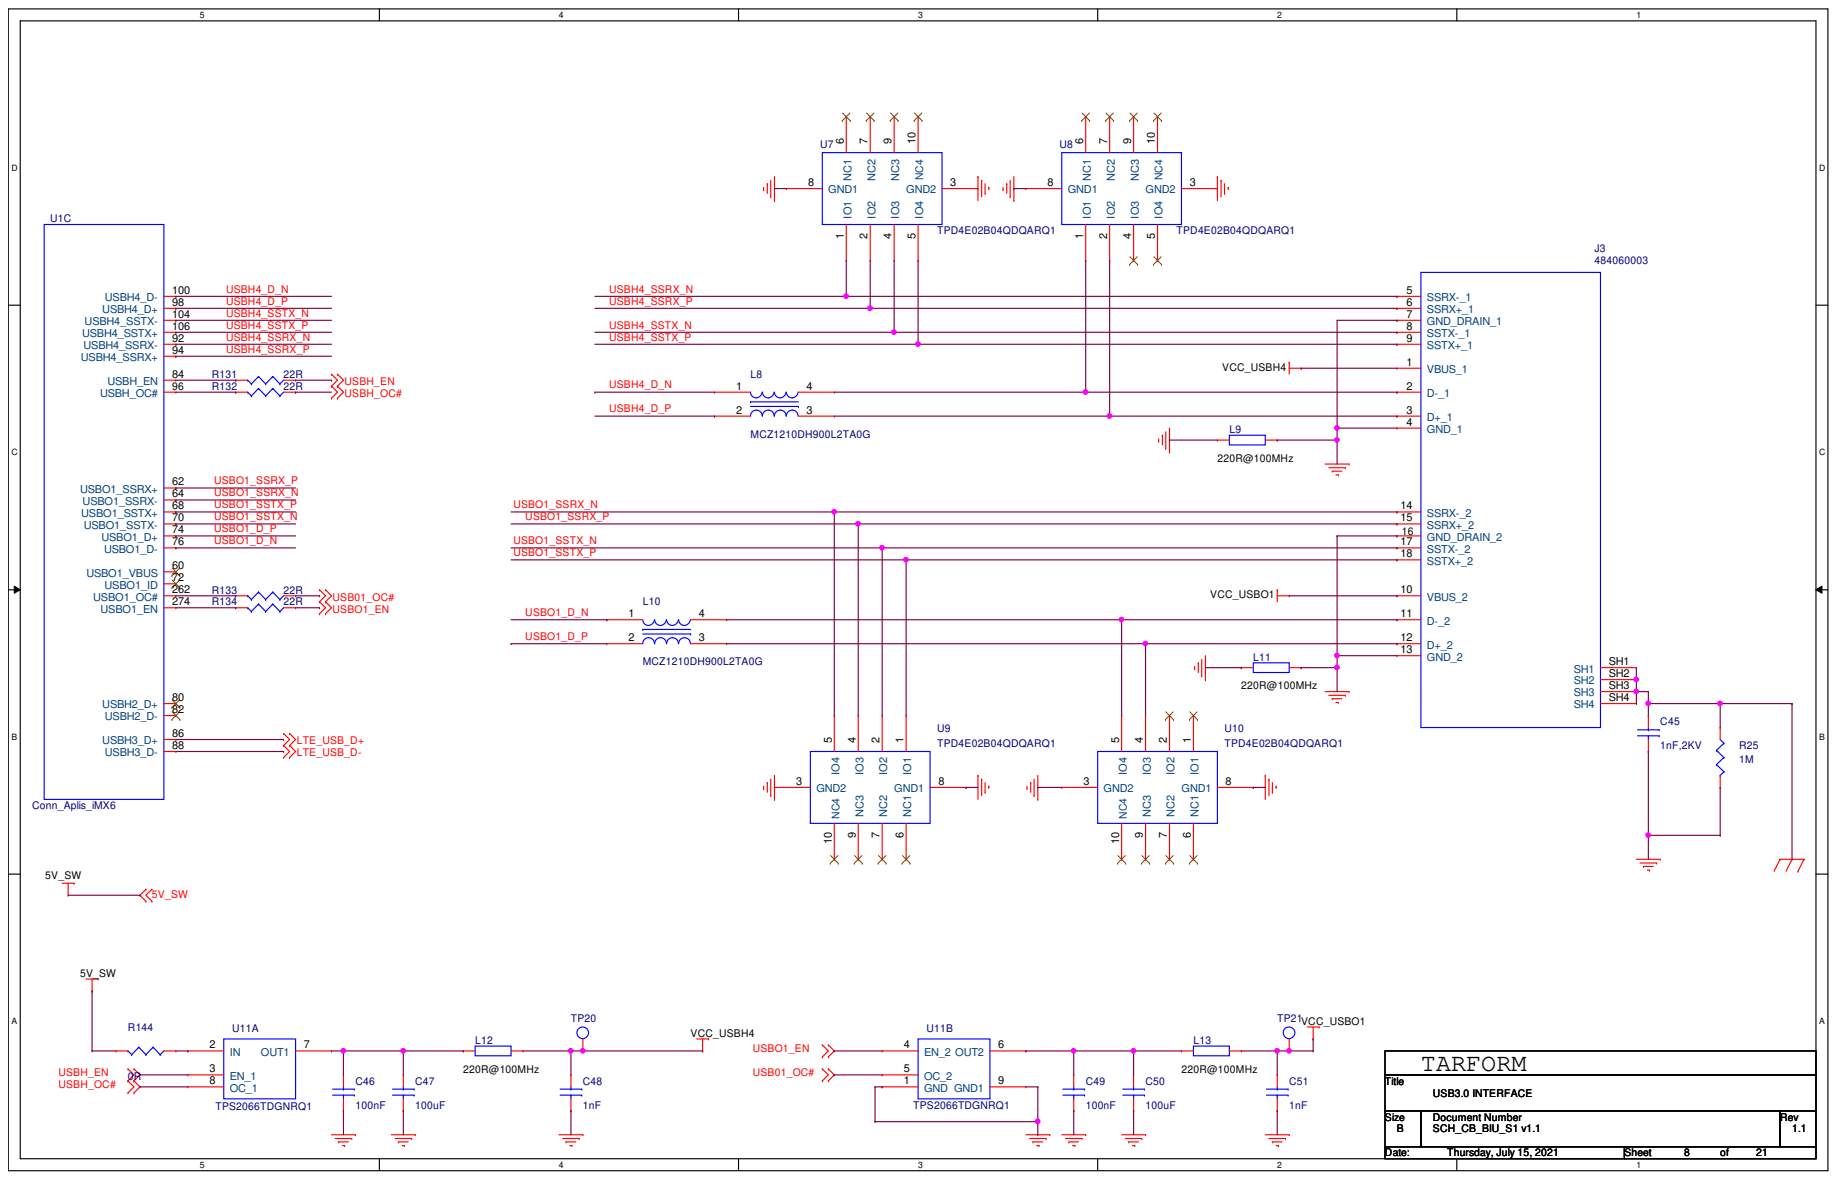
[picture p22: page 8]

# MICRO SD CARD INTERFACE

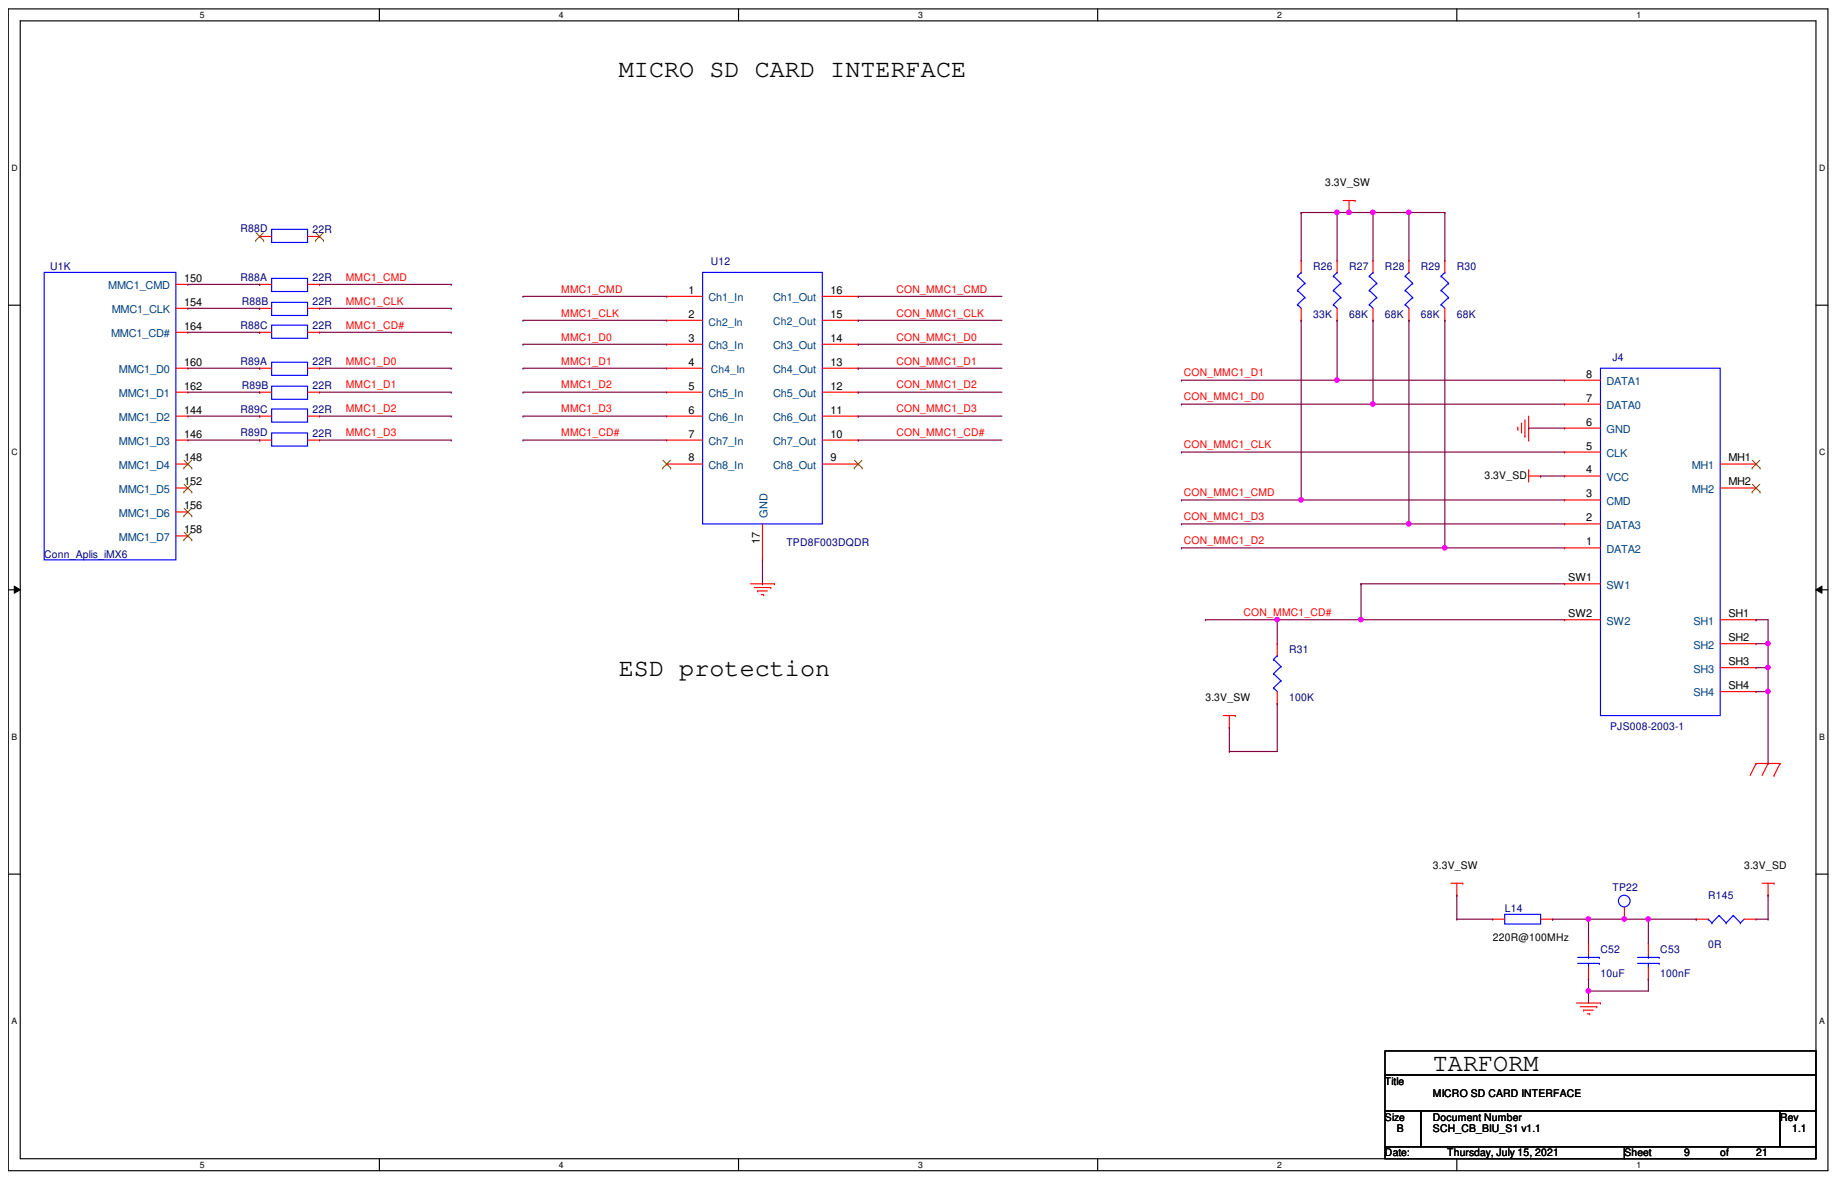
[picture p23: page 9]

MICRO SD CARD INTERFACE

# UART INTERFACE

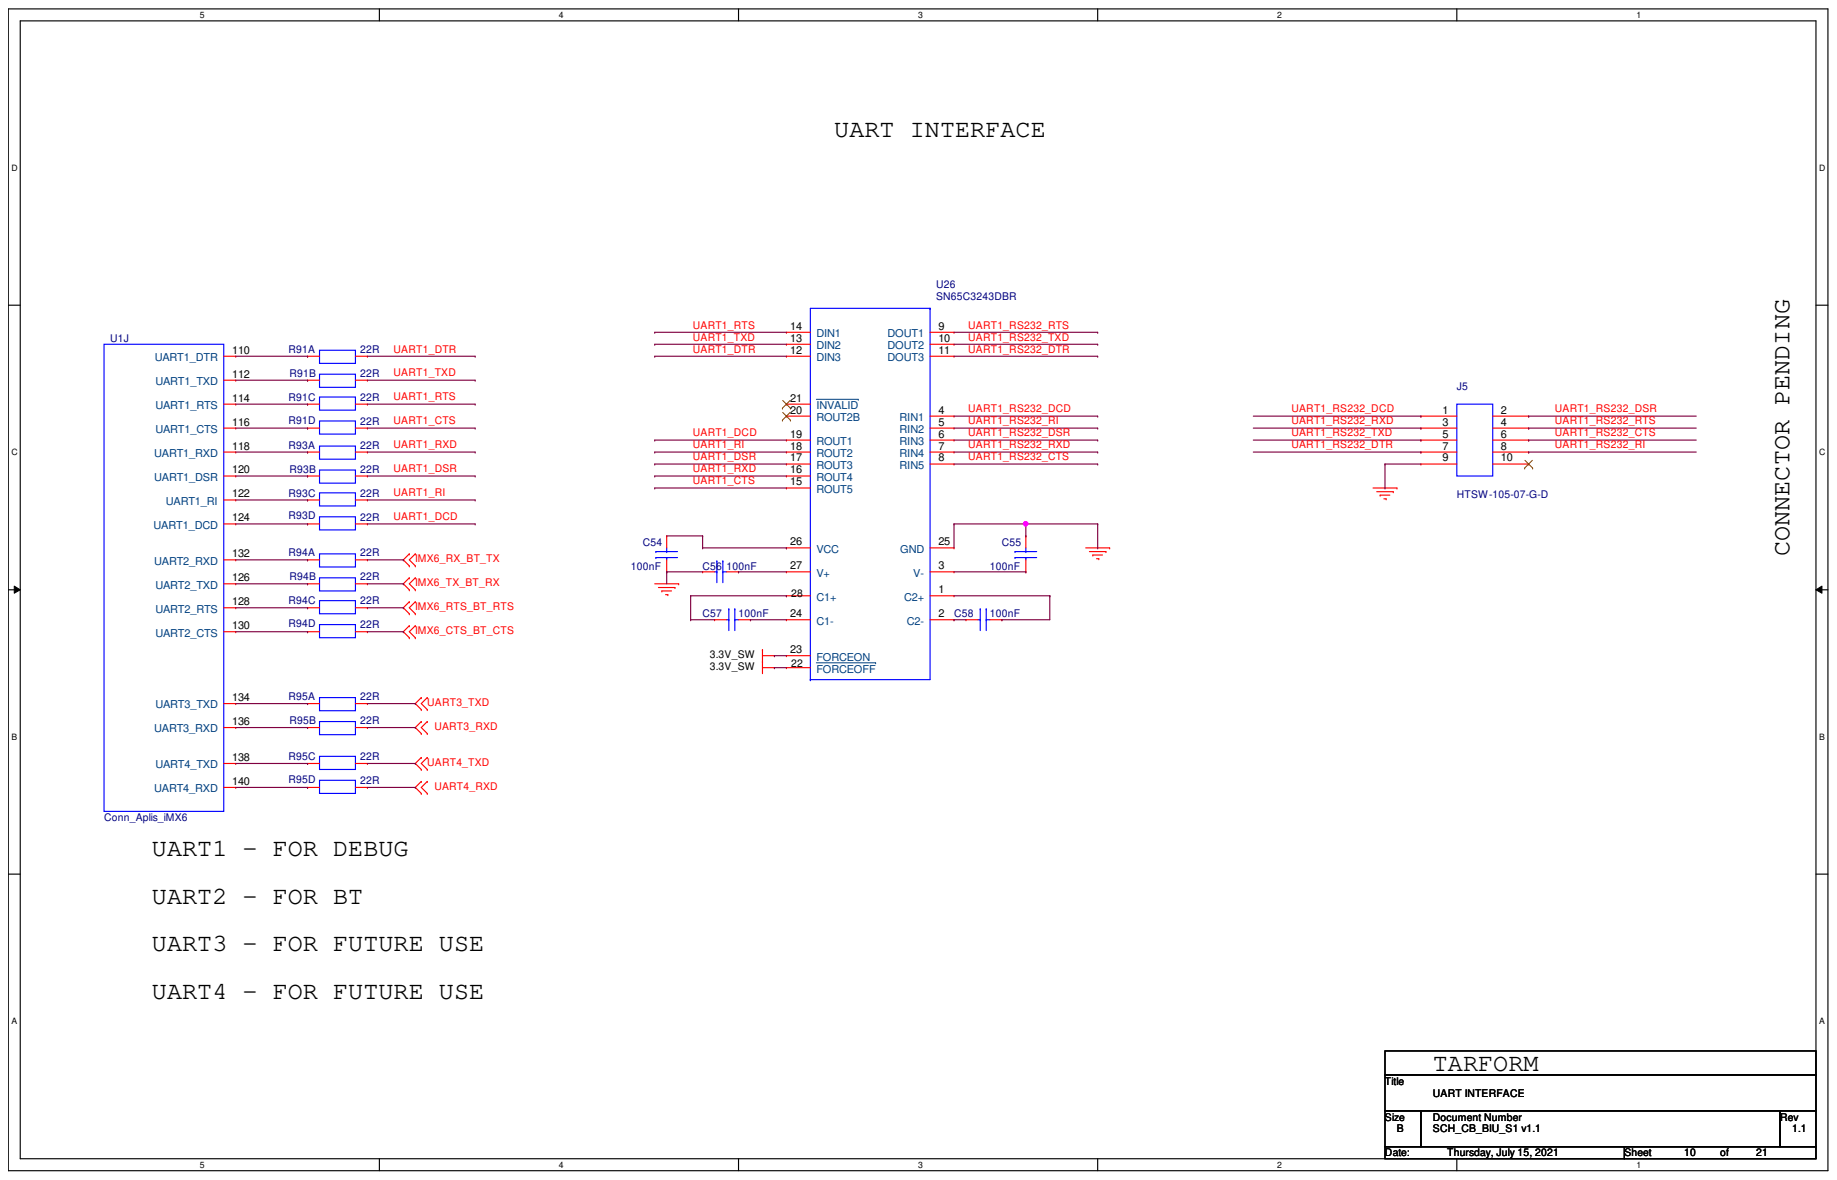
[picture p24: page 10]

# FUTURE USE CONNECTOR

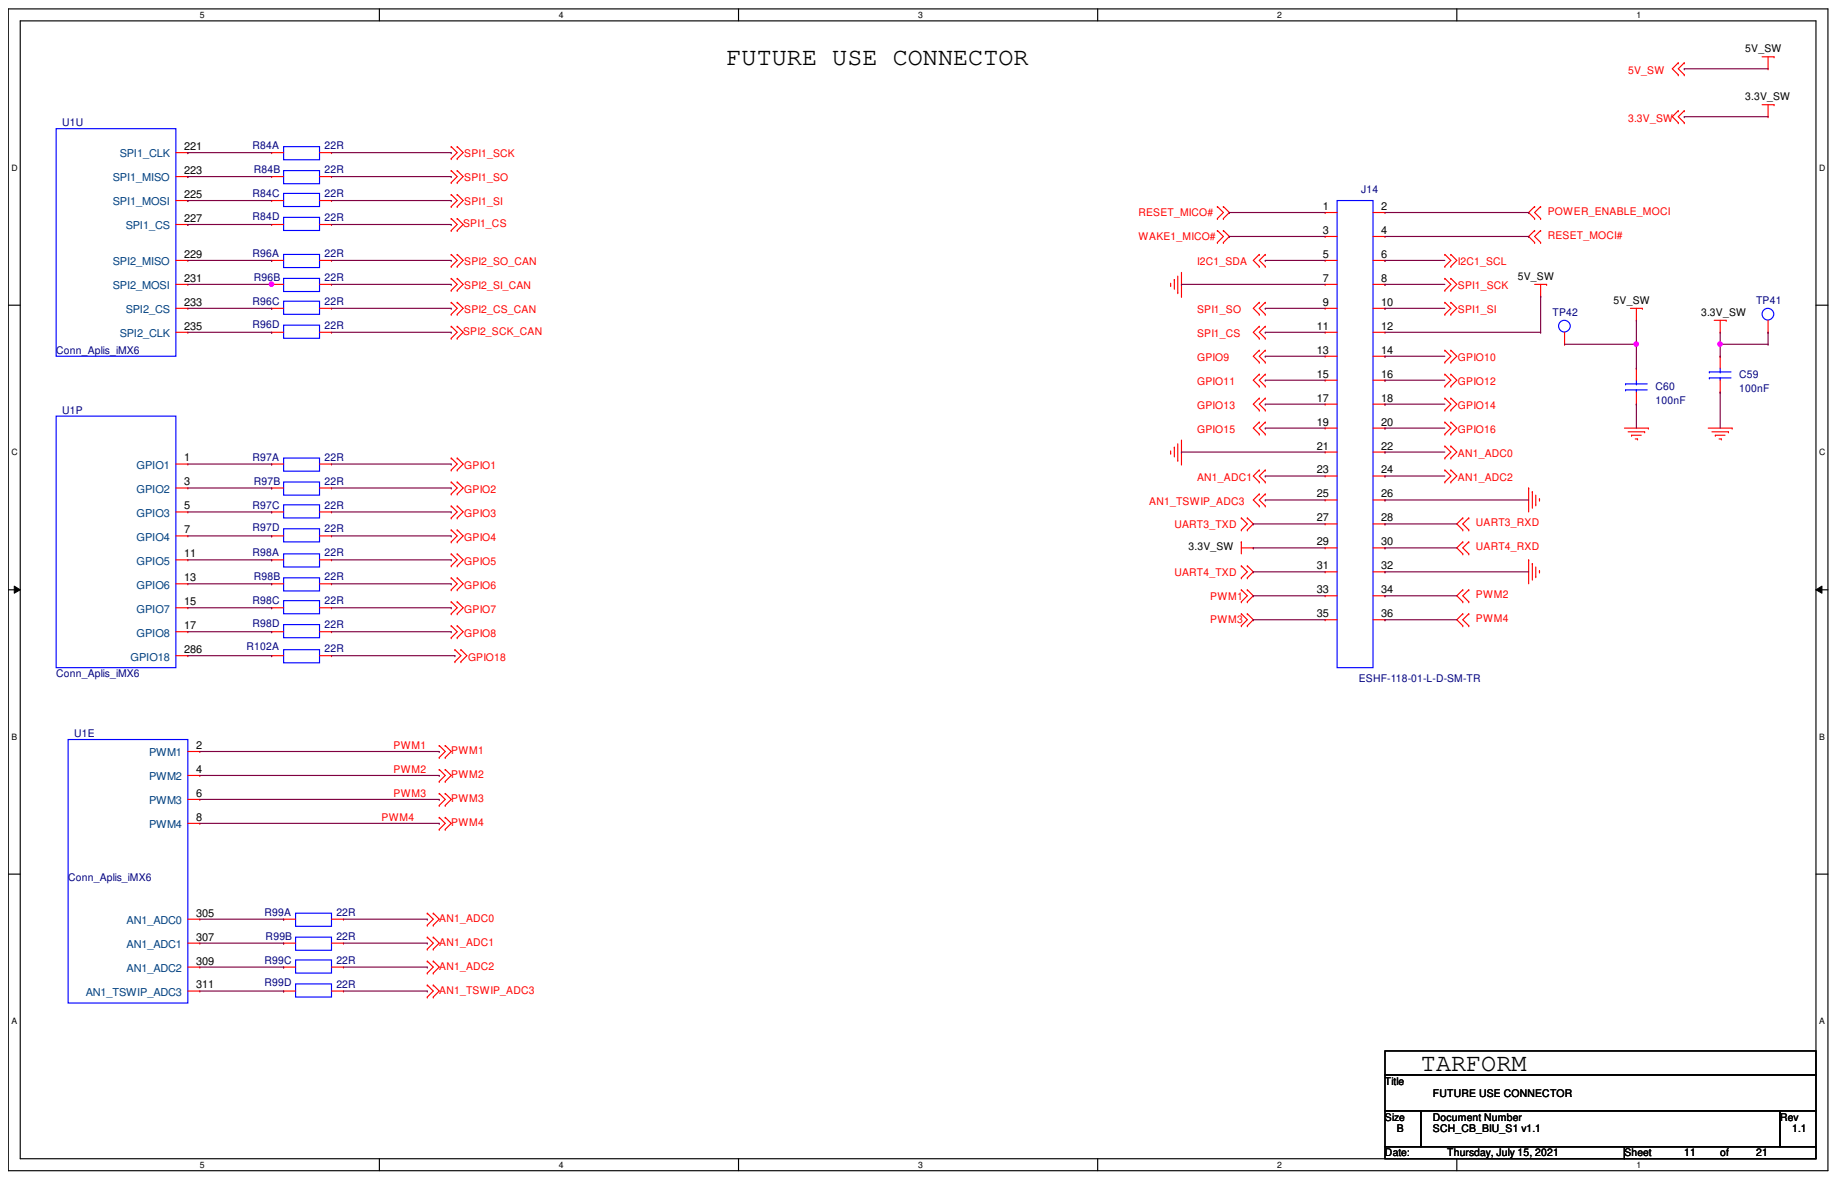
[picture p25: page 11]

3.3V
U1D

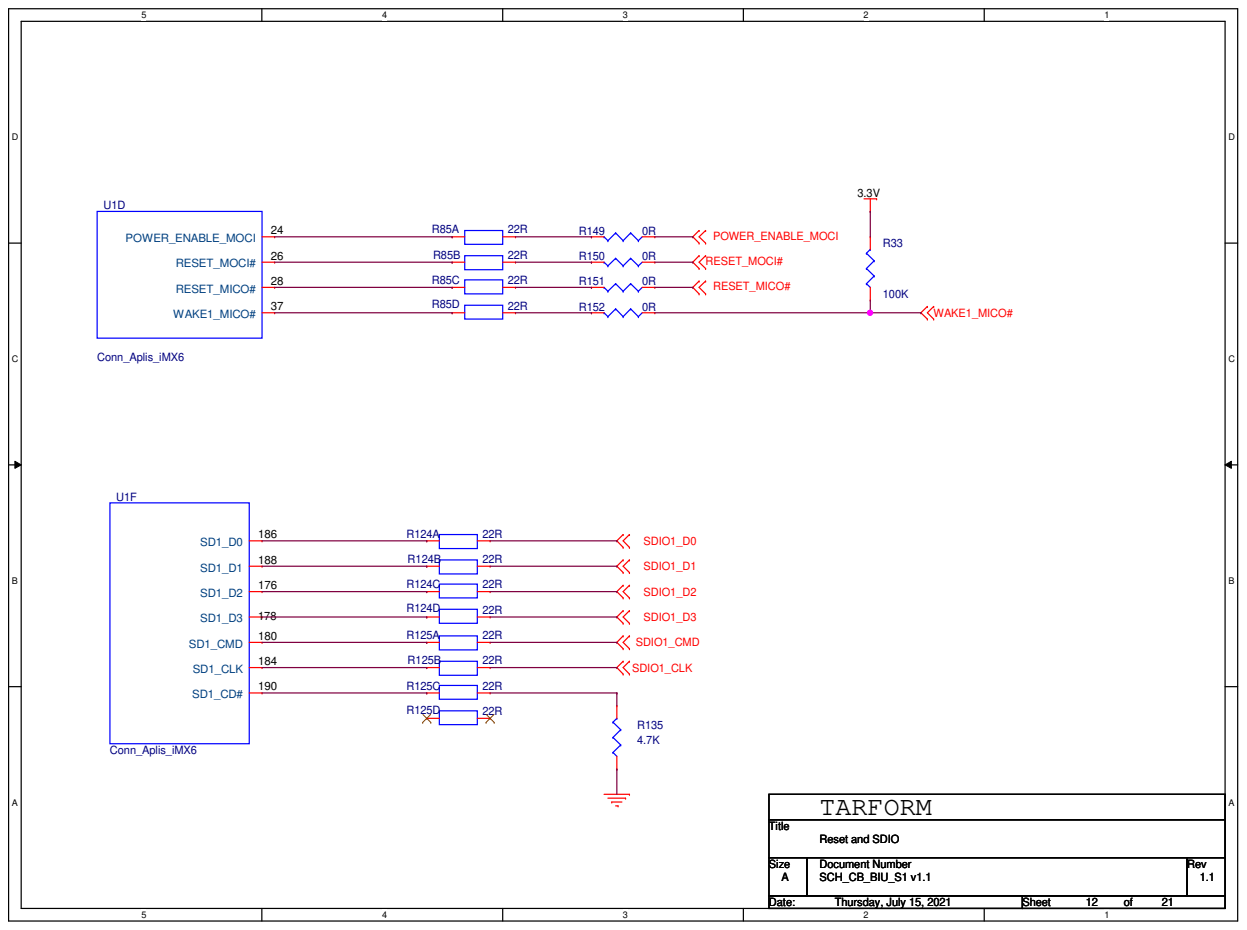
[picture p26: page 12]

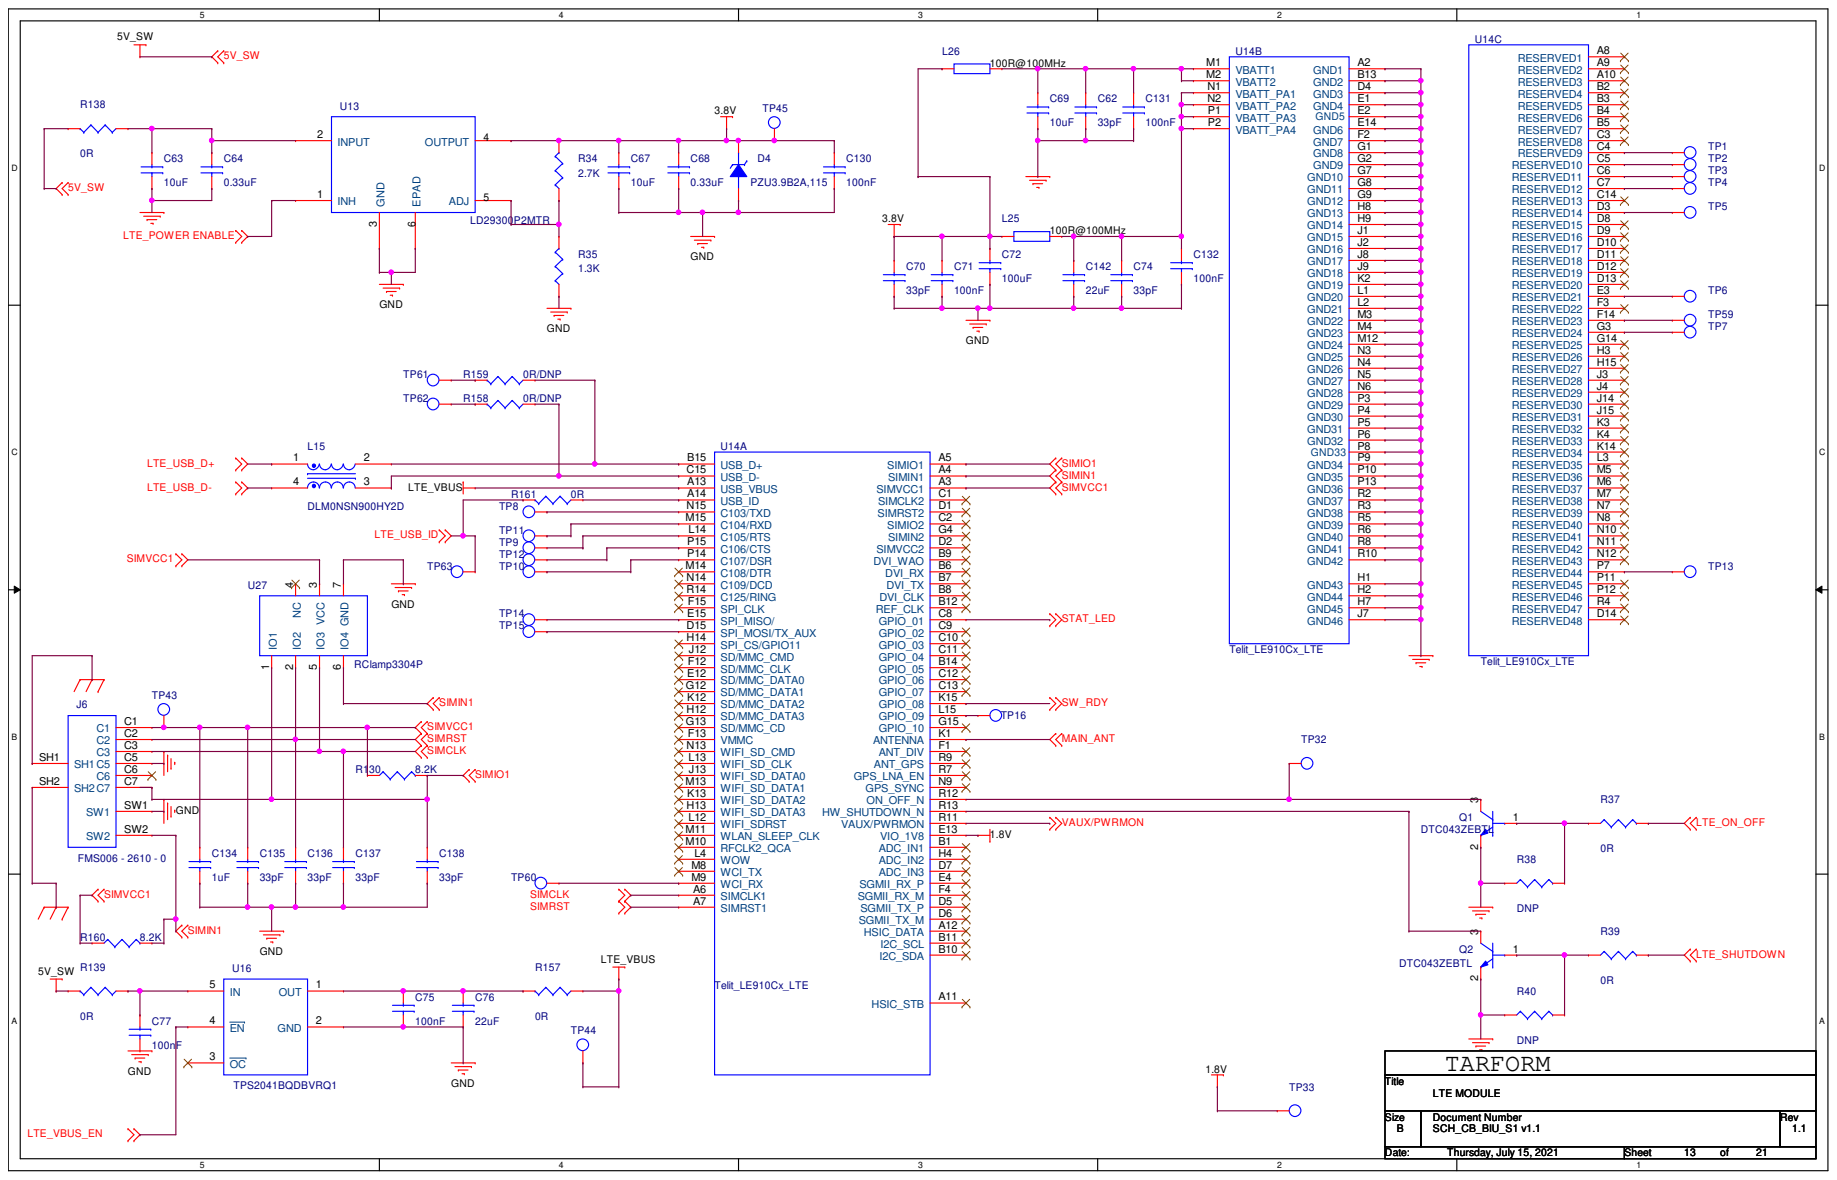
[picture p27: page 13]

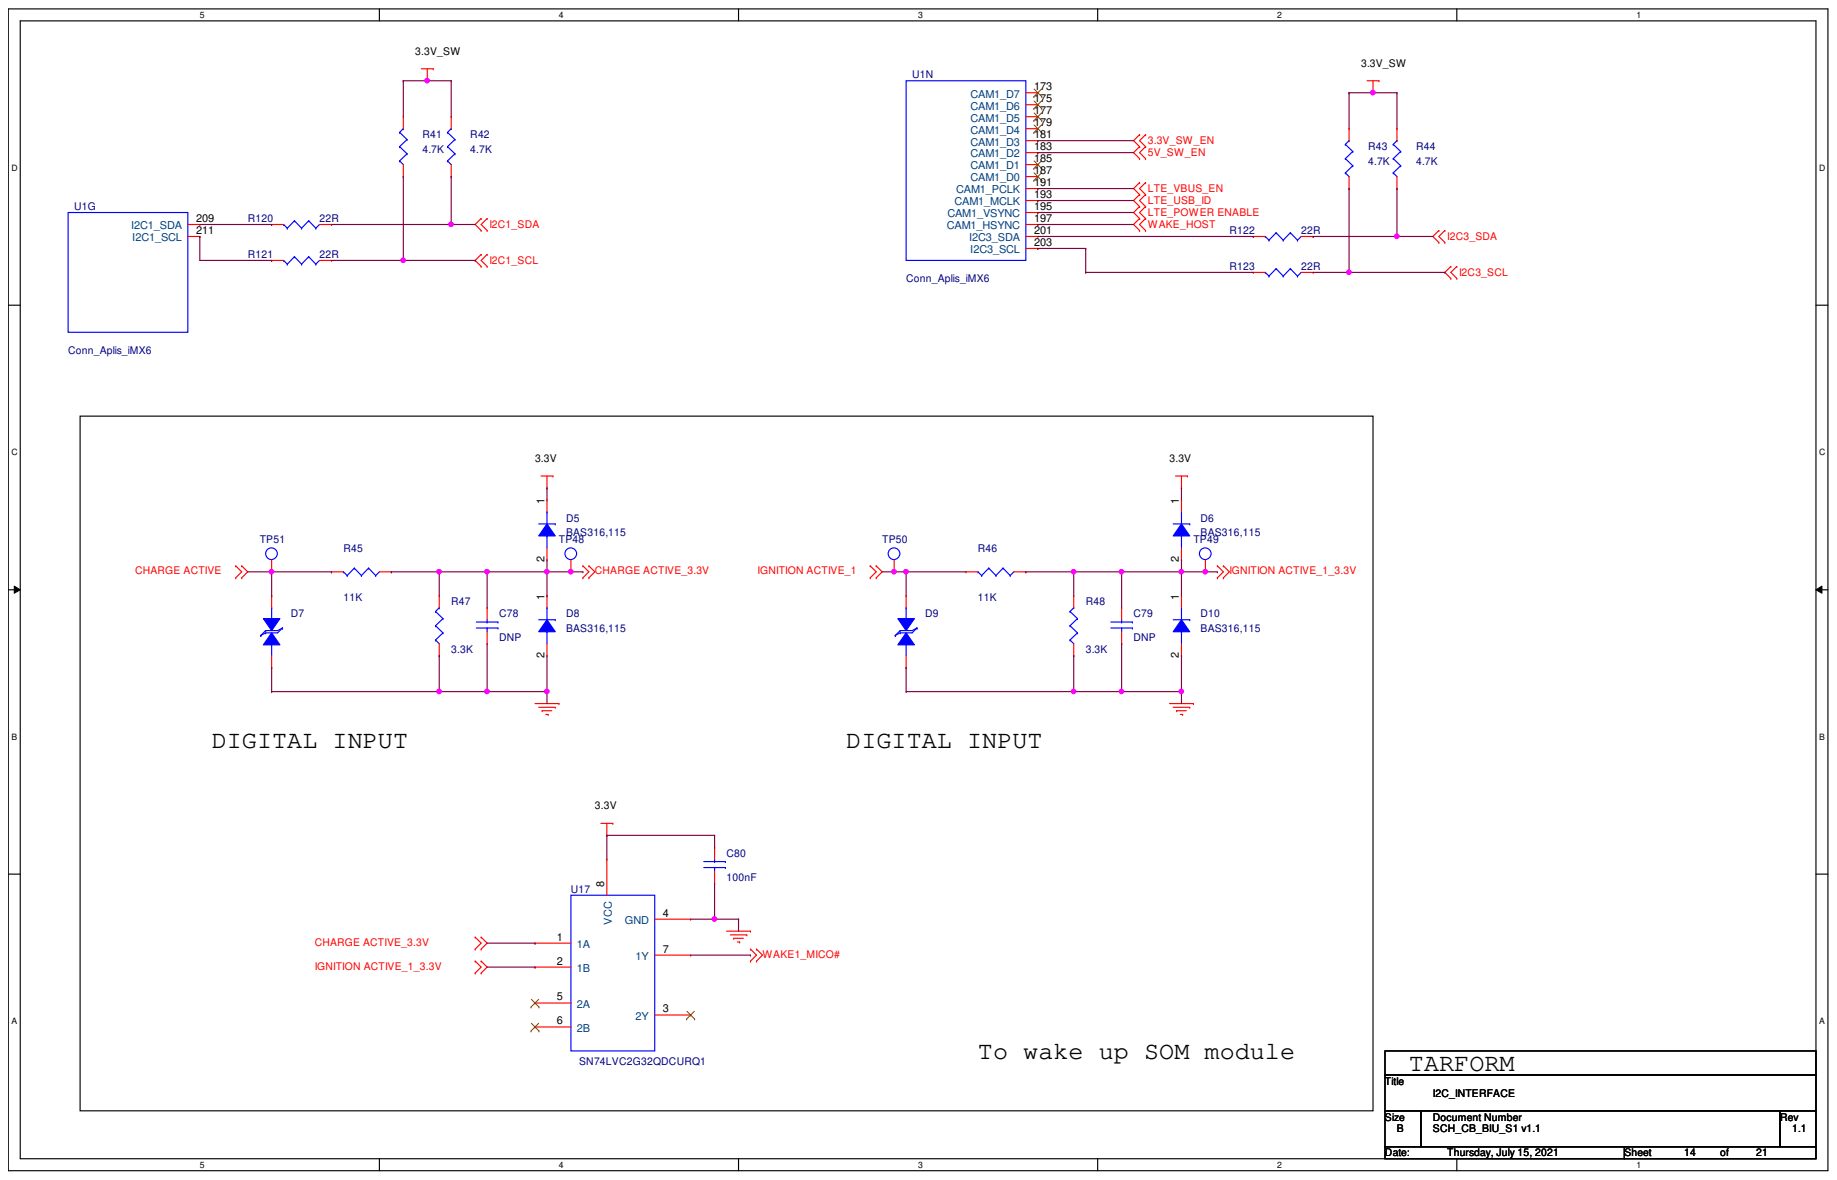
[picture p28: page 14]

## CAN1_EN

## Conn_Aplis_iMX6

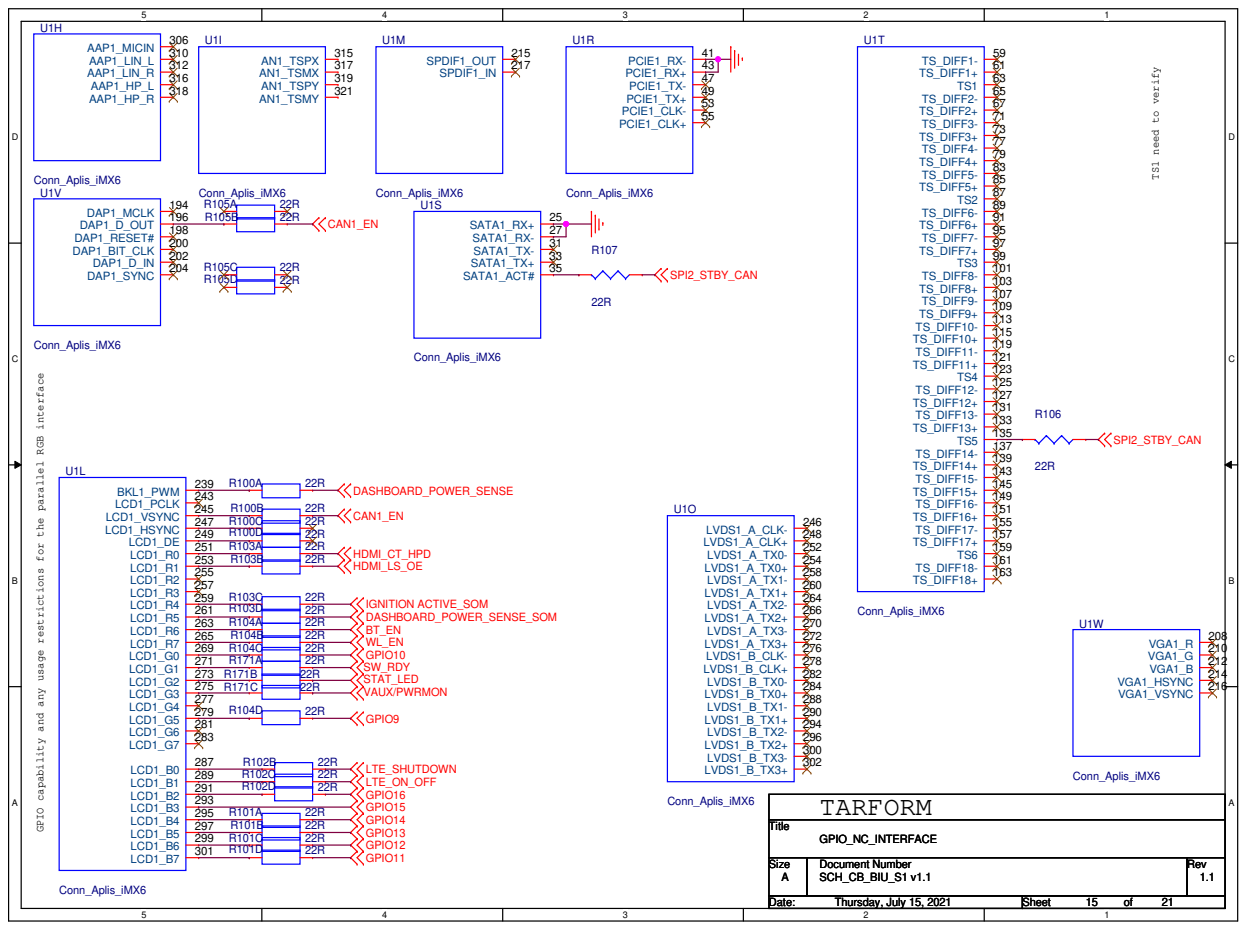
[picture p29: page 15]

GPIO capability and any usage restrictions for the parallel RGB interface

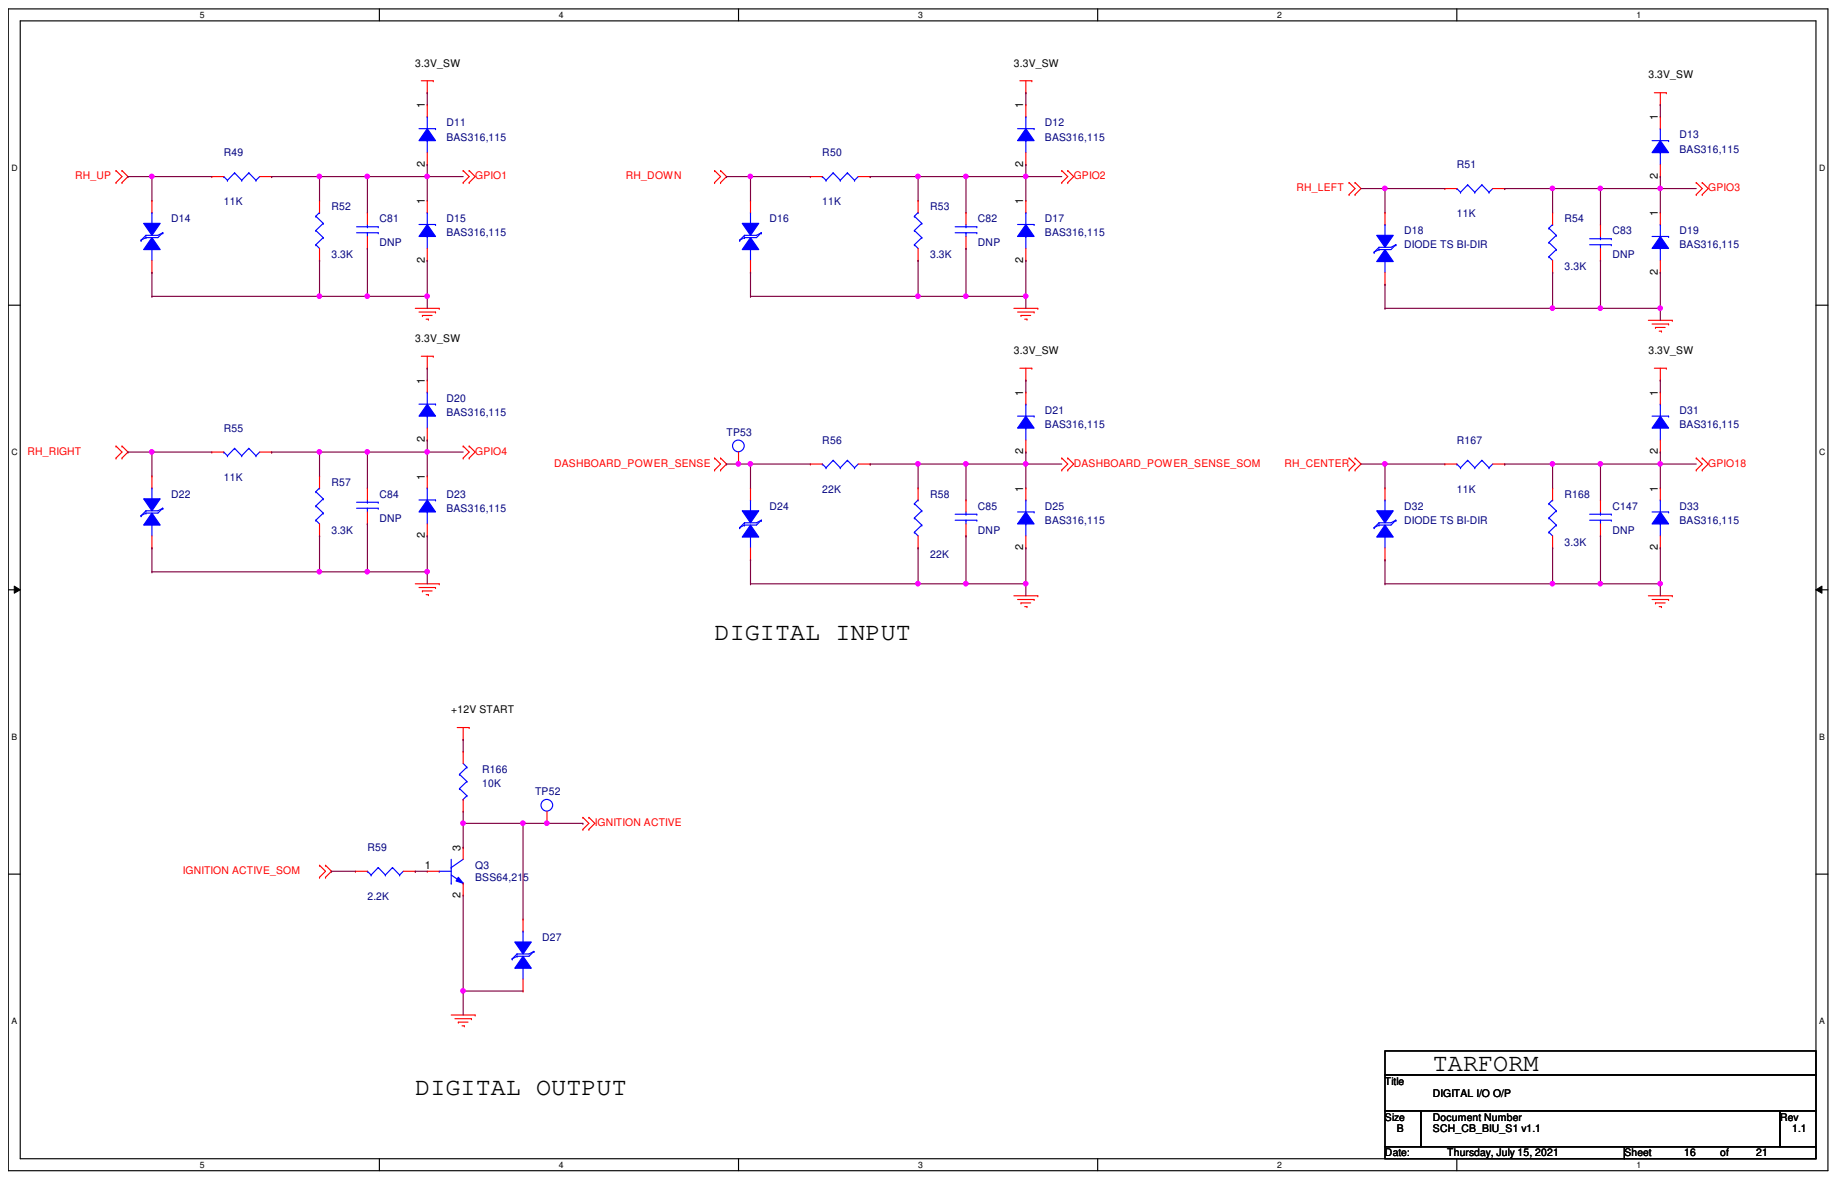
[picture p30: page 16]

DIODE TS BI-DIR

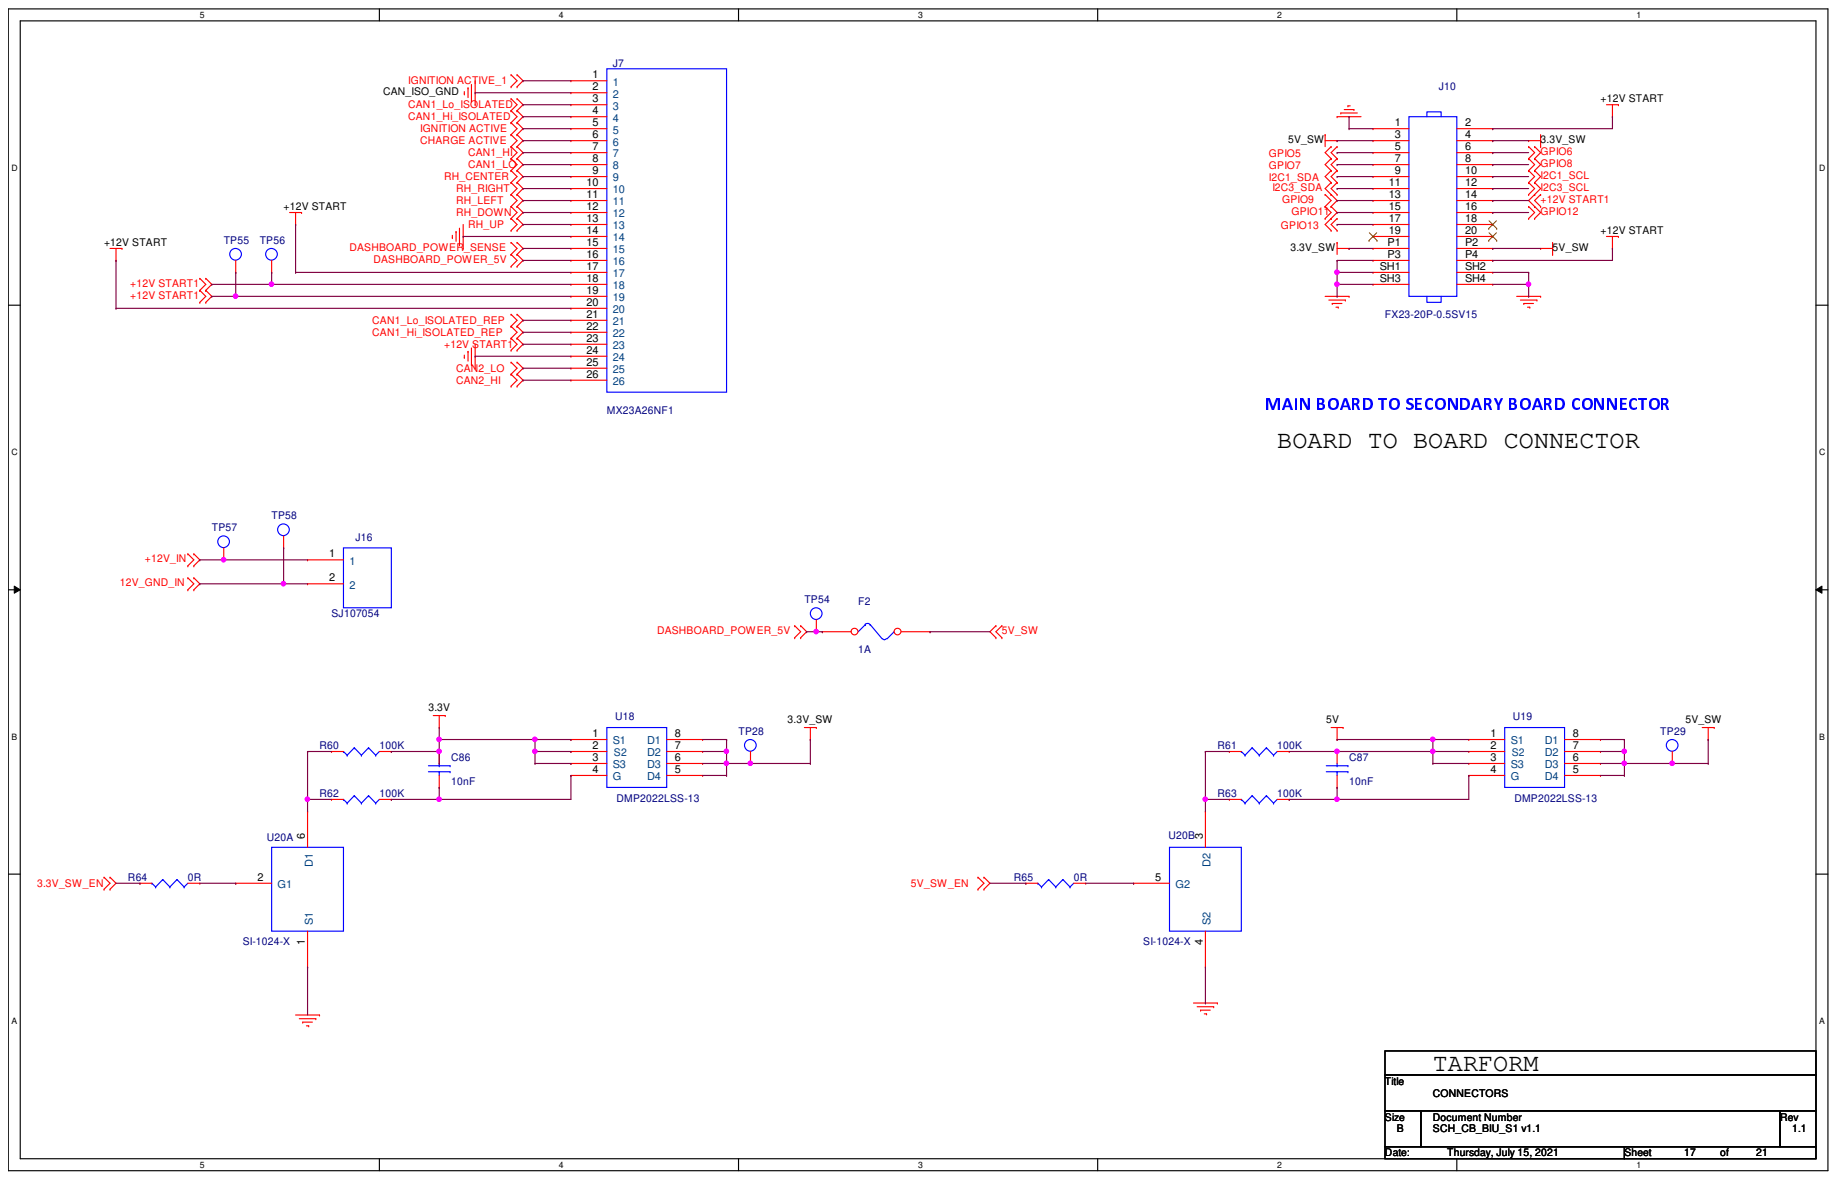
[picture p31: page 17]

BOARD TO BOARD CONNECTOR

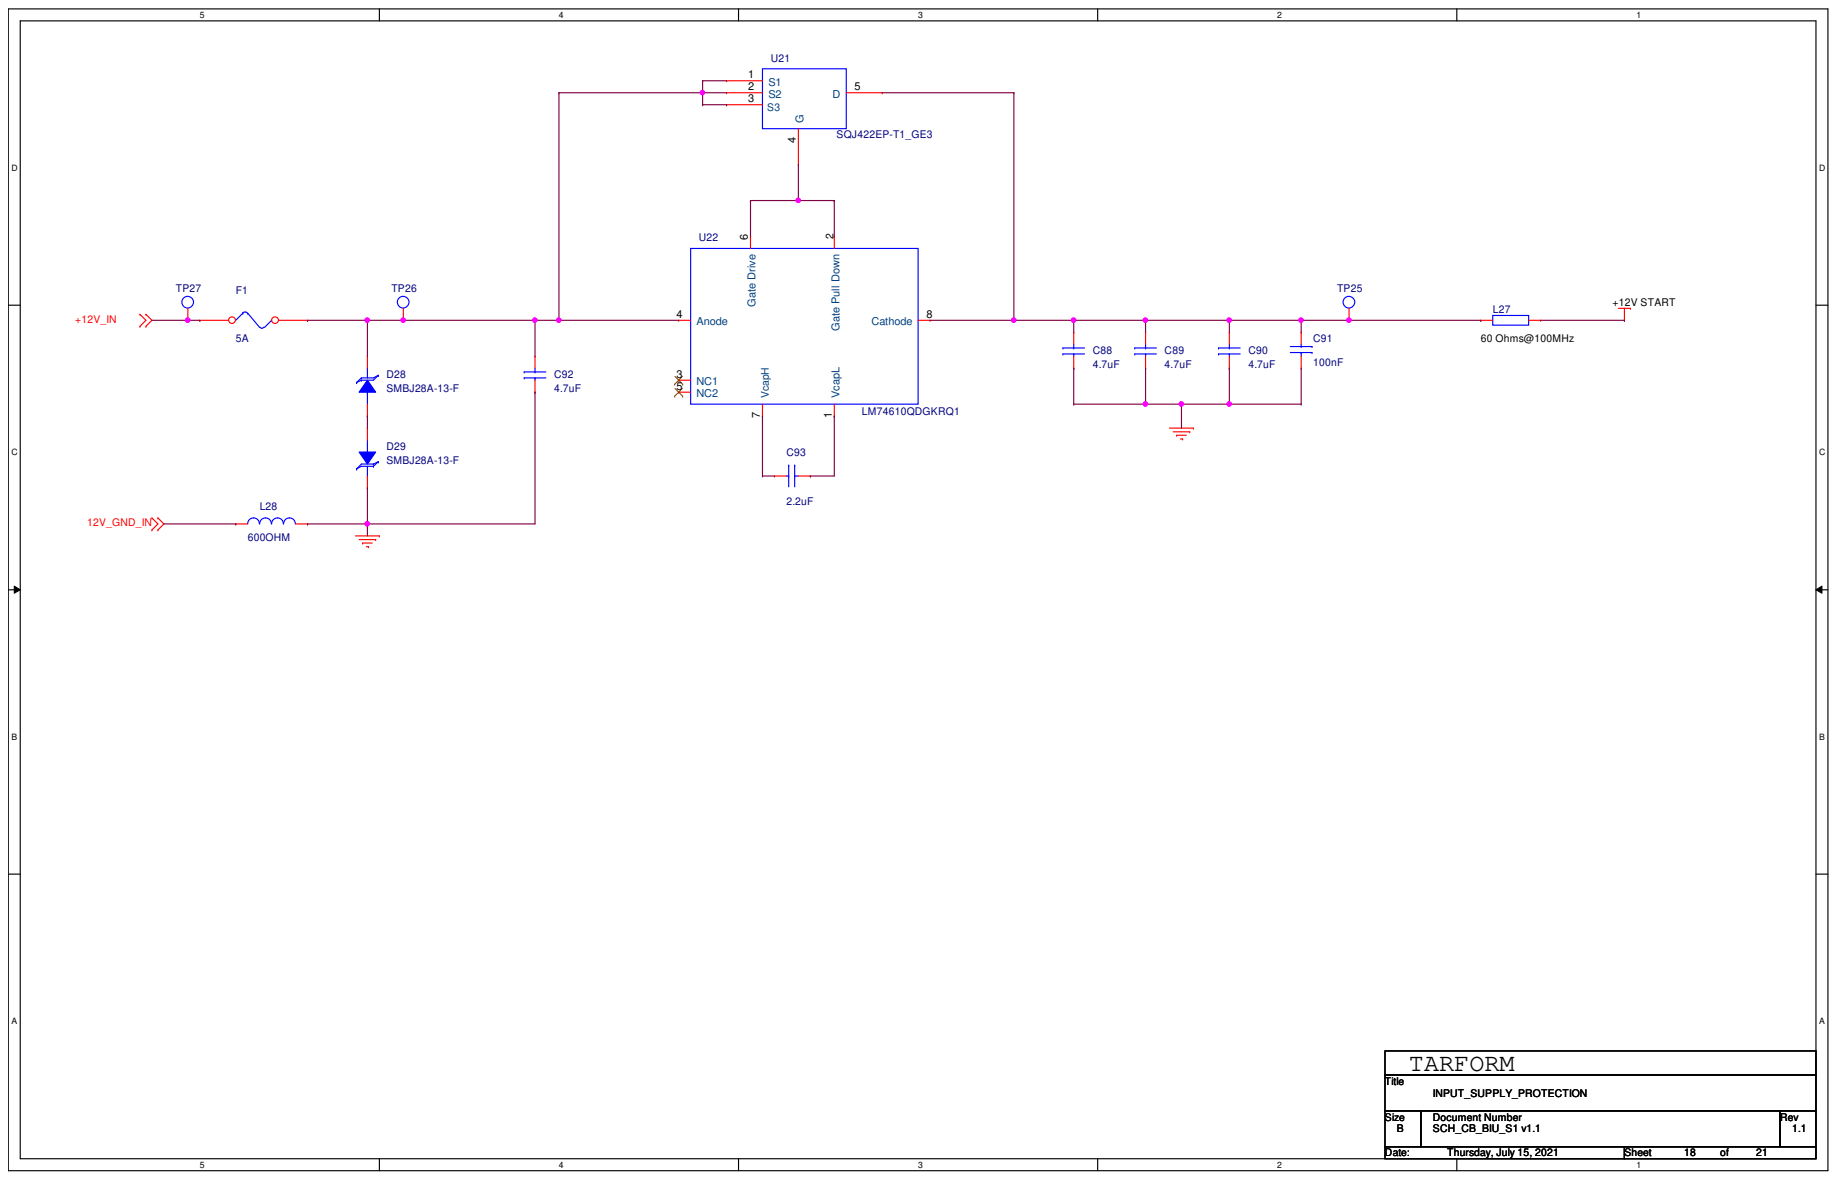
[picture p32: page 18]

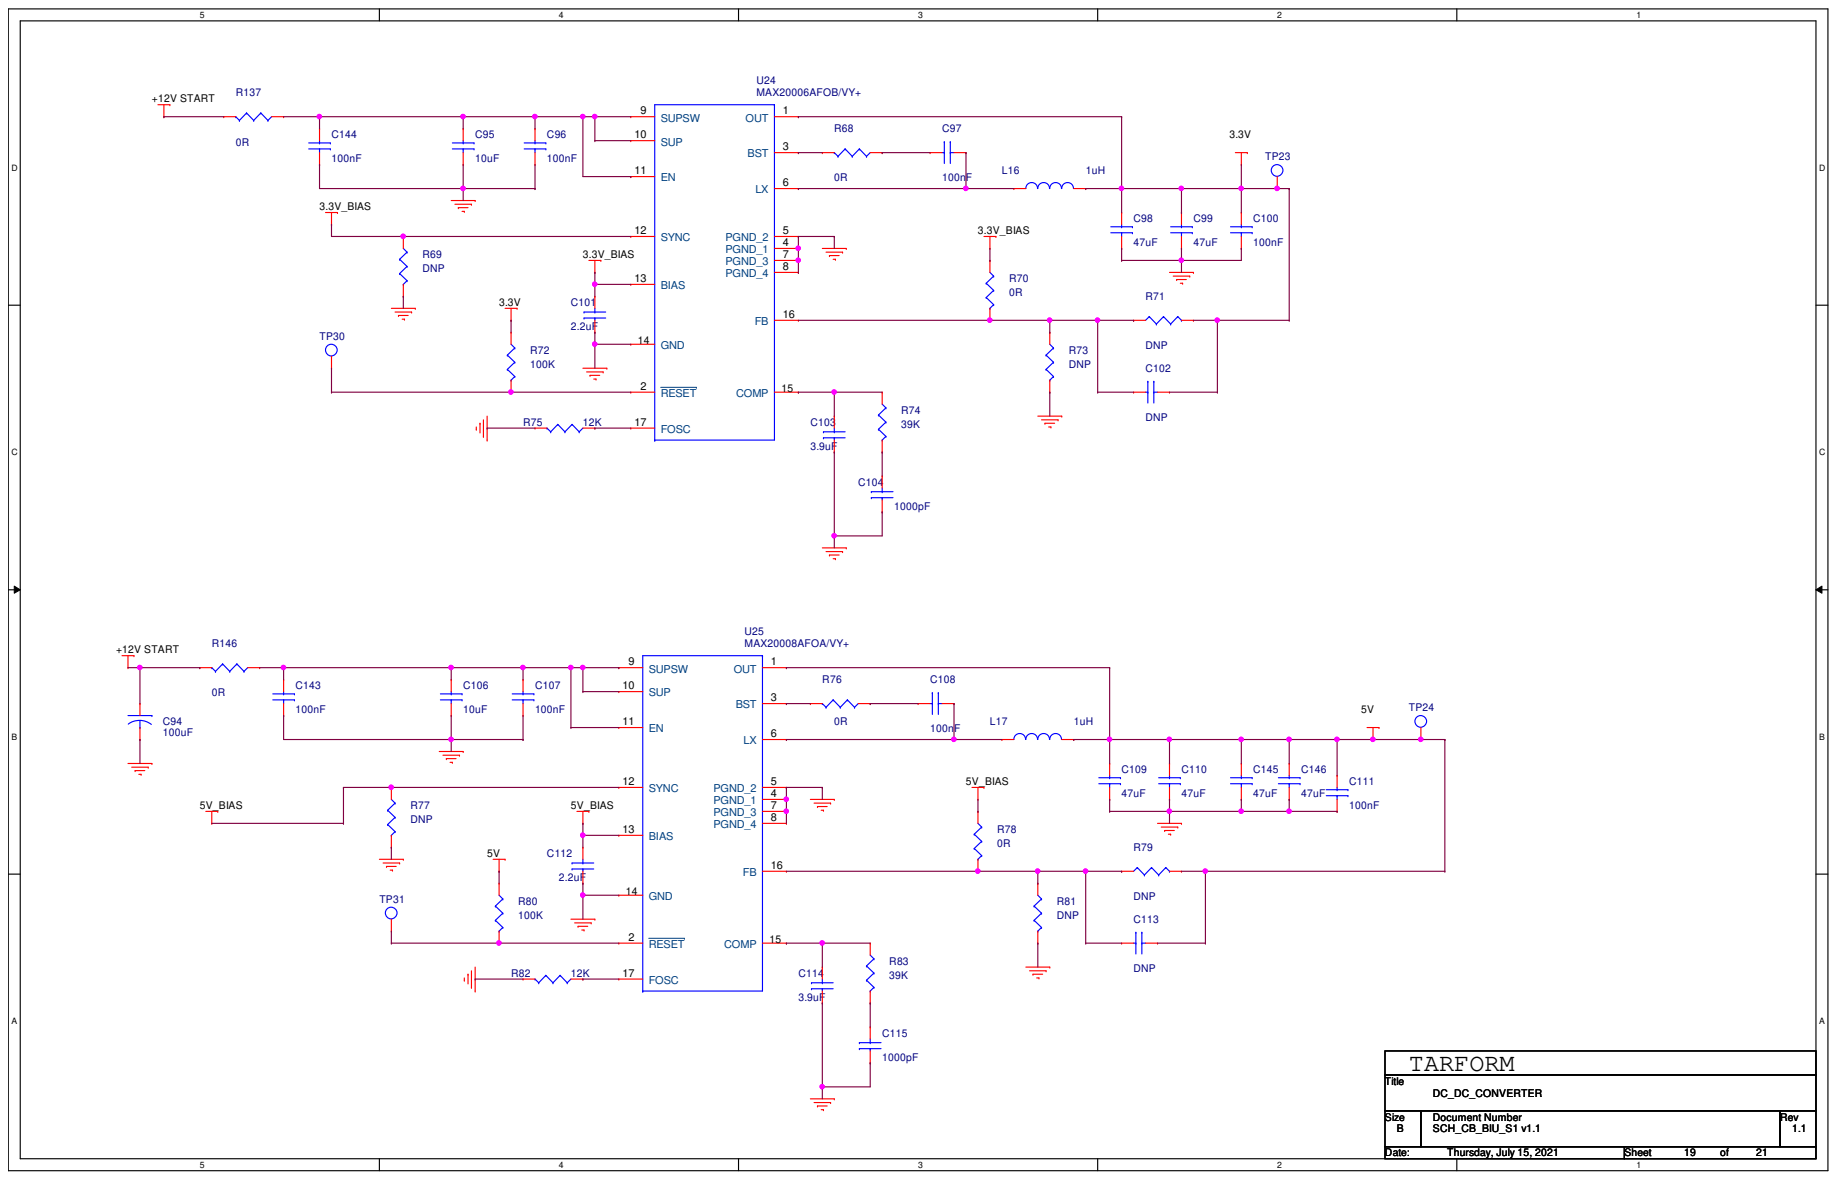
[picture p33: page 19]

C116

1nF

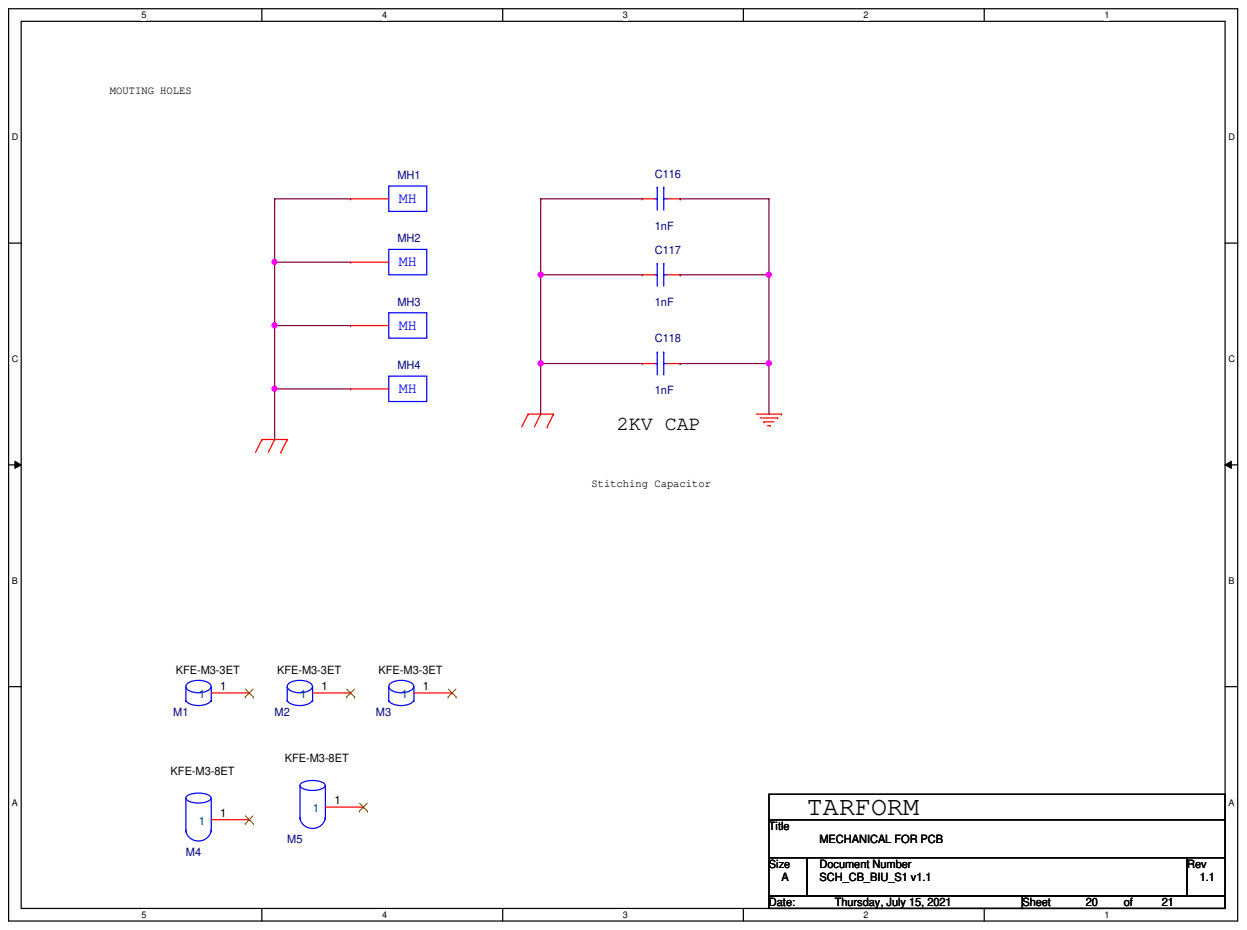
[picture p34: page 20]
MOUTING HOLES; 2KV CAP; TARFORM; Stitching Capacitor; Title; Size; Document Number; Rev; Date:; Sheet; SCH_CB_BIU_S1 v1.1; 21Thursday, July 15, 2021; KFE-M3-3ET; KFE-M3-8ET

MECHANICAL FOR PCB

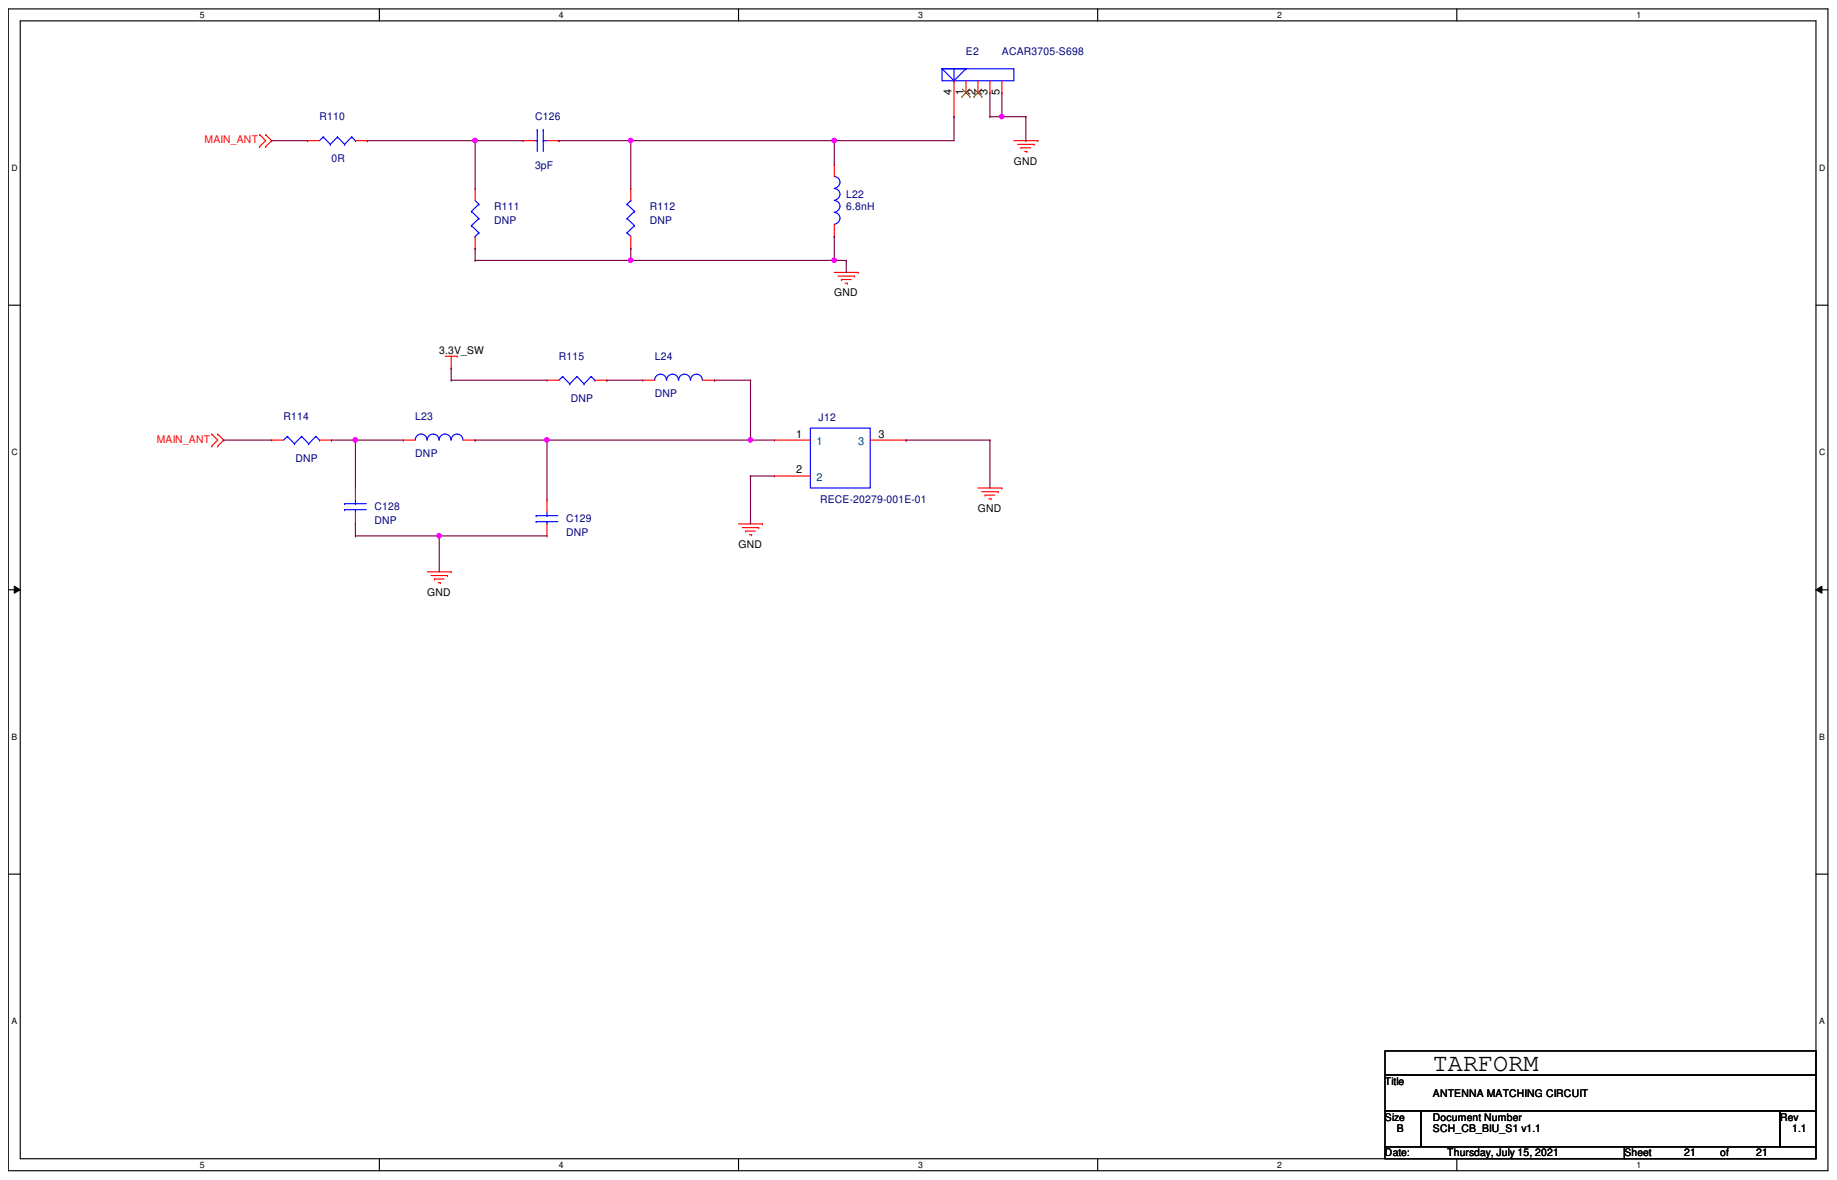
[picture p35: page 21]
