eSpark-Consulting-Group/robertmeares-vcu-bcu/Client-Files/BCU-PCBA-main/BCU-PCBA-main/BCU-PCBA/CARRIER BOARD 2.0/DXF from Tarform/EmbitelAssC_BIUAssA_20210519/EmbitelAssC_BIUAssA_20210519.PDF

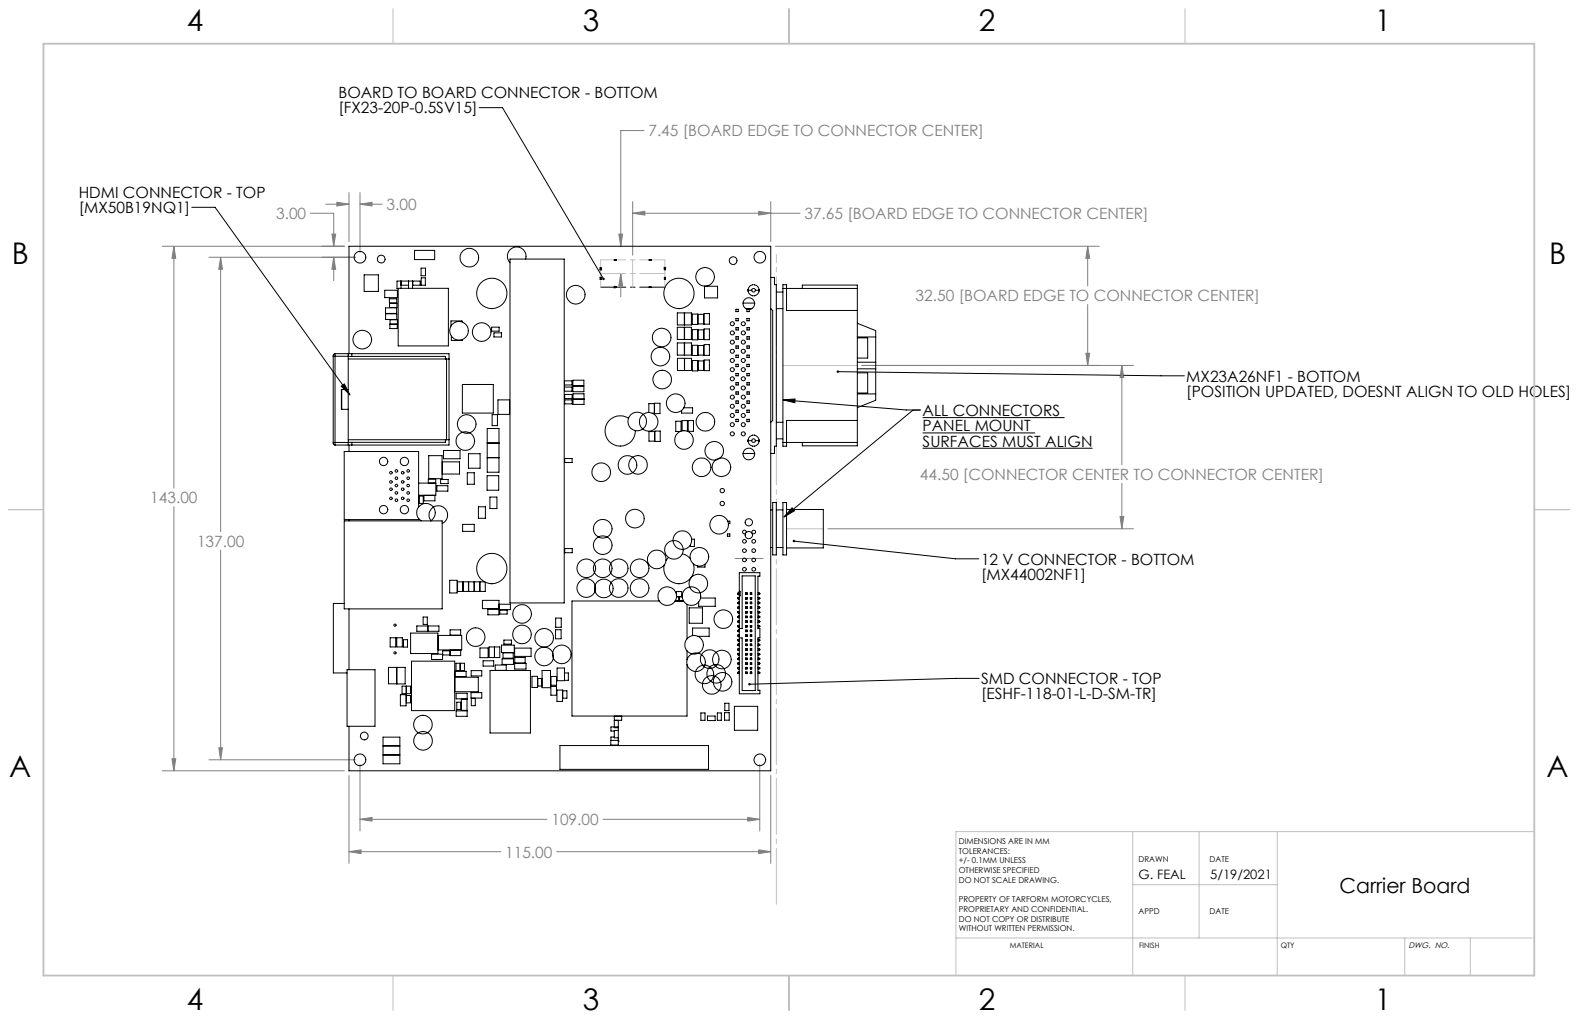
[picture p36: page 1]
12 V CONNECTOR - BOTTOM

BOARD TO BOARD CONNECTOR - BOTTOM

7.45 [BOARD EDGE TO CONNECTOR CENTER]

HDMI CONNECTOR - TOP

37.65 [BOARD EDGE TO CONNECTOR CENTER]

32.50 [BOARD EDGE TO CONNECTOR CENTER]

MX23A26NF1 - BOTTOM
[POSITION UPDATED, DOESNT ALIGN TO OLD HOLES]

ALL CONNECTORS
PANEL MOUNT
SURFACES MUST ALIGN
44.50 [CONNECTOR CENTER TO CONNECTOR CENTER]

SMD CONNECTOR - TOP
[ESHF-118-01-L-D-SM-TR]

DIMENSIONS ARE IN MM TOLERANCES: +/- 0.1MM UNLESS OTHERWISE SPECIFIED DO NOT SCALE DRAWING. PROPERTY OF TARFORM MOTORCYCLES, PROPRIETARY AND CONFIDENTIAL. DO NOT COPY OR DISTRIBUTE WITHOUT WRITTEN PERMISSION. | DRAWN | DATE 5/19/2021 | Carrier Board G. FEAL

APPD | DATE

MATERIAL | FINISH | QTY | DWG. NO.

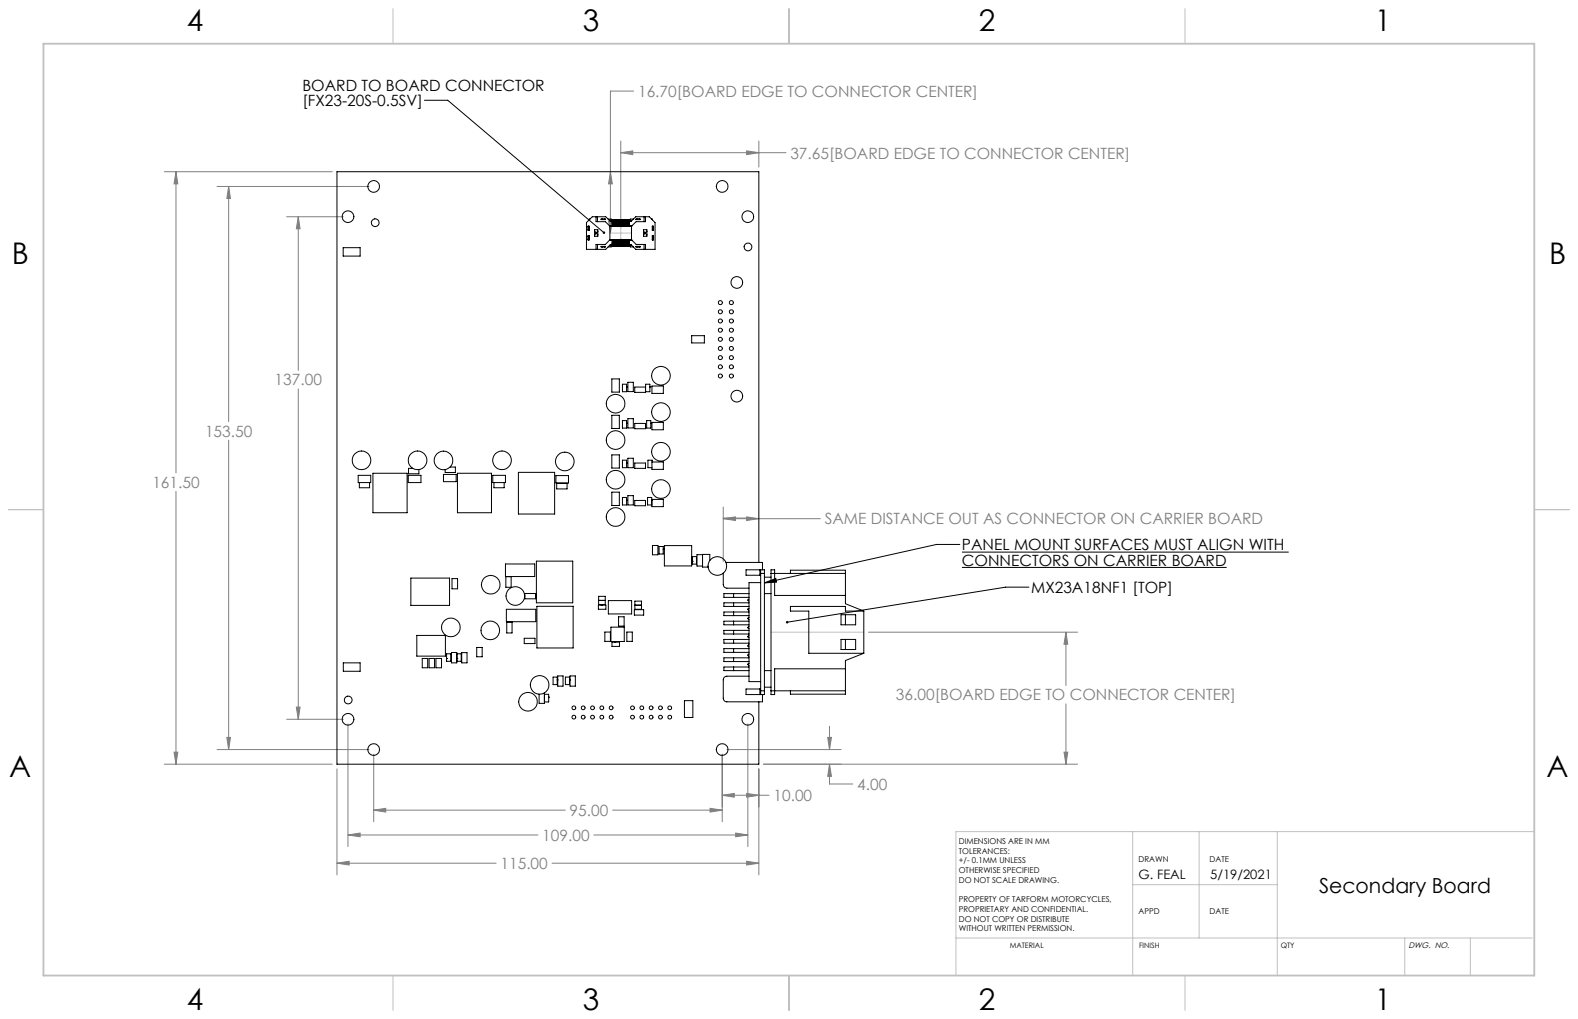
[picture p37: page 2]
MX23A18NF1 [TOP]

16.70[BOARD EDGE TO CONNECTOR CENTER] BOARD TO BOARD CONNECTOR

37.65[BOARD EDGE TO CONNECTOR CENTER]

SAME DISTANCE OUT AS CONNECTOR ON CARRIER BOARD

PANEL MOUNT SURFACES MUST ALIGN WITH
CONNECTORS ON CARRIER BOARD

36.00[BOARD EDGE TO CONNECTOR CENTER]

DIMENSIONS ARE IN MM TOLERANCES: +/- 0.1MM UNLESS OTHERWISE SPECIFIED DO NOT SCALE DRAWING. PROPERTY OF TARFORM MOTORCYCLES, PROPRIETARY AND CONFIDENTIAL. DO NOT COPY OR DISTRIBUTE WITHOUT WRITTEN PERMISSION. | DRAWN | DATE 5/19/2021 | Secondary Board G. FEAL

APPD | DATE

MATERIAL | FINISH | QTY | DWG. NO.
