eSpark-Consulting-Group/robertmeares-vcu-bcu/Client-Files/BCU-PCBA-main/BCU-PCBA-main/BCU-PCBA/SECONDARY BOARD V2.1/GERBER/EMBL51745_PCB_SB_V2.1_PLC_20210914/ASSEMBLY.pdf

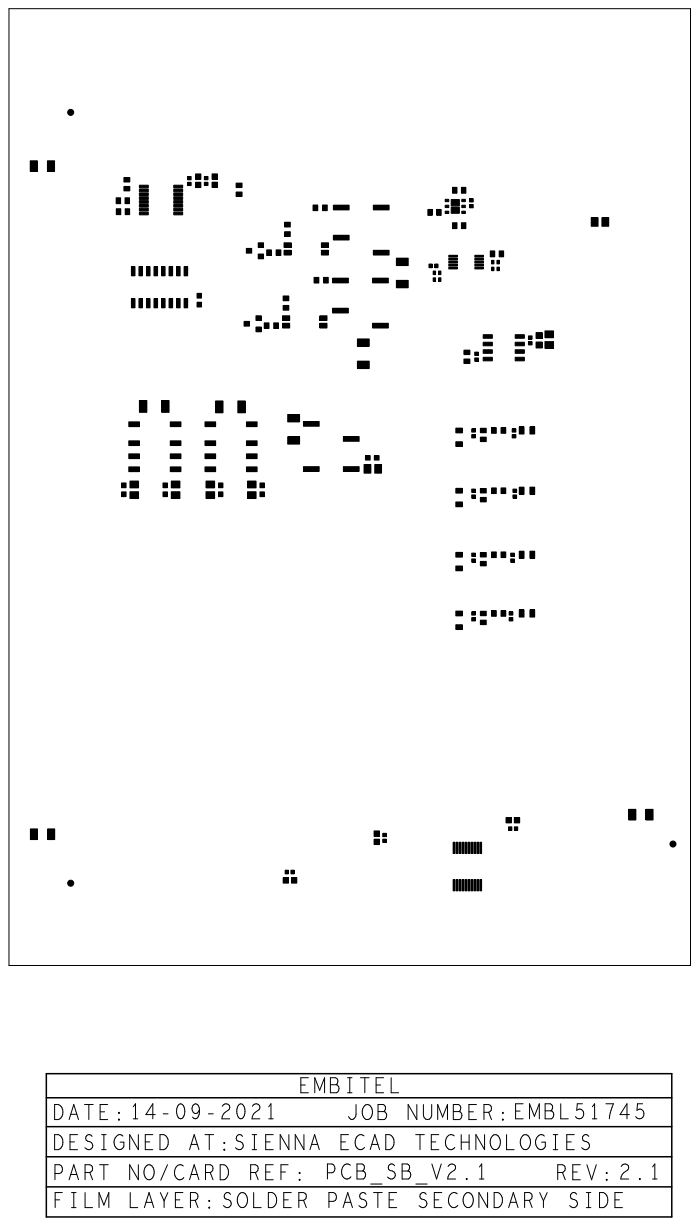
[picture p38: page 1]

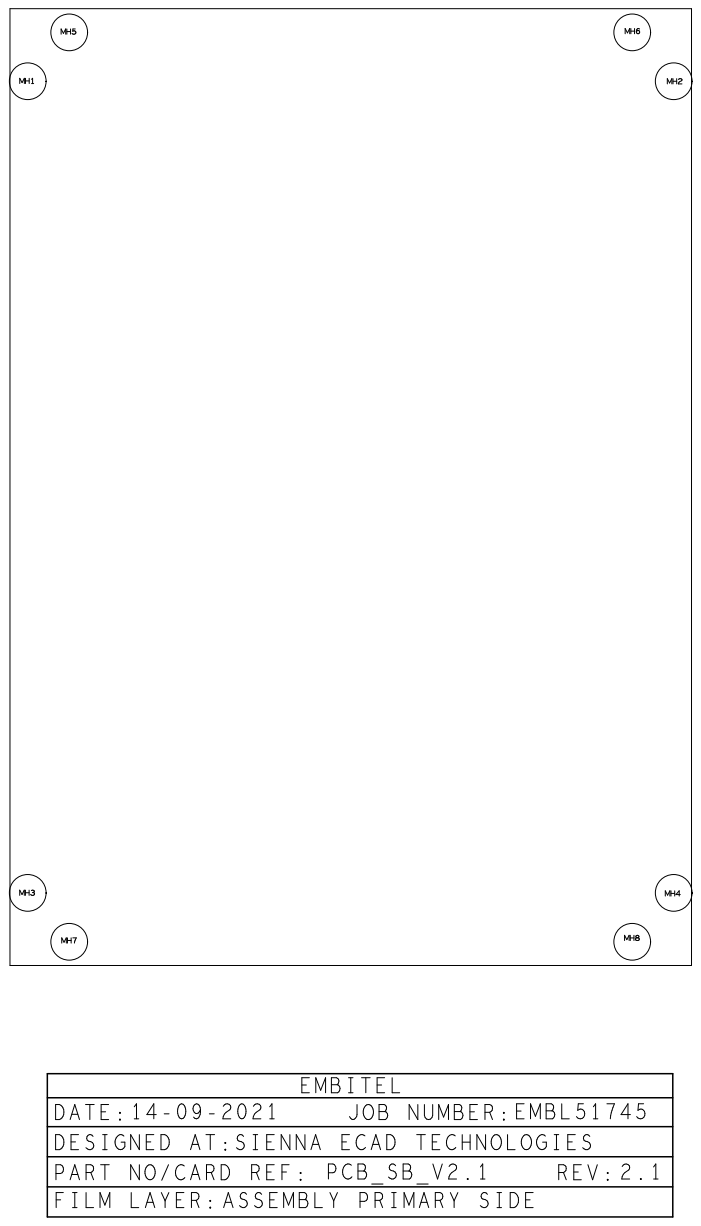
[picture p39: page 2]

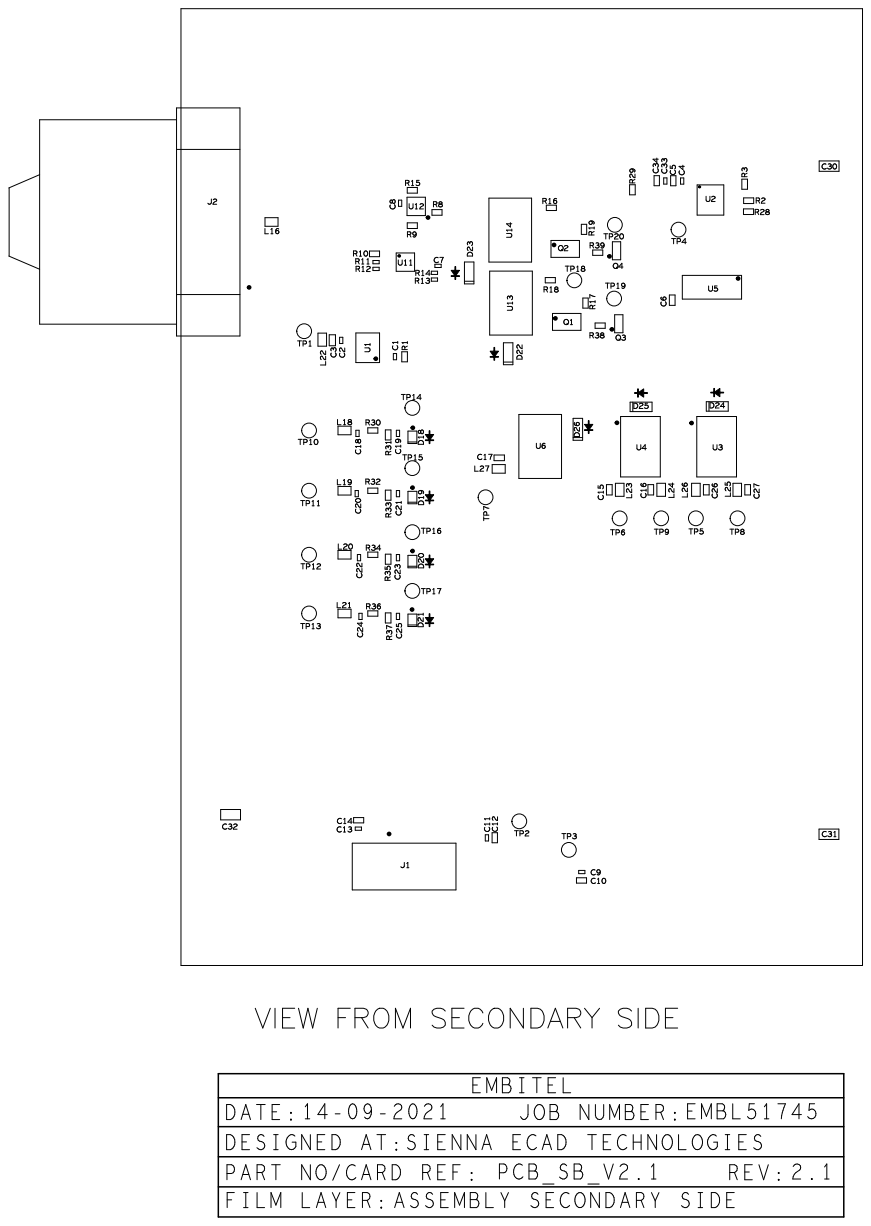
[picture p40: page 3]
