eSpark-Consulting-Group/robertmeares-vcu-bcu/Client-Files/BCU-PCBA-main/BCU-PCBA-main/BCU-PCBA/CARRIER BOARD 2.0/GERBER/EMBL51745_PCB_CB_V2.0_DFM_202100719/FAB.pdf

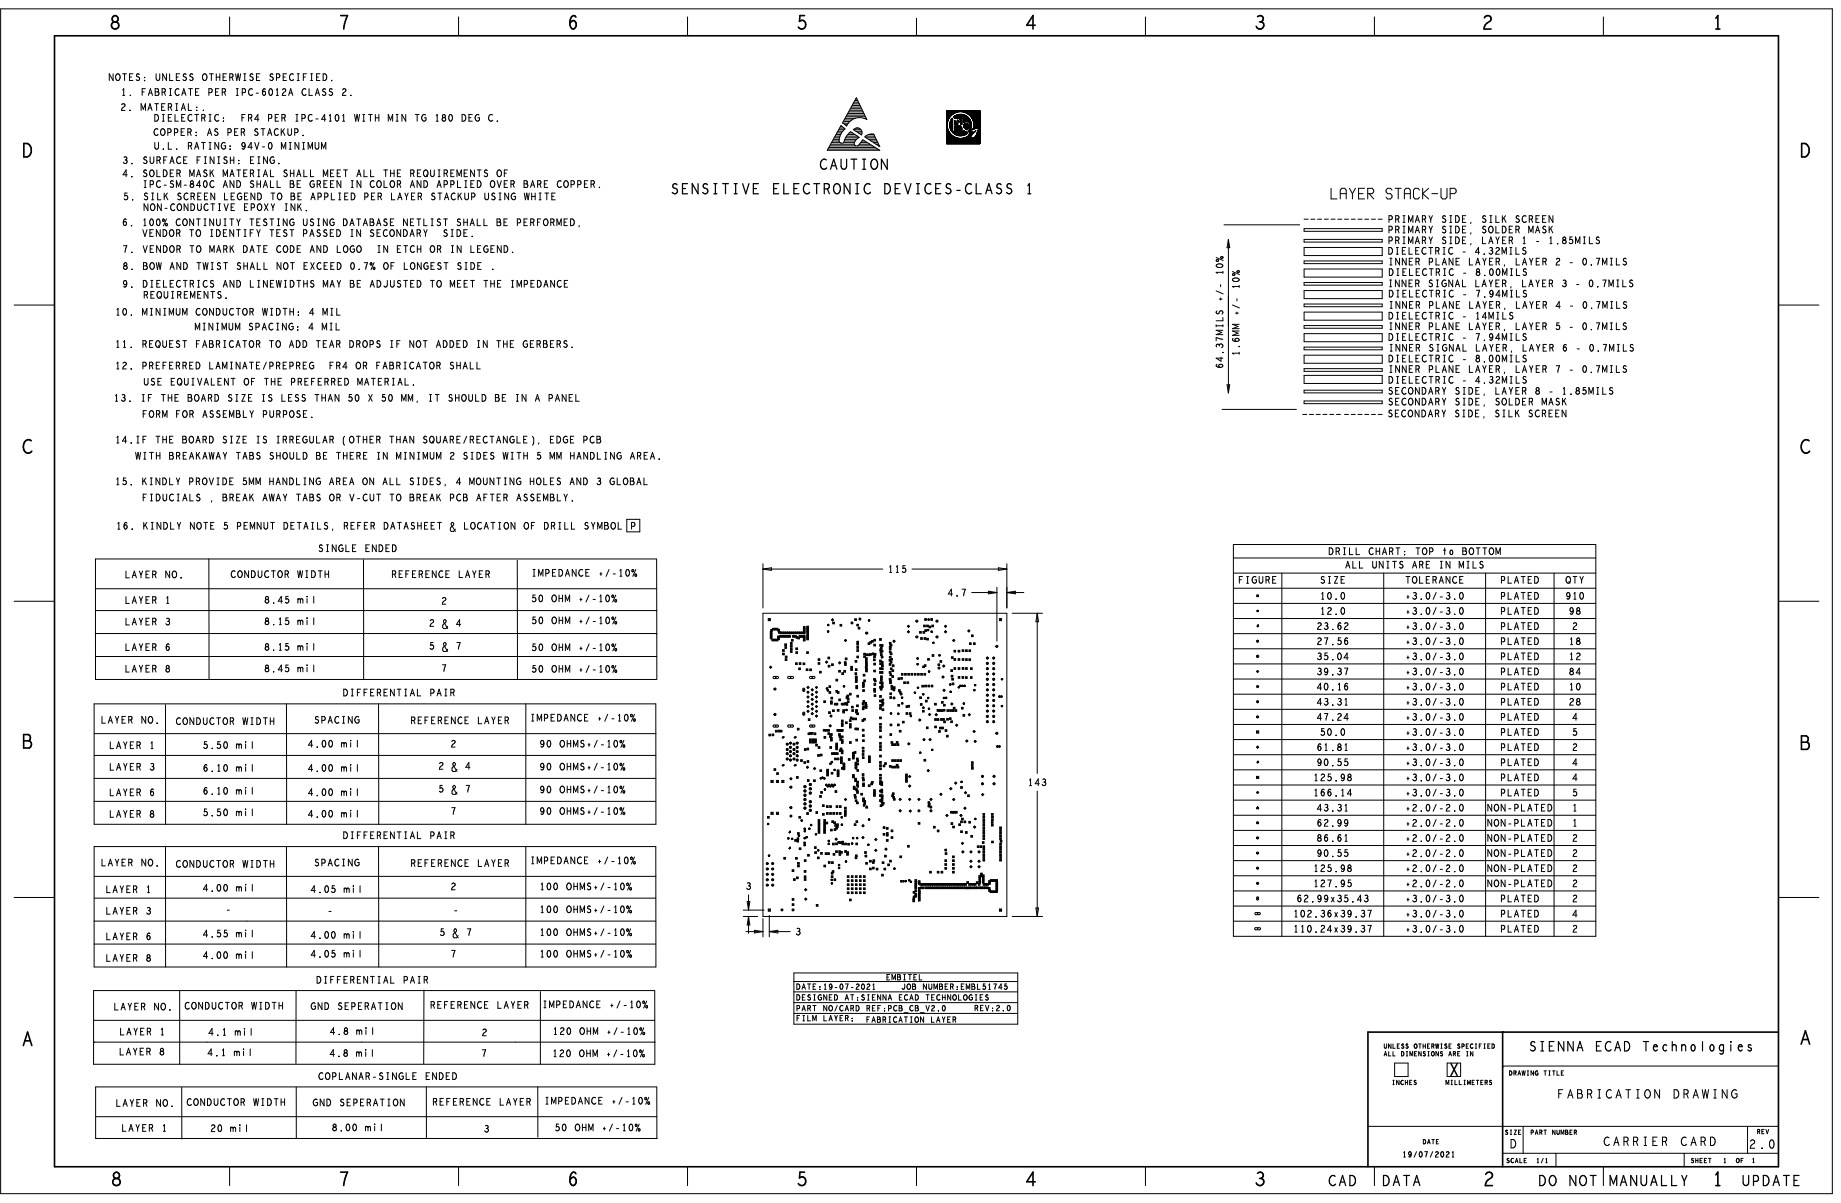
[picture p41: page 1]
