eSpark-Consulting-Group/robertmeares-vcu-bcu/Client-Files/BCU-PCBA-main/BCU-PCBA-main/BCU-PCBA/CARRIER BOARD 2.0/GERBER/EMBL51745_PCB_CB_V2.0_DFM_202100719/LAYERS.pdf

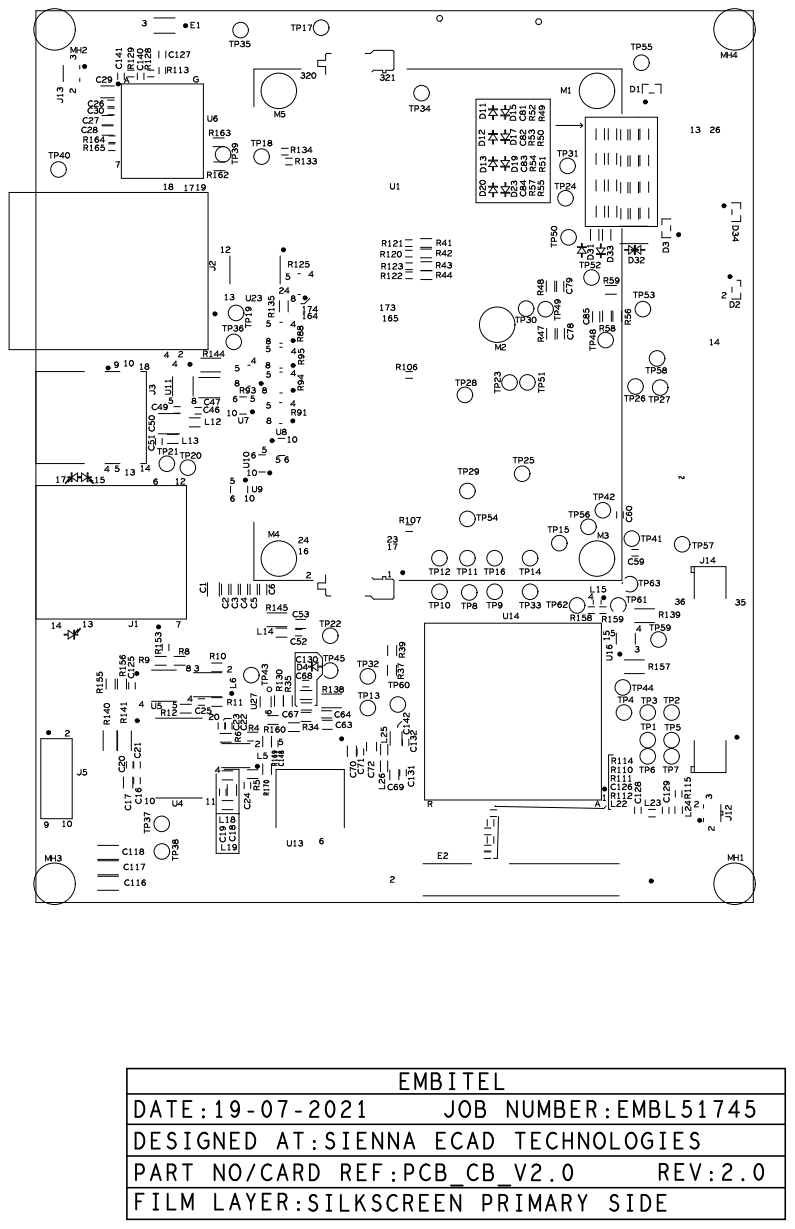
[picture p42: page 1]

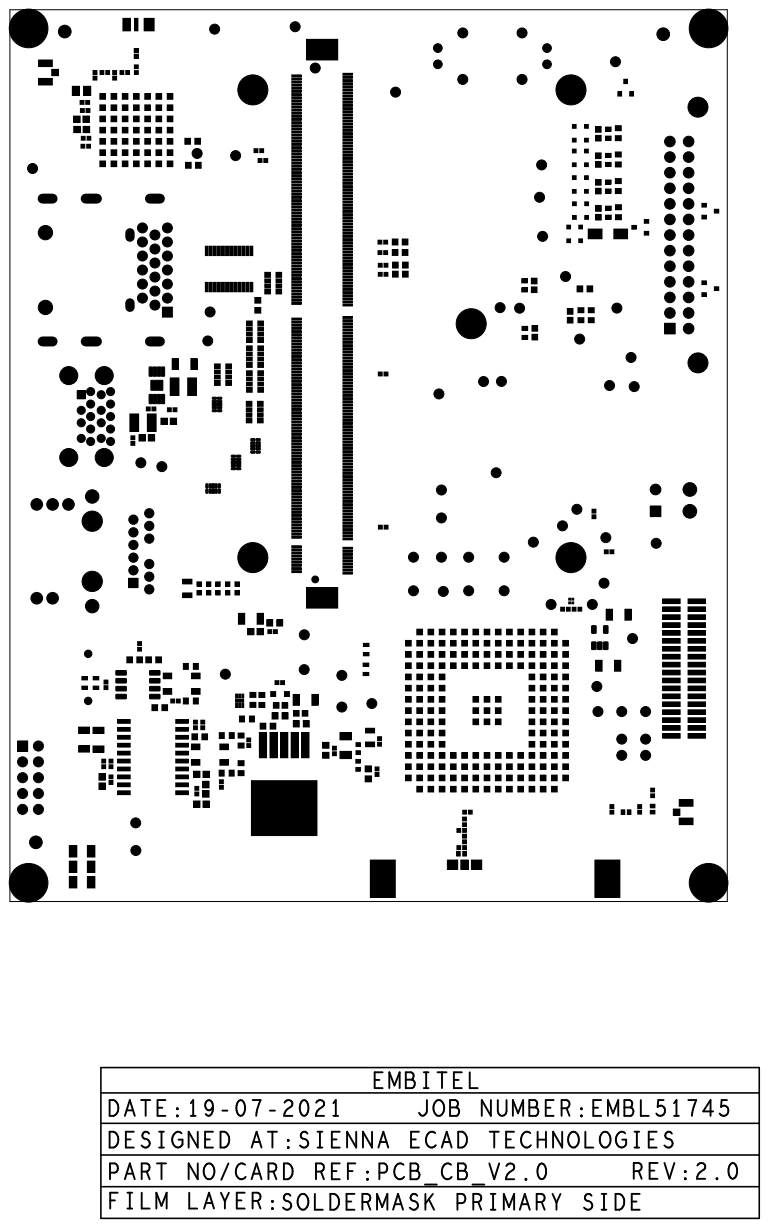
[picture p43: page 2]

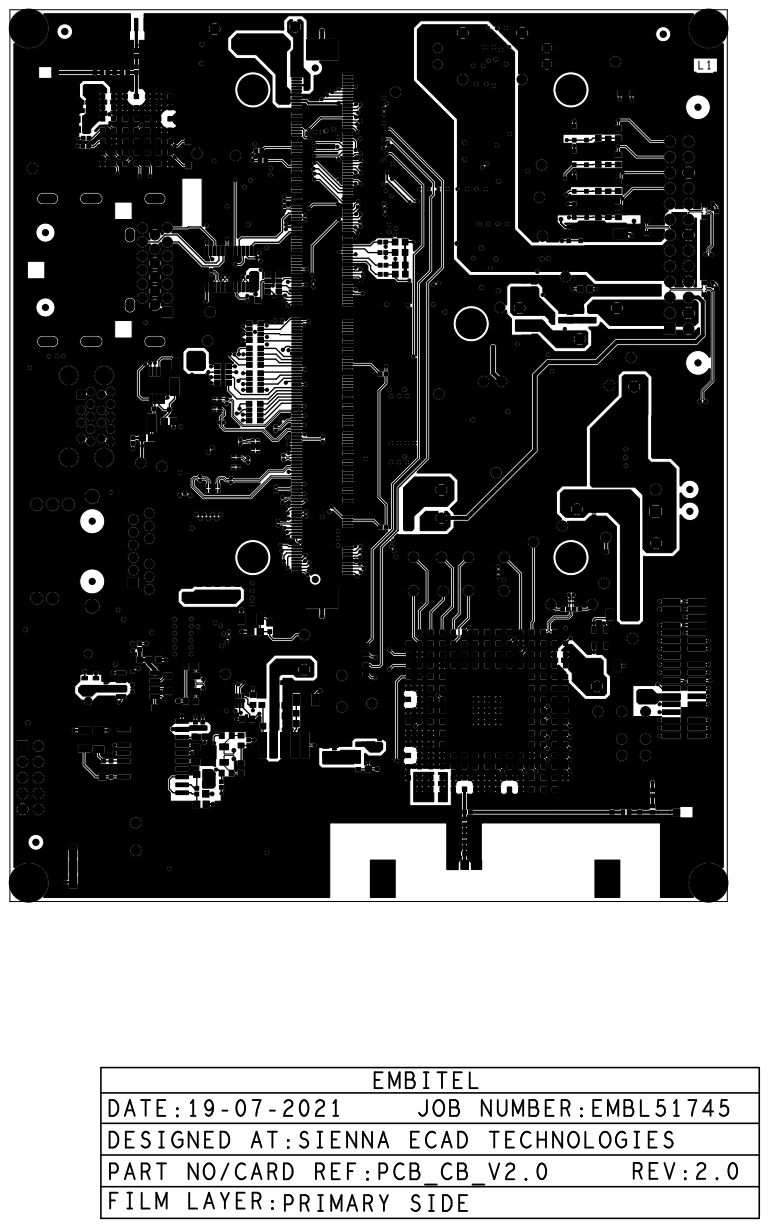
[picture p44: page 3]

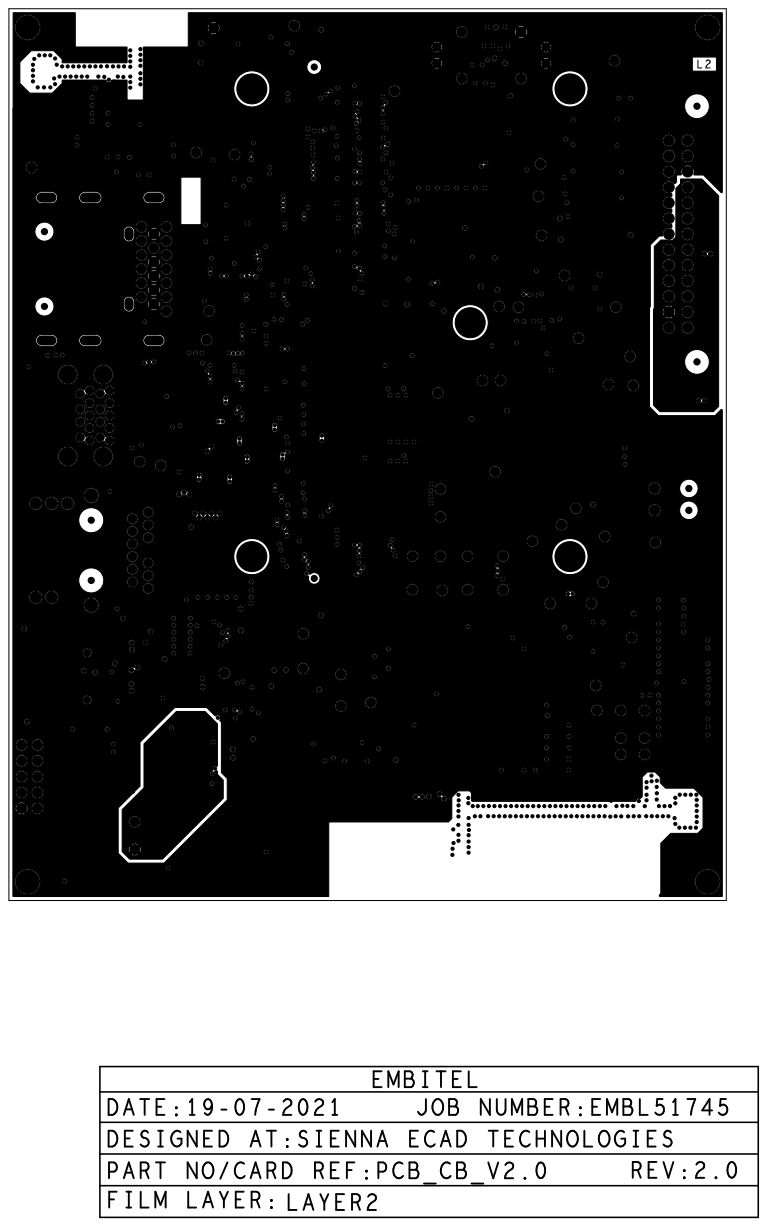
[picture p45: page 4]

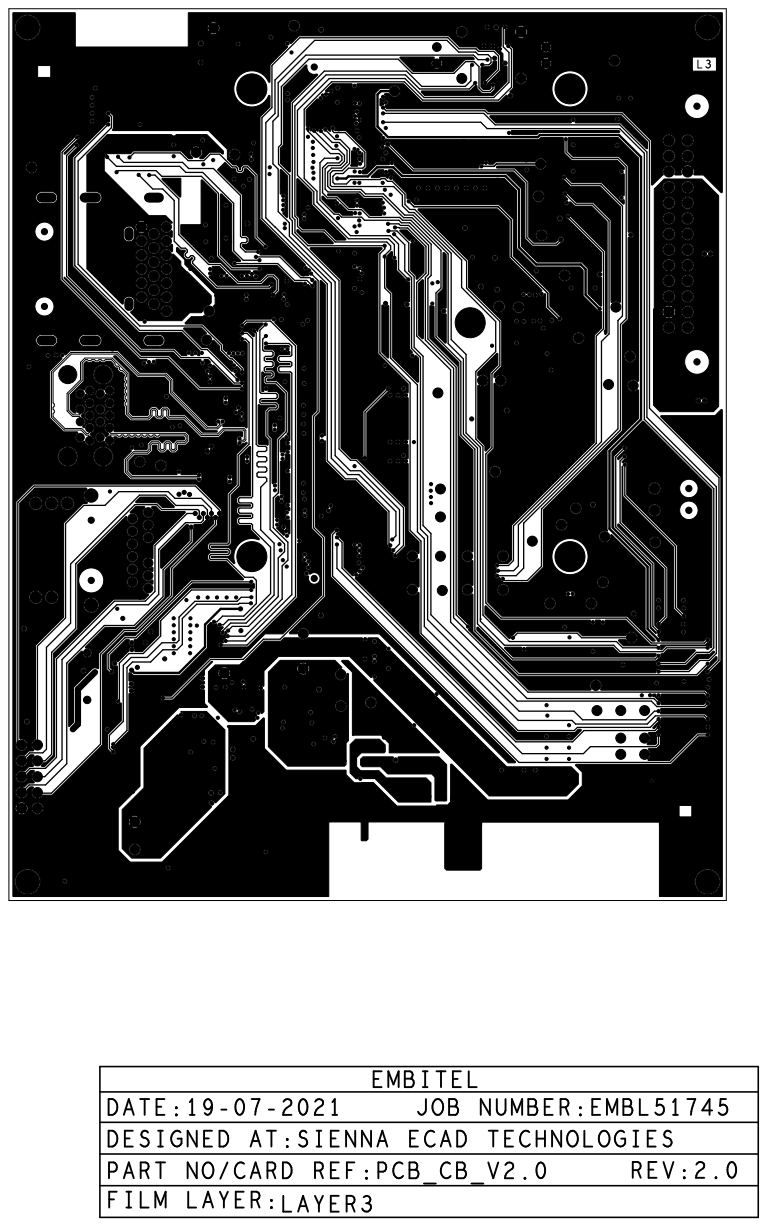
[picture p46: page 5]

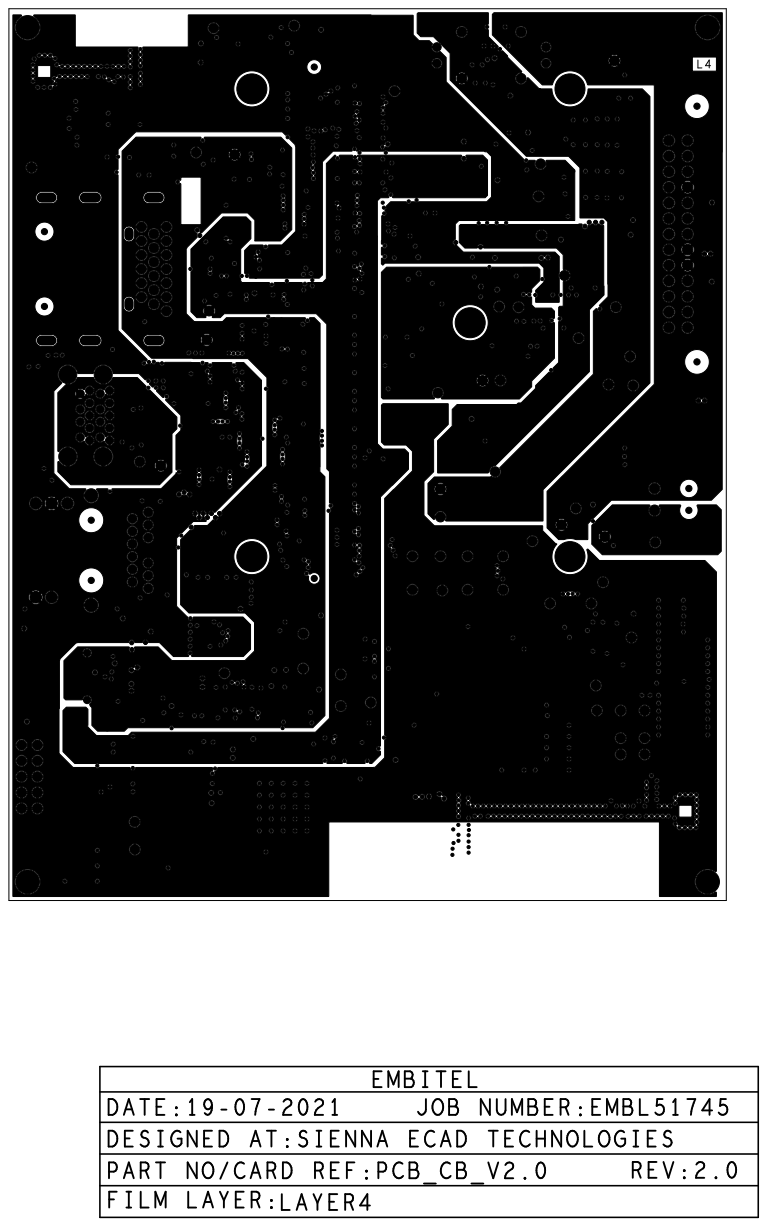
[picture p47: page 6]

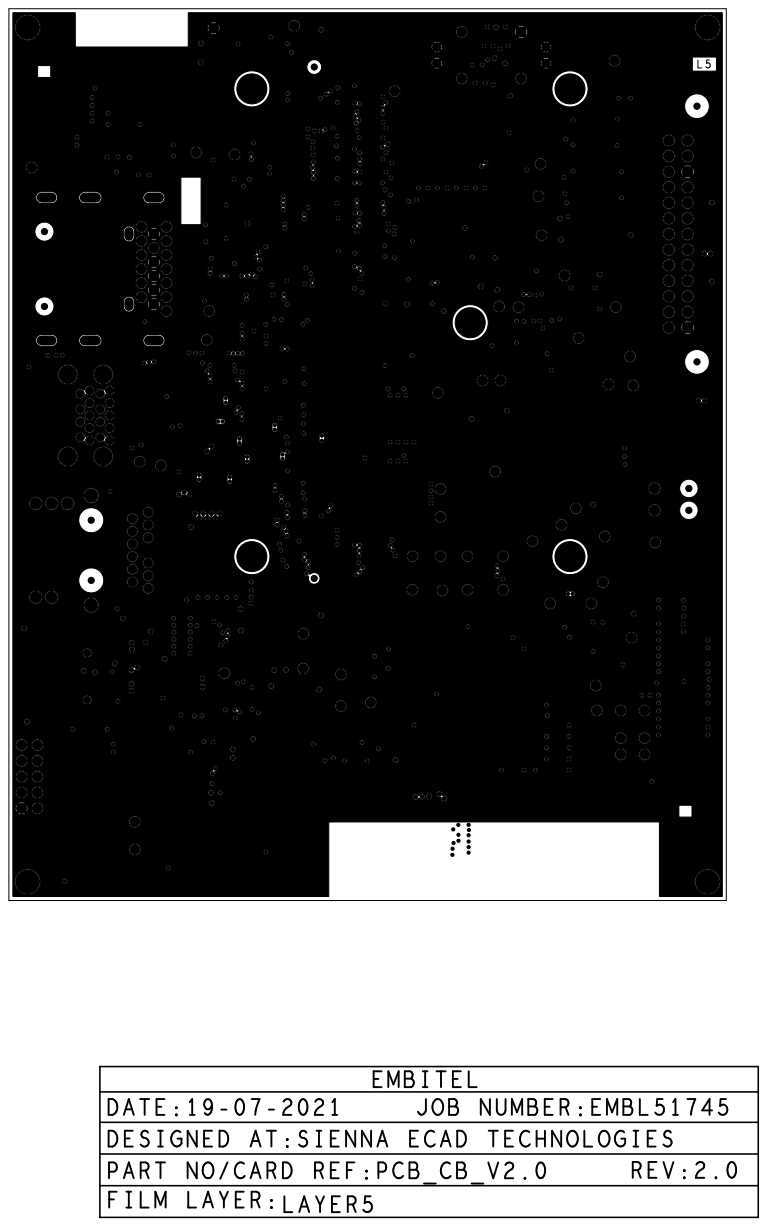
[picture p48: page 7]

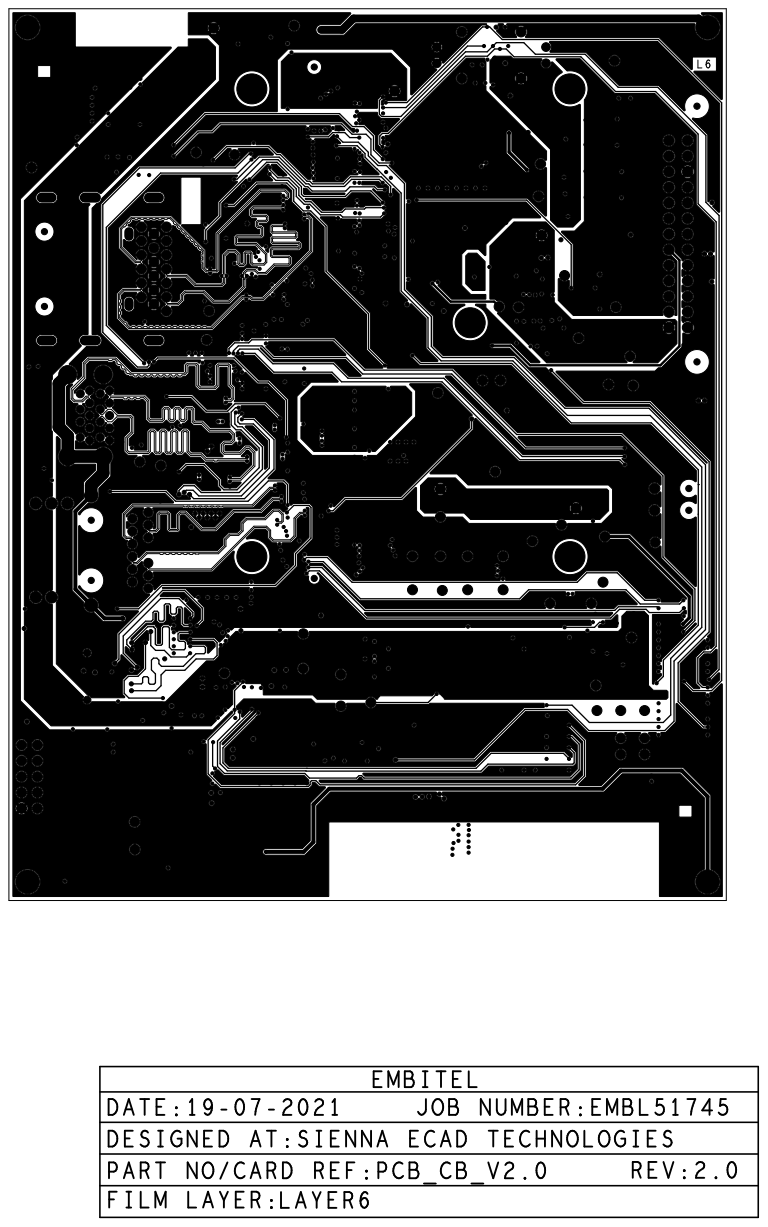
[picture p49: page 8]

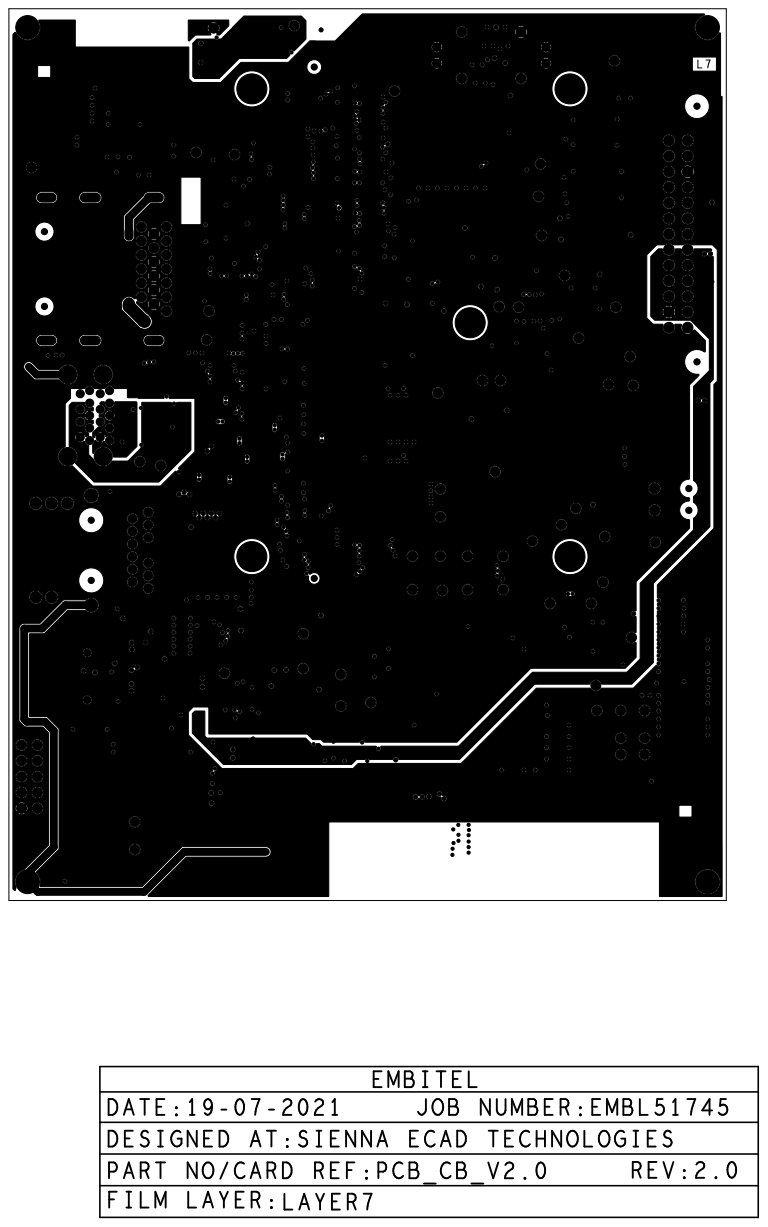
[picture p50: page 9]

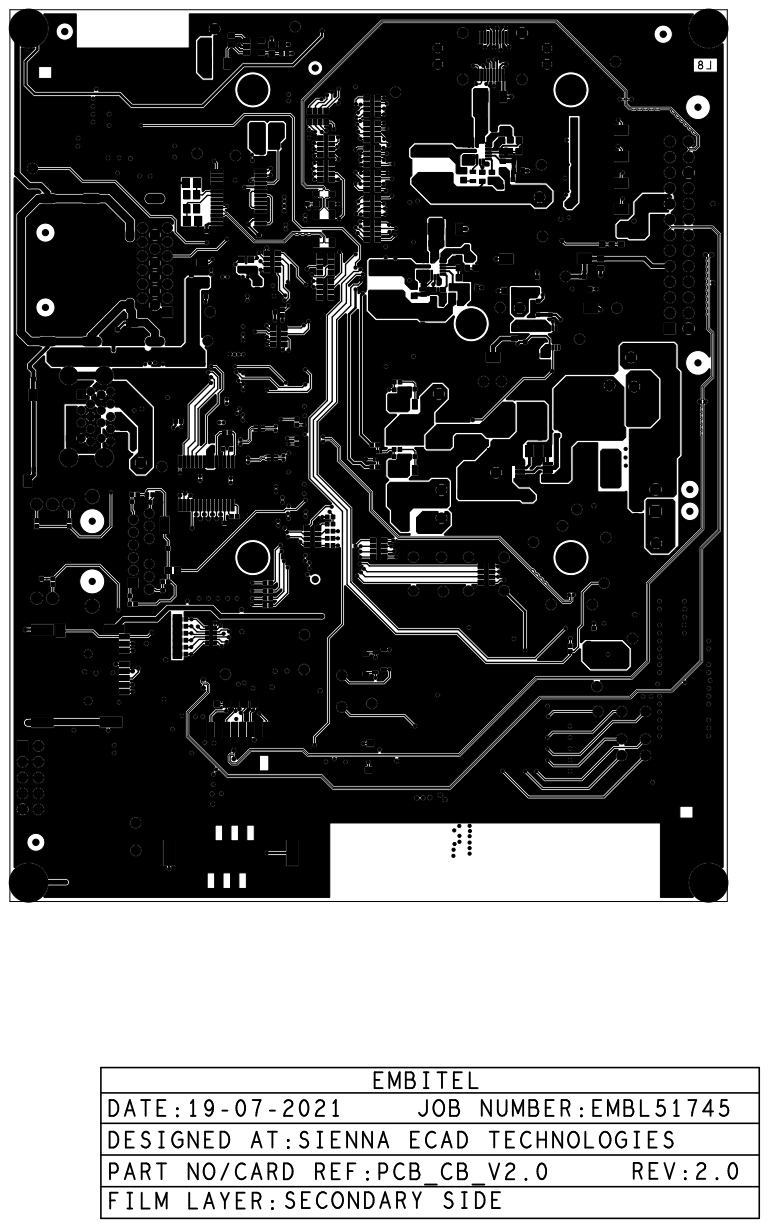
[picture p51: page 10]

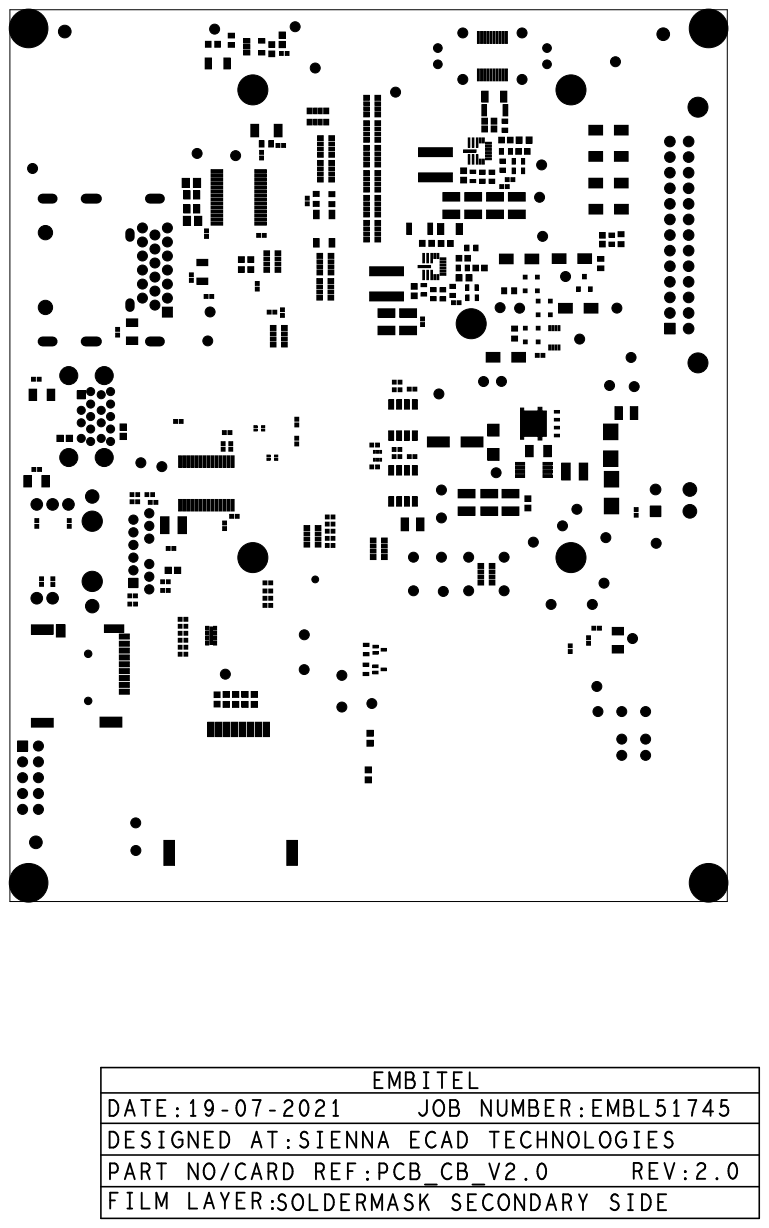
[picture p52: page 11]

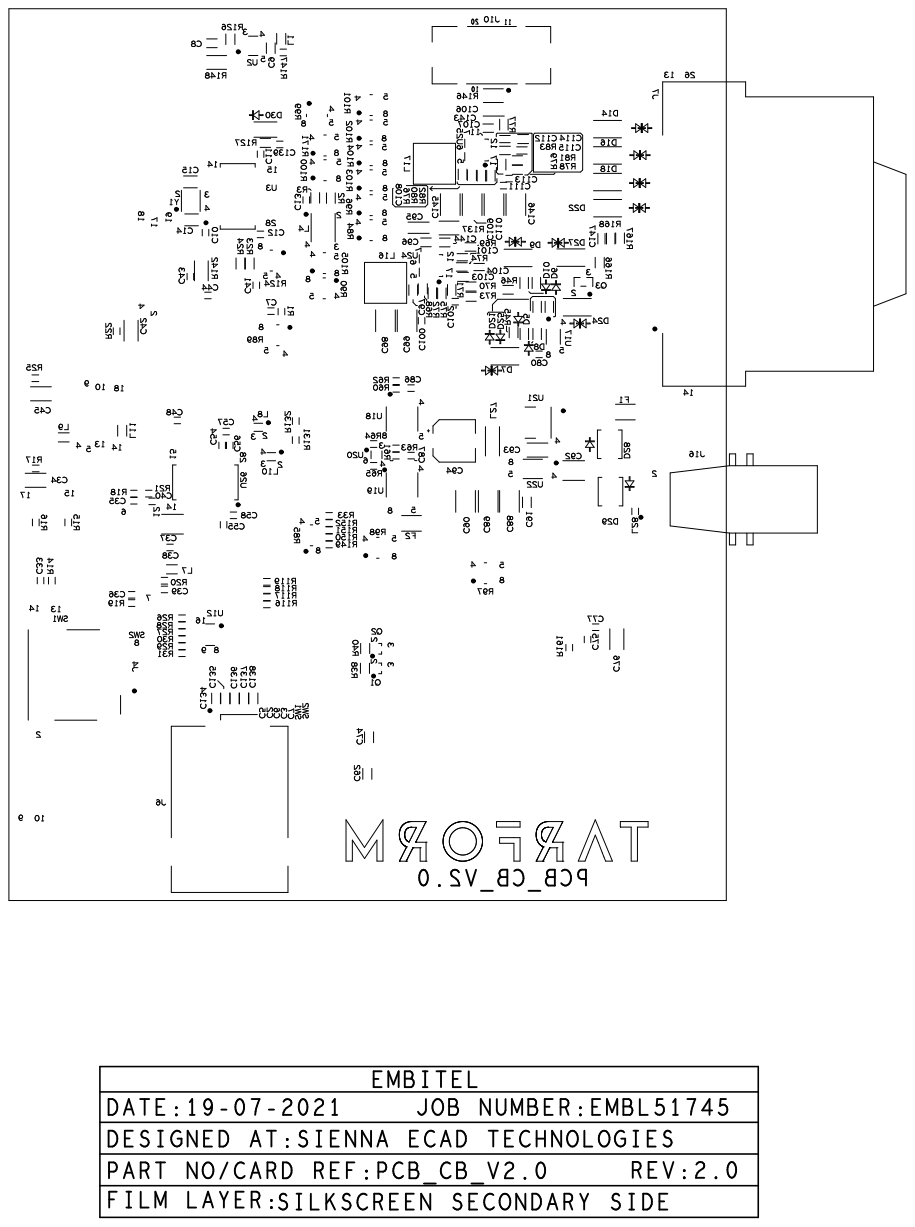
[picture p53: page 12]

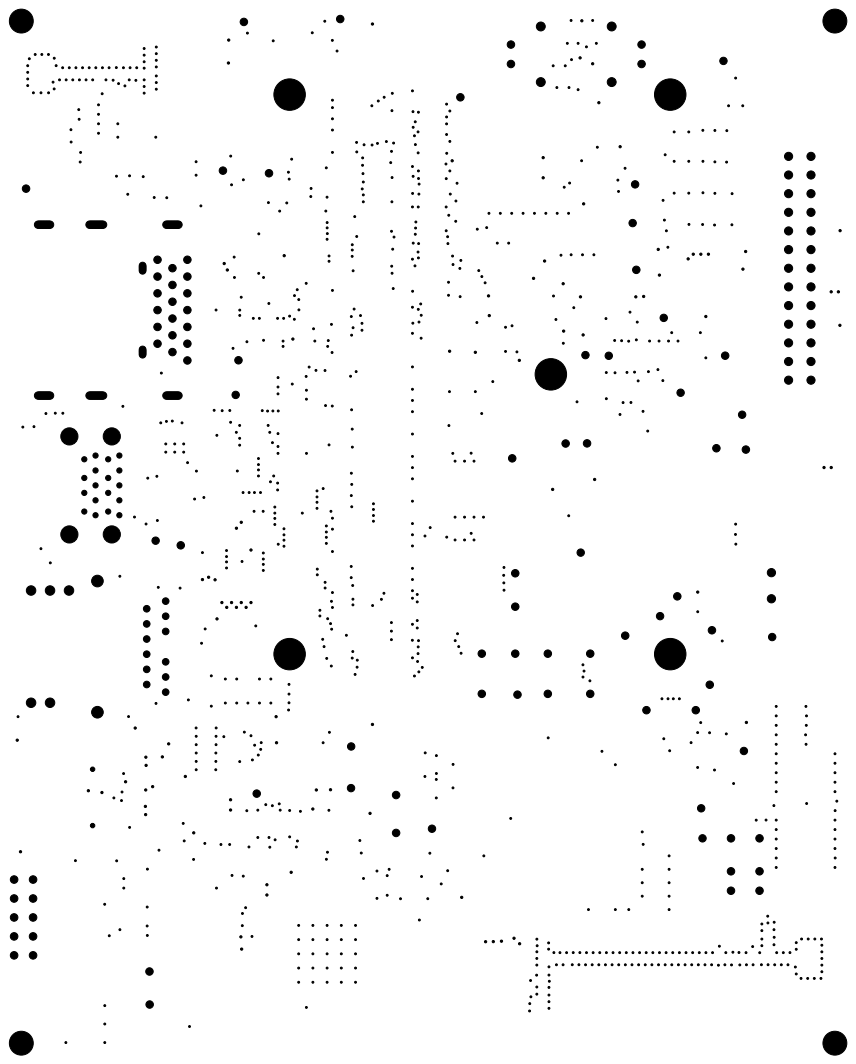
[picture p54: page 14]
