eSpark-Consulting-Group/robertmeares-vcu-bcu/Client-Files/BCU-PCBA-main/BCU-PCBA-main/BCU-PCBA/SECONDARY BOARD V2.1/GERBER/EMBL51745_PCB_SB_V2.1_DFM_20210914/LAYERS.pdf

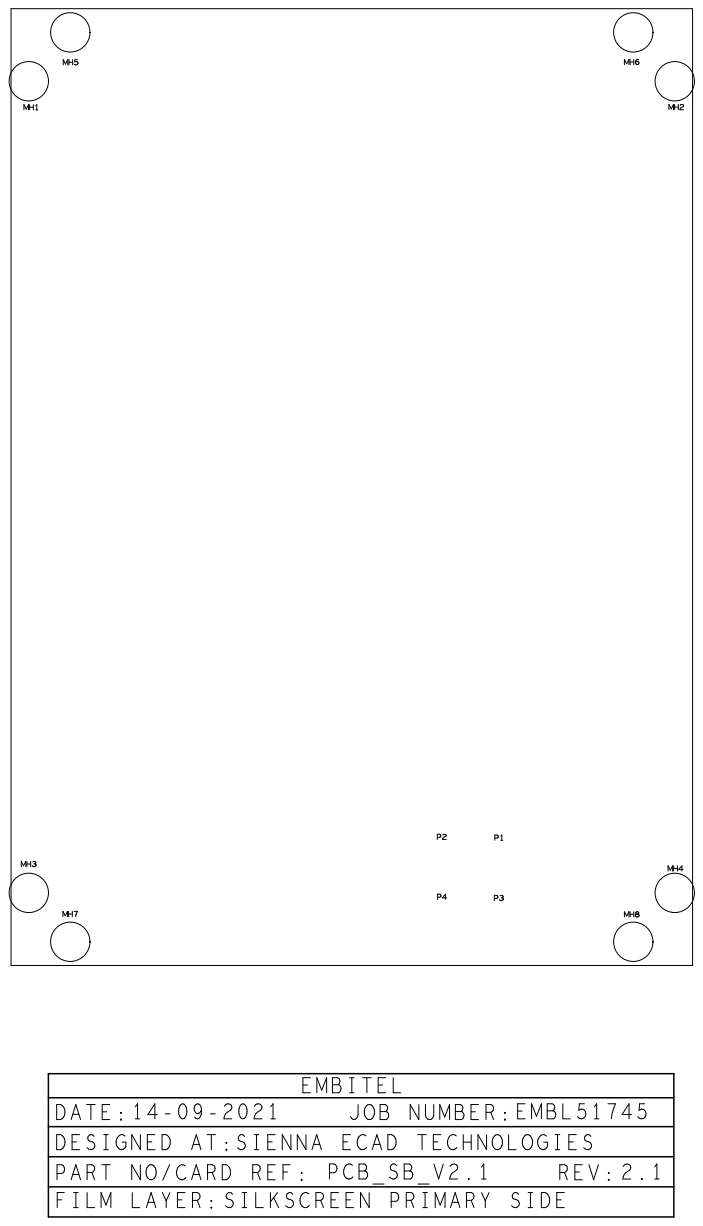
[picture p56: page 1]

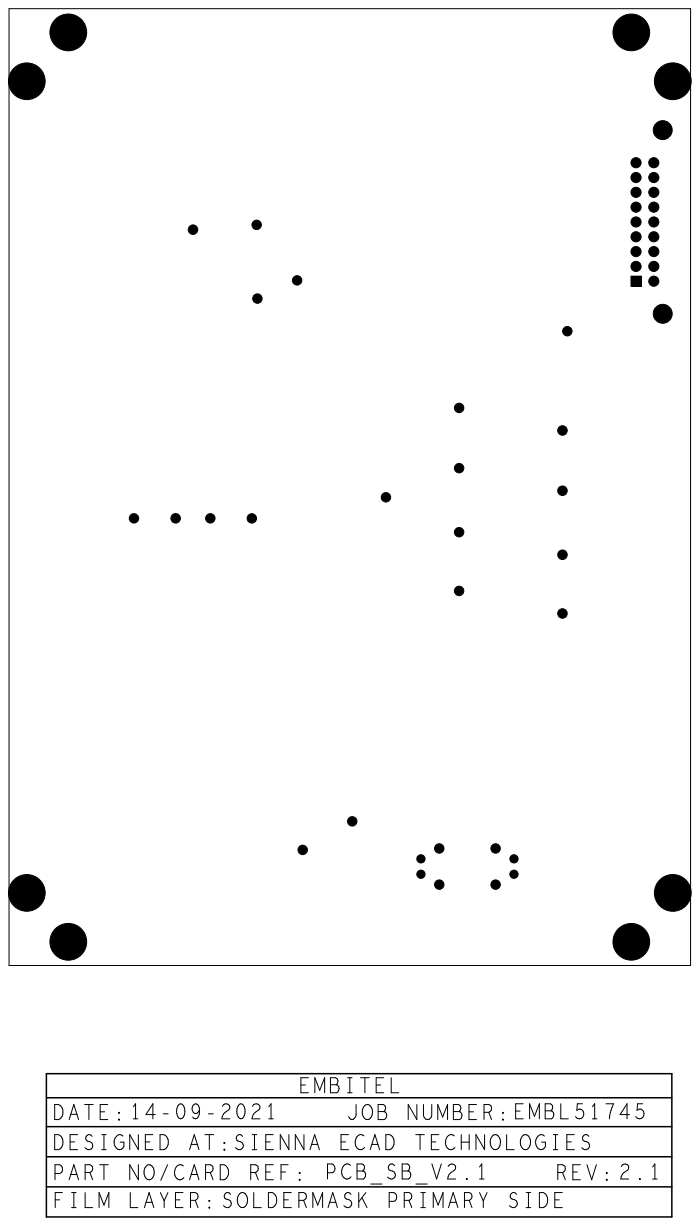
[picture p57: page 2]

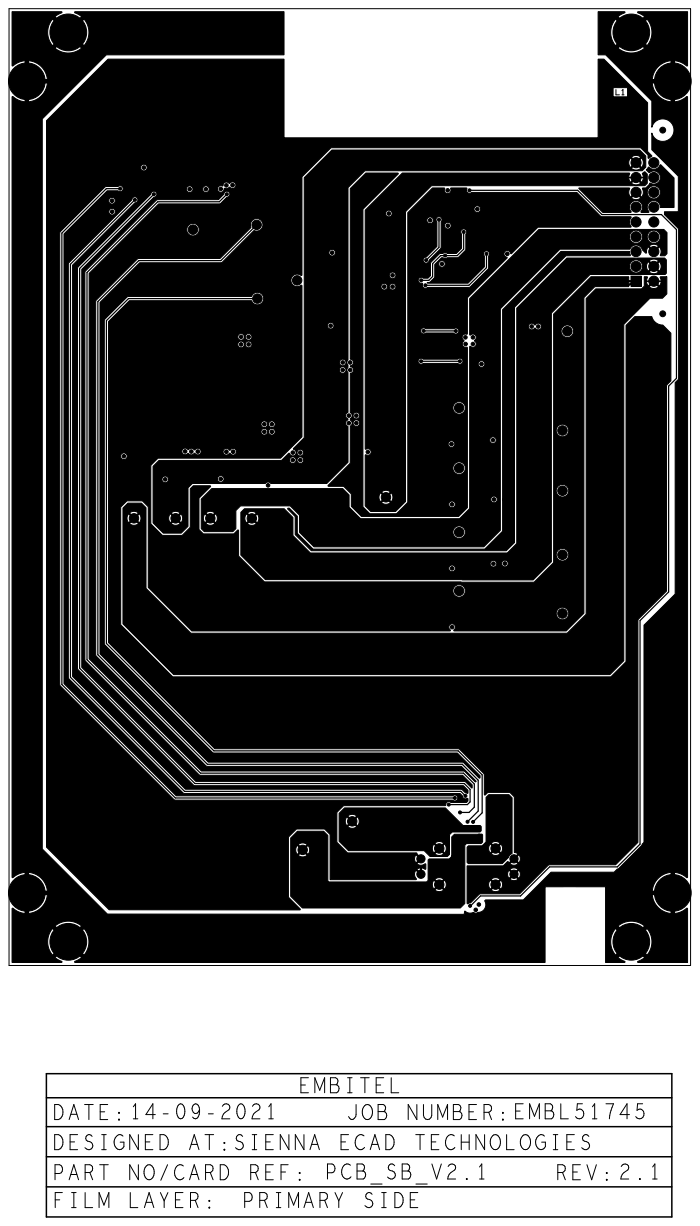
[picture p58: page 3]

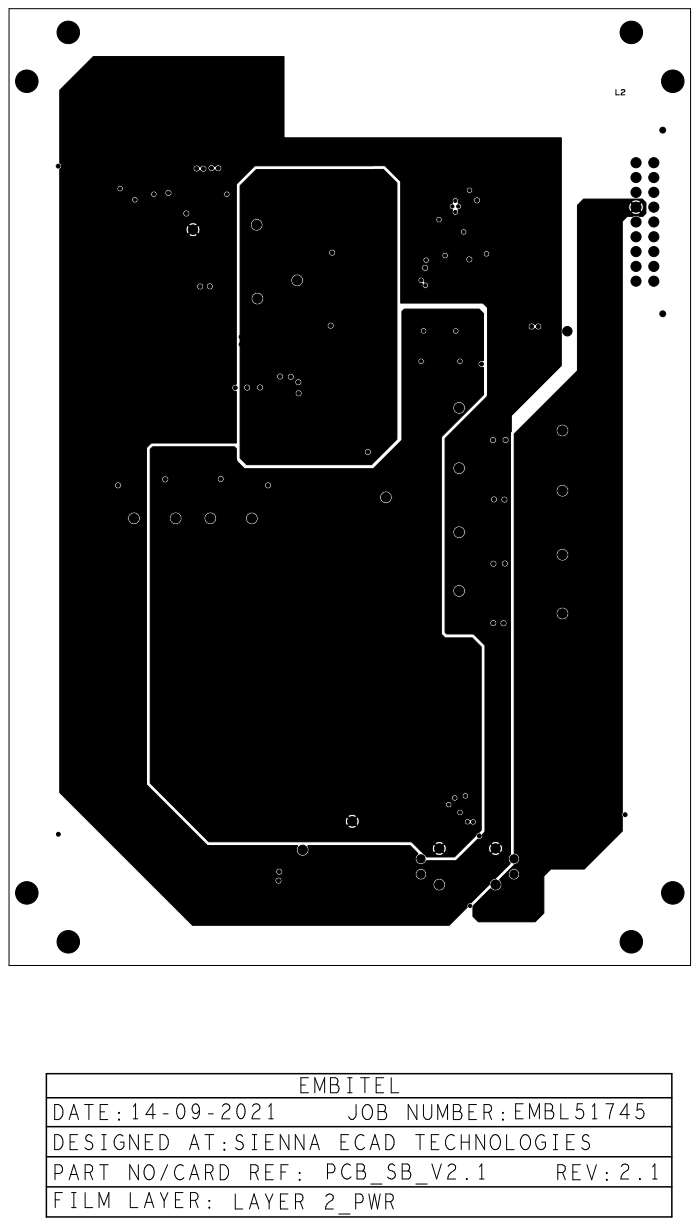
[picture p59: page 4]

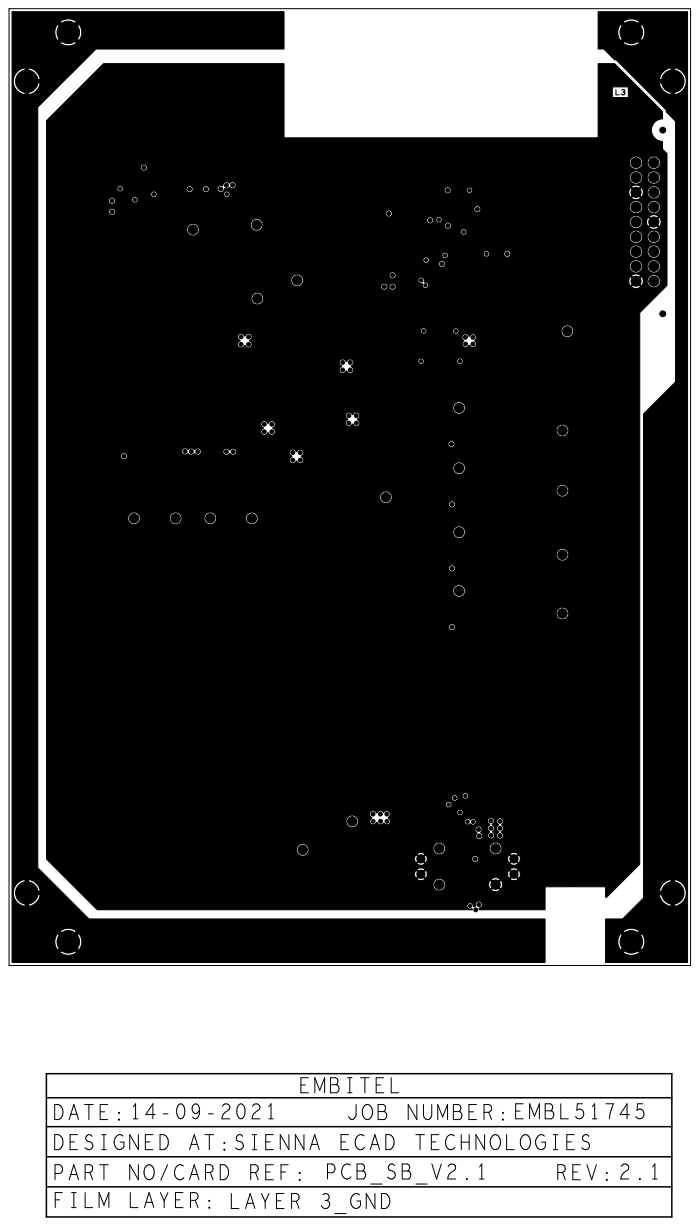
[picture p60: page 5]

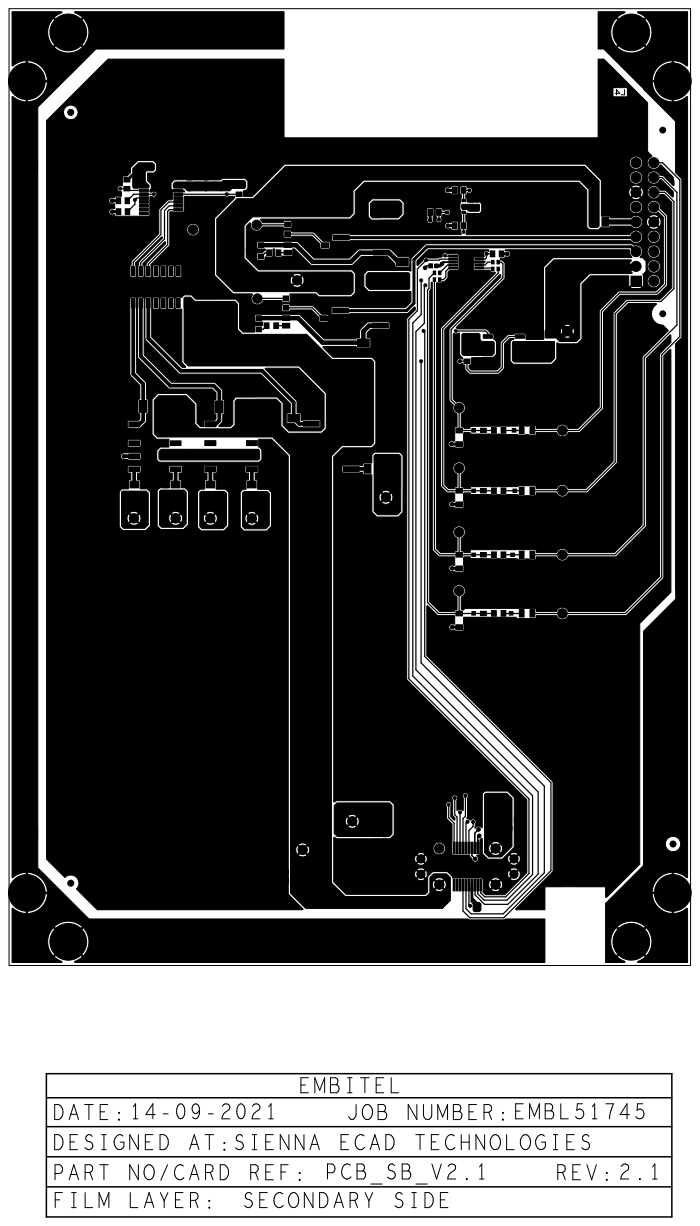
[picture p61: page 6]

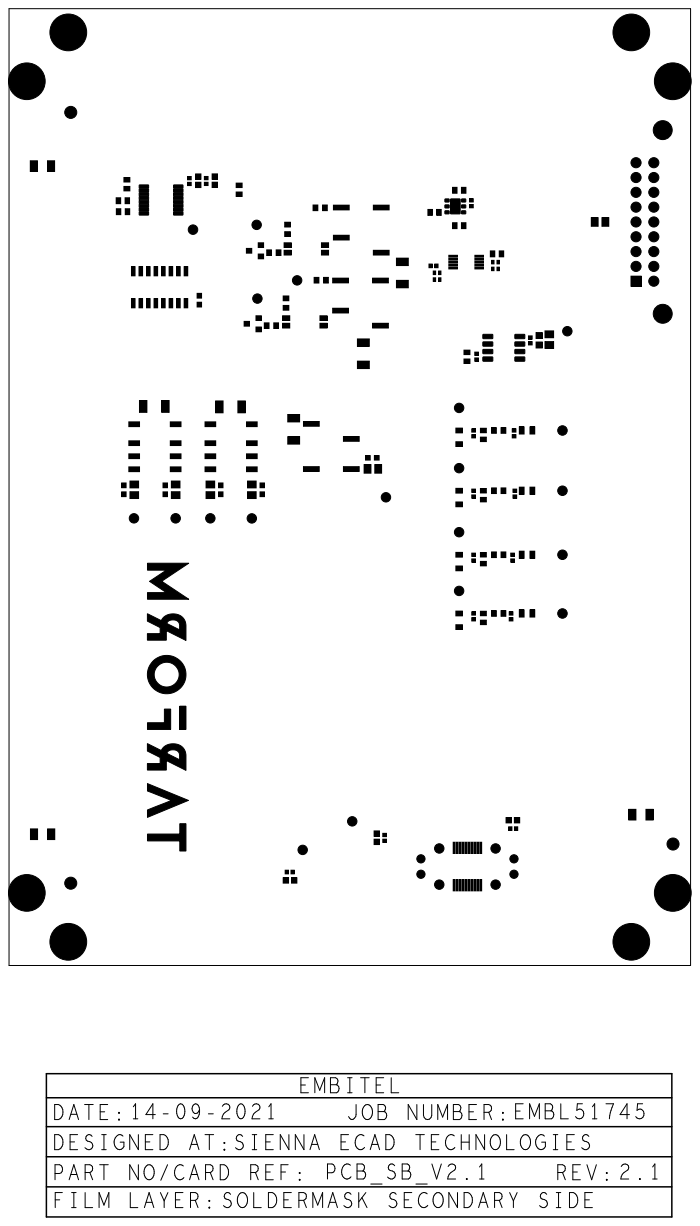
[picture p62: page 7]

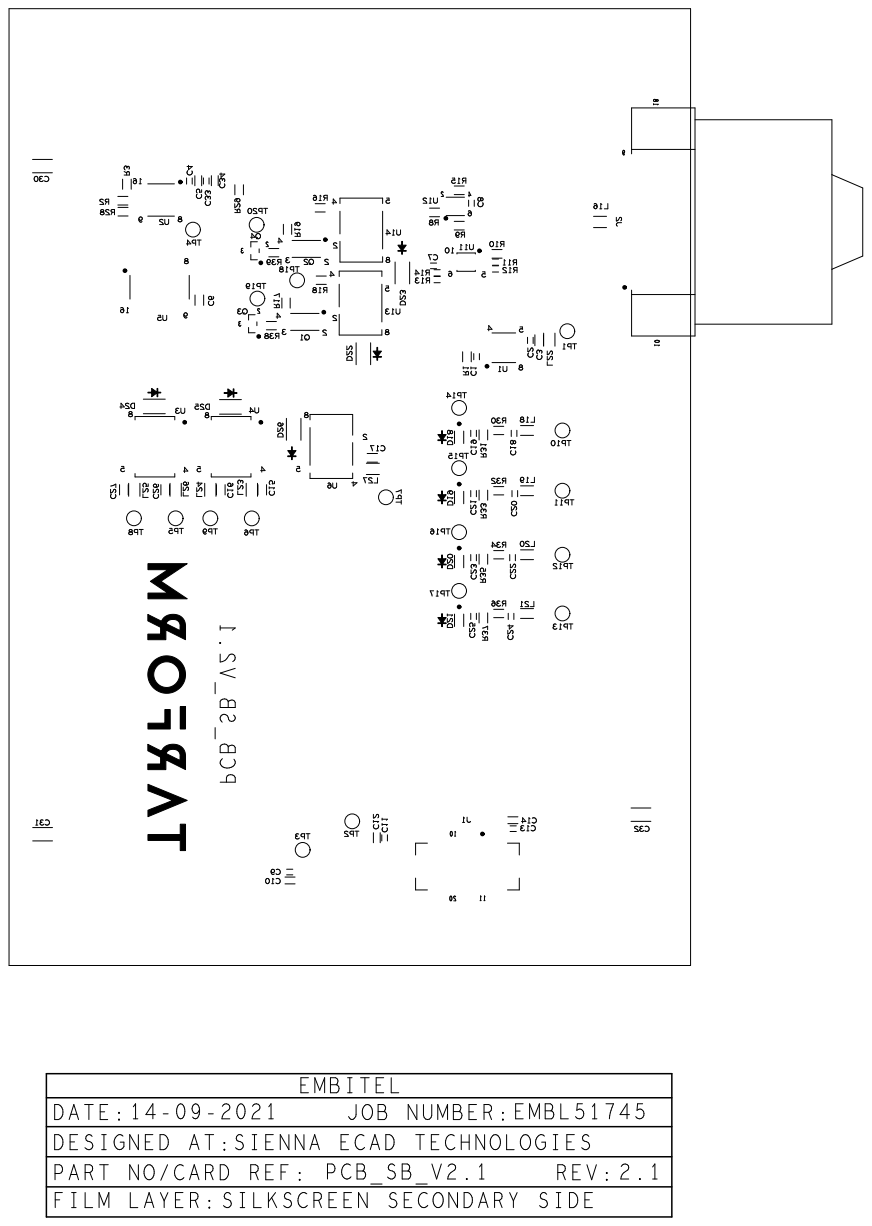
[picture p63: page 8]

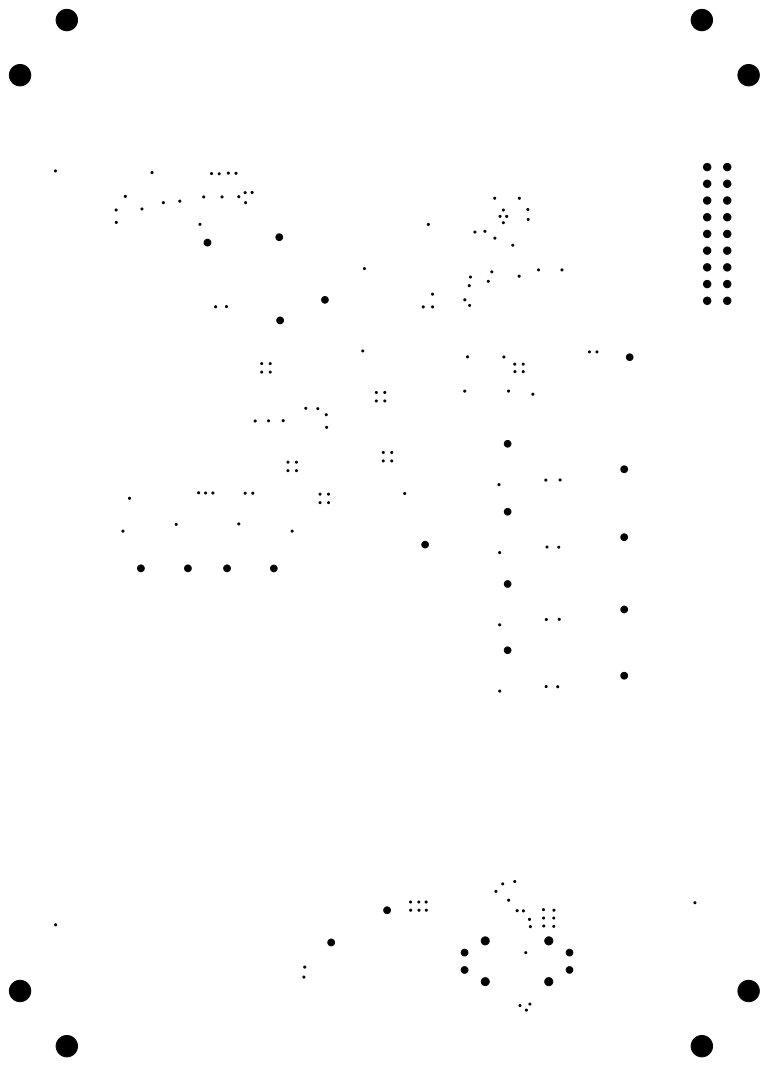
[picture p64: page 10]
