eSpark-Consulting-Group/robertmeares-vcu-bcu/(list of files, drawings)

Other design files:
Client-Files/BCU-PCBA-main/BCU-PCBA-main/BCU-PCBA/CARRIER BOARD 2.0/SCHEMATIC/16072021/16072021/EMBL51745_CARRIER CARD_SP2_V2-01.DSN
Client-Files/BCU-PCBA-main/BCU-PCBA-main/BCU-PCBA/CARRIER BOARD 2.0/SCHEMATIC/16072021/16072021/EMBL51745_CARRIER CARD_SP2_V2-01.opj
Client-Files/BCU-PCBA-main/BCU-PCBA-main/BCU-PCBA/SECONDARY BOARD V2.1/SCHEMATIC/EMBL51537_SC_SP2_V2.1_20210906.DSN
Client-Files/BCU-PCBA-main/BCU-PCBA-main/BCU-PCBA/SECONDARY BOARD V2.1/SCHEMATIC/embl51537_sc_sp2_v2.1_20210906.opj
