eSpark-Consulting-Group/robertmeares-vcu-bcu/(commit log)

2023-08-29 #2 BOM in progress
2023-09-06 CB BOM changes
2023-09-08 Mating connector part added
